tobbas75/trackline/trap-monitor/hardware/Trap Monitor/PCB FILES/preview.webp

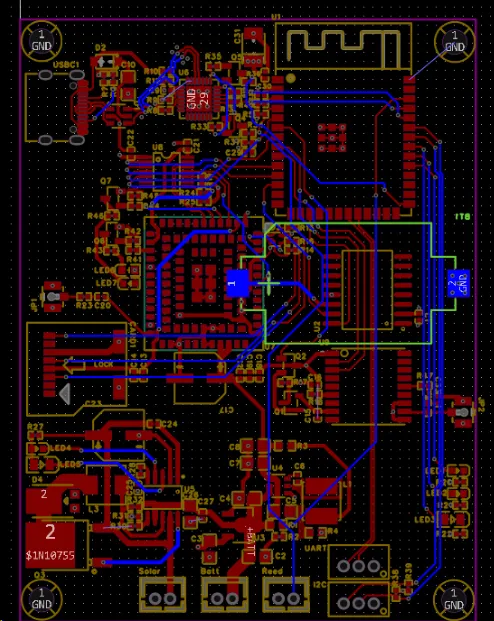
trap-monitor/hardware/Trap Monitor/PCB FILES/preview.webp
