tobbas75/trackline/trap-monitor/hardware/Trap Monitor/PCB FILES/preview (1).webp

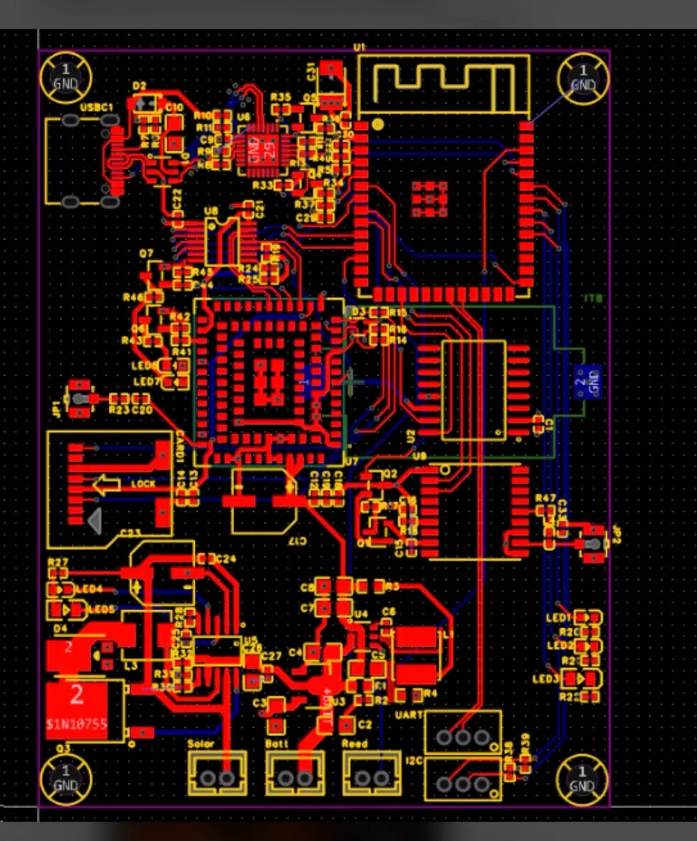
trap-monitor/hardware/Trap Monitor/PCB FILES/preview (1).webp
