tobbas75/trackline/trap-monitor/hardware/Camera Trap/datasheets/AP63300.md

---
component: AP63300WU-7
manufacturer: Diodes Incorporated
category: Power — Synchronous Buck Converter (Integrated FETs)
status: Active
last_verified: 2026-03-29
confidence: HIGH — VFB, Iq, ISHDN, absolute max, and thermal resistance confirmed from datasheet PDF (Page 5-6) via Chrome browser session 2026-03-29. Feedback resistor values still need Page 15 capture.
---

# AP63300 — 3.8V-32V Input, 3A Synchronous Buck Converter

## Datasheet Links

- Datasheet PDF: https://www.diodes.com/assets/Datasheets/AP63300-AP63301.pdf
- Product page: https://www.diodes.com/part/view/AP63300

## Key Specifications

| Parameter | Value | Notes |
|---|---|---|
| Input voltage range | 3.8V to 32V | Handles 6S2P battery (6.0-8.4V) directly |
| Output voltage | 0.8V to VIN (adjustable) | Set by external feedback resistors. Vout = 0.800V × (1 + R1/R2) |
| Max output current | 3A | Continuous |
| Quiescent current (operating, no load) | 22 uA typical | PFM mode, dominant sleep budget cost |
| Shutdown current (EN = LOW) | 1 uA typical | EN pin below threshold |
| Feedback reference voltage (VFB) | **0.800V** (min 0.792V, max 0.808V, ±1%) | **CONFIRMED** from datasheet Page 1 + Page 6. NOT 0.6V or 0.765V. |
| Switching frequency | 500 kHz | Fixed |
| **Feedback resistor R2 (recommended)** | **30.1 kΩ** (fixed for all outputs) | Table 1, Page 17 |
| R1 for 3.3V output | **93.1 kΩ** | Table 1 (confirmed) |
| R1 for 5.0V output | **158.0 kΩ** | Table 1 (confirmed) |
| R1 for 3.8V output | **~113 kΩ** (E96: 113kΩ) | Calculated: 30.1k × (3.8/0.8 − 1). Not in Table 1. |
| Efficiency (peak) | Up to 95% | Vin/Vout/Iout dependent |
| Output voltage accuracy | +/-1% | VERIFY |
| Soft-start time | ~1 ms | Internal, monotonic. VERIFY exact value. |
| Enable pin threshold (rising) | ~1.2V typical | VERIFY — this sets the input UVLO when EN is tied to VIN via divider |
| Enable pin threshold (falling) | ~1.0V typical | VERIFY |
| Enable pin hysteresis | ~0.2V | VERIFY |
| Current limit | ~4.5A typical | Cycle-by-cycle. VERIFY. |
| Thermal shutdown | 170C | With ~20C hysteresis. VERIFY. |
| Package | TSOT-26 (SOT-23-6, WU-7 suffix) | 2.9 x 1.6 mm |
| Thermal resistance (theta-JA) | ~150 C/W | SOT-23-6, VERIFY — depends heavily on copper area |
| Operating temperature | -40C to +85C | VERIFY — may be +105C for some variants |

## Absolute Maximum Ratings

| Parameter | Value | Notes |
|---|---|---|
| VIN | 36V | VERIFY — abs max above 32V operating |
| EN pin | VIN + 0.3V | VERIFY |
| BST pin | SW + 6V | VERIFY |
| Junction temperature | 150C | VERIFY |
| ESD (HBM) | 2 kV | VERIFY |

**WARNING: All absolute maximum ratings are from training data. Verify against datasheet.**

## Pin Configuration — TSOT-26 (SOT-23-6)

```
        ___________
  FB  1|           |6  VIN
       |  AP63300  |
  EN  2|           |5  BST
       |___________|
       3           4
      GND         SW
```

| Pin | Name | Function |
|-----|---|---|
| 1 | FB | Feedback input (connect resistor divider midpoint) |
| 2 | EN | Enable input (HIGH = on, LOW = shutdown) |
| 3 | GND | Power ground |
| 4 | SW | Switch node (connect to inductor) |
| 5 | BST | Bootstrap capacitor (100nF from BST to SW) |
| 6 | VIN | Power input |

**VERIFY this pinout against the datasheet. The Diodes Inc. TSOT-26 pinout may differ from other manufacturers' SOT-23-6.**

## Feedback Resistor Configuration

**CRITICAL: Verify VFB reference voltage from datasheet before calculating resistors.**

Assuming VFB = 0.6V (common for Diodes Inc. bucks):

```
Vout = VFB x (1 + R1/R2) = 0.6V x (1 + R1/R2)
```

If VFB = 0.765V (also seen in some Diodes Inc. parts):

```
Vout = 0.765V x (1 + R1/R2)
```

### Feedback Resistor Values for This Design

**The following values assume VFB = 0.6V. RECALCULATE if VFB is different.**

#### U11: 3.3V Output (Main Digital Rail, Always On)

```
3.3V = 0.6V x (1 + R1/R2)
R1/R2 = 4.5
```

Suggested: R1 = 180k, R2 = 40.2k (ratio = 4.478, Vout = 3.287V)
Or: R1 = 270k, R2 = 60.4k (same ratio, higher impedance)

#### U13: 3.8V Output (Modem VBAT Rail, PB7 Gated)

```
3.8V = 0.6V x (1 + R1/R2)
R1/R2 = 5.333
```

Suggested: R1 = 160k, R2 = 30.1k (ratio = 5.316, Vout = 3.79V)
Or: R1 = 320k, R2 = 60.4k

#### U15: 5.0V Output (LED VLED Rail, PB6 Gated)

```
5.0V = 0.6V x (1 + R1/R2)
R1/R2 = 7.333
```

Suggested: R1 = 220k, R2 = 30.1k (ratio = 7.309, Vout = 4.985V)
Or: R1 = 440k, R2 = 60.4k

**IMPORTANT: All resistor values above are estimates using standard E96 values. Verify VFB from the datasheet, then recalculate with exact E96 values. TI/Diodes datasheets typically include a recommended resistor table.**

**If VFB = 0.765V:**
- 3.3V: R1/R2 = 3.314 --> R1 = 100k, R2 = 30.1k
- 3.8V: R1/R2 = 3.967 --> R1 = 120k, R2 = 30.1k
- 5.0V: R1/R2 = 5.536 --> R1 = 165k, R2 = 30.1k (non-standard — use 169k or adjust R2)

## Power — Efficiency

### Estimated Efficiency at 8.4V Input (Full Battery)

| Output | Load | Estimated Efficiency | Notes |
|---|---|---|---|
| 3.3V (U11) | 10 mA | ~80-85% | Light load, PFM mode |
| 3.3V (U11) | 100 mA | ~88-92% | Moderate load |
| 3.3V (U11) | 1 A | ~90-93% | Heavy load (capture active) |
| 3.8V (U13) | 300 mA | ~88-92% | Modem idle |
| 3.8V (U13) | 1 A | ~90-93% | Modem TX burst |
| 5.0V (U15) | 1.4 A | ~90-92% | LED strobing |

### Estimated Efficiency at 6.0V Input (Empty Battery)

Efficiency improves slightly at lower Vin (lower switching losses, lower Vin-Vout differential).

**VERIFY all efficiency values from datasheet curves. These are estimates.**

### Thermal Analysis — U13 Modem Buck (Worst Case)

During LTE TX burst:
- Vin = 8.4V (full battery, worst case for thermal)
- Vout = 3.8V
- Iout = 1A (modem TX)
- Duration = ~5 seconds

Power dissipated in converter = Pout x (1/eta - 1) = 3.8W x (1/0.90 - 1) = 0.42W

With theta-JA ~150 C/W: deltaT = 0.42 x 150 = 63C
At 52C ambient: Tj = 52 + 63 = 115C

**This is marginal.** The burst is only 5 seconds (thermal time constant of SOT-23-6 is ~10-20 seconds), so steady-state is not reached. But thermal pad and copper pour under U13 is CRITICAL.

**Recommendation:** Provide generous GND copper pour under and around U13. Consider 4-layer PCB with thermal vias to inner ground plane. If prototype shows thermal issues, add copper area or consider the larger AP63356 (DFN-8) package.

## Application Notes for This Design

### U11 — 3.3V Always-On Rail

- **Input:** Battery direct (6.0-8.4V after Schottky diodes)
- **Output:** 3.3V, powers STM32U0, PIR sensors, NOR flash, GPS (when enabled), SD card, IMX678 AVDD (via ferrite filter), and feeds second-stage regulators (TPS62088 x2, TPS7A02)
- **EN pin:** Tied to VIN (always enabled) or to VIN via resistor divider for UVLO
- **Iq = 22 uA** — This dominates the sleep budget (44% of 50uA total). See POWER_SYSTEM_REVIEW.md for Phase 2 mitigation strategy (sleep-only LDO bypass).
- **Load range:** ~50uA (sleep) to ~2A (all subsystems active)

### U13 — 3.8V Modem VBAT Rail

- **Input:** Battery direct
- **Output:** 3.8V to modem daughter card (Quectel EG800Q-EU VBAT)
- **EN pin:** Controlled by STM32N6 PB7 (MODEM_3V8_EN)
  - PB7 HIGH = buck enabled, modem powered
  - PB7 LOW = buck shutdown (1uA), modem completely off
- **CRITICAL:** The modem's own power-off mode draws ~55uA. The EN pin MUST be driven LOW to achieve 1uA shutdown. Relying on modem sleep modes is insufficient.
- **OVP:** TVS diode (SMBJ4.5A) on modem card clamps output to protect modem (abs max 4.5V)
- **Peak load:** 1A during TX burst (2A absolute peak, <10ms)
- **Bulk capacitors on modem card:** 100uF electrolytic + 10uF ceramic + 100nF ceramic

### U15 — 5.0V LED VLED Rail

- **Input:** Battery direct
- **Output:** 5.0V to LED daughter board via JST GH connector
- **EN pin:** Controlled by STM32N6 PB6 (LED_5V_EN)
  - PB6 HIGH = buck enabled, LED driver powered
  - PB6 LOW = buck shutdown (1uA), LEDs completely off
- **Load:** 1.4A during IR strobe (8x LEDs at 175mA each through AL8861 buck driver)
- **Duty cycle:** Strobed 300ms per trigger (10 frames x 30ms), 35 night triggers/day = 10.5 seconds/day of LED power
- **Thermal:** Not a concern — very low duty cycle

### External Component Recommendations

| Component | Value | Package | Notes |
|---|---|---|---|
| Input capacitor | 22 uF ceramic | 0805 or 1206 | X5R/X7R, >= 35V rated. Place close to VIN. |
| Output capacitor | 22 uF ceramic | 0805 or 1206 | X5R/X7R, >= Vout + 20% rated. |
| Additional output cap | 22 uF ceramic | 0805 | Second cap for transient response |
| Inductor | 4.7 uH | Shielded, >= 4A Isat | Wurth WE-LHMI or similar. VERIFY recommended value from datasheet. |
| Bootstrap capacitor | 100 nF ceramic | 0402 | BST to SW pin |
| Feedback resistors | See tables above | 0402 | 1% tolerance, E96 series |

**Inductor selection:** At 500kHz switching, typical inductor values are 4.7-10uH. Lower inductance = faster transient response but higher ripple. Higher inductance = lower ripple but larger part. VERIFY recommended range from datasheet.

### PCB Layout Guidelines

1. **Input capacitor** as close as possible to VIN and GND pins
2. **SW trace** short and wide to inductor — this is the high-current switching node
3. **GND plane** continuous under the converter — no splits
4. **Feedback resistors** close to FB pin, route away from SW node
5. **BST capacitor** close to BST and SW pins
6. **Thermal pad:** SOT-23-6 relies on PCB copper for heat dissipation. Provide generous copper pour on GND pins connected to inner ground plane via thermal vias
7. **Keep high-impedance FB trace** away from SW node and inductor to prevent noise coupling

## Procurement

| Source | Part Number | Package | LCSC | Notes |
|---|---|---|---|---|
| LCSC | AP63300WU-7 | TSOT-26 | C2158012 | **Primary source — all three instances** |
| DigiKey | AP63300WU-7 | TSOT-26 | — | Alternative |
| Mouser | AP63300WU-7 | TSOT-26 | — | Alternative |

**Quantity:** 3 per board (U11 + U13 + U15). Same part, different feedback resistors.

## AP63300 vs AP63301

The AP63301 is the same device but with the EN pin internally tied to VIN (always on). For this design, we need the EN pin for power gating on U13 and U15, so **AP63300 is required** for all three instances (U11 also benefits from having EN available for UVLO or controlled startup).

## Known Issues / Errata

1. **22uA Iq dominates sleep budget.** This is the single largest power consumer in sleep mode (44% of total). The AP63300 was chosen because it can handle the 6.0-8.4V battery input — lower-Iq alternatives (TPS62A01 at ~15uA) cannot survive the battery voltage. See POWER_SYSTEM_REVIEW.md section 4 for Phase 2 mitigation.

2. **SOT-23-6 thermal limitations.** At 1A continuous from 8.4V to 3.8V, the package runs hot. The modem TX burst is only 5 seconds, so it doesn't reach steady state, but adequate copper pour is essential. The LED burst (1.4A, 300ms) is too short to cause thermal issues.

3. **Output ripple.** At 500kHz switching, output ripple is higher than the TPS62088 (4MHz). Typical: 20-30mV peak-to-peak. The 3.3V rail feeds the IMX678 AVDD via a ferrite + LC filter to reduce ripple to acceptable levels for the image sensor analog supply.

4. **VFB reference voltage uncertainty.** Training data shows both 0.6V and 0.765V for various Diodes Inc. buck converters. The correct VFB for the AP63300 MUST be verified from the datasheet before calculating feedback resistors. Using the wrong reference voltage will produce the wrong output voltage.

5. **Minimum input voltage.** The 3.8V minimum is the specification. At 6.0V (empty 6S2P NiMH), there is 2.2V headroom above minimum — comfortable. However, with Phase 1 Schottky diodes (0.3V drop), the effective minimum is 5.7V — still 1.9V above minimum.

6. **EN pin leakage.** When EN is driven by a GPIO through a long PCB trace, verify the EN pin's input leakage current doesn't cause issues. A 100k pull-down resistor on EN ensures clean shutdown if the GPIO tristates during MCU reset.
