tobbas75/trackline/trap-monitor/hardware/Camera Trap/datasheets/EKMB1303112K.md

---
component: EKMB1303112K
manufacturer: Panasonic
category: Sensor — PIR Motion (Digital Output)
status: Active
last_verified: 2026-03-28
confidence: HIGH for core specs (supply voltage, detection range, current, temperature) from Panasonic product pages and distributor listings. LIKELY for output circuit details and pinout from datasheet excerpts and application notes. VERIFY output polarity and pull-down requirement against datasheet before PCB layout.
---

# EKMB1303112K — PaPIRs Digital PIR Motion Sensor, Long-Distance Type

## Datasheet Links

- Product page: https://industrial.panasonic.com/index.php/ww/products/pt/papirs/models/EKMB1303112K
- PaPIRs EKMB catalog (Mouser): https://www.mouser.com/datasheet/2/316/papirs-ekmb-catalog-25574.pdf
- DigiKey listing: https://www.digikey.com/product-detail/en/EKMB1303112K/255-3496-ND/3046811
- RS Components datasheet: https://docs.rs-online.com/0956/0900766b815fdfa5.pdf
- Panasonic application note: https://industrial.panasonic.com/cdbs/www-data/pdf/EWA0000/ast-ind-250613.pdf

## Part Number Decoding

| Segment | Value | Meaning |
|---|---|---|
| EKM | - | PIR sensor family |
| B | - | **EKMB** = ultra-low current (1 uA), digital output, battery-optimised |
| 1303 | - | **Long-distance detection type** (12m range) |
| 112 | - | Lens variant — black polyethylene Fresnel lens |
| K | - | Package/variant suffix |

Other series for reference: EKMC = standard current (170 uA), analog or digital; AMN = legacy series.

## Key Specifications

| Parameter | Value | Notes |
|---|---|---|
| Detection type | Long-distance | 1303 series designation |
| Sensing distance | 12 m | At standard test conditions |
| Detection angle (horizontal) | ~94 deg | Approximate — VERIFY from zone diagram in catalog |
| Detection angle (vertical) | ~82 deg | Approximate — VERIFY from zone diagram in catalog |
| Output type | Open-drain FET to VDD | **ACTIVE HIGH** — see critical note below |
| Output current (max) | 100 uA | FET sourcing from VDD |
| External resistor required | **Pull-DOWN to GND, 47 kohm minimum** | NOT pull-up — see critical note |
| Standby current (Idd) | 1 uA typical | Ultra-low, battery-optimised (EKMB series) |
| Supply voltage (VDD) | 2.3V to 4.0V | |
| Operating temperature | -20C to +60C | Upper limit marginal for tropical enclosure — see design notes |
| Warm-up time | 10 s (spec), 30 s (recommended) | Allow 30 s for thermal stability after power-up |
| Signal output duration | ~2 s | Output pulse length on detection — VERIFY from datasheet |
| Package | TO-5 metal can with Fresnel lens | 3-pin through-hole |
| Lens diameter | ~9.8 mm | Black polyethylene Fresnel lens — VERIFY exact dimension |
| Body diameter (metal can) | ~9.9 mm | TO-5 standard — VERIFY |
| Height (with lens) | ~5.4 mm | VERIFY from mechanical drawing |
| Pin spacing | 2.54 mm | Standard 0.1 inch pitch — VERIFY |
| Weight | ~1.5 g | VERIFY |

## Absolute Maximum Ratings

| Parameter | Value | Notes |
|---|---|---|
| Supply voltage (VDD) | 6.0V | VERIFY — exceeding operating max, do not approach |
| Operating temperature | -20C to +60C | Same as operating range for this series |
| Storage temperature | -40C to +80C | VERIFY from datasheet |
| Output current | 100 uA max | Do not exceed — FET has limited drive |
| Soldering temperature | 260C for 10 s | VERIFY — through-hole part, standard lead-free profile |

**WARNING: Absolute maximum ratings are sourced from distributor listings and datasheet excerpts. Verify every value against the full Panasonic PaPIRs datasheet before design sign-off.**

## Pin Configuration

**Package: TO-5, 3-pin, bottom view (looking at pins from below)**

```
    ┌───────────┐
    │   Fresnel  │
    │    Lens    │
    │           │
    │  (1)  (2) │
    │     (3)   │
    └───────────┘
     Bottom view
```

| Pin | Name | Function |
|-----|---|---|
| 1 | VDD | Supply voltage (2.3-4.0V) |
| 2 | OUT (Drain) | Signal output — open-drain FET to VDD |
| 3 | GND (VSS) | Ground |

**VERIFY pin assignment from datasheet mechanical drawing. Pin identification by tab/flat on TO-5 can.**

## Output Circuit — CRITICAL DESIGN NOTE

**This is ACTIVE HIGH with a pull-DOWN resistor. This is NOT the typical open-drain-to-ground with pull-UP that most engineers assume.**

### How the output works

```
         VDD (2.3-4.0V)
          │
          ├──── Internal P-FET (source)
          │
          ├──── Pin 2 (OUT / Drain)
          │
          ├──── External 47k+ pull-DOWN to GND
          │
         GND
```

- **Idle (no detection):** Internal FET is OFF. Pin 2 floats (high impedance). External pull-down resistor pulls output LOW.
- **Detection:** Internal FET turns ON, sourcing current from VDD through FET to Pin 2. Output goes HIGH (approximately VDD minus FET Vds).
- **Output returns LOW** after detection pulse ends (~2 s) and FET turns OFF again.

### External pull-down resistor selection

The pull-down resistor must be chosen so that output current does not exceed 100 uA:

```
R_pulldown >= VDD / I_out_max
R_pulldown >= 4.0V / 100 uA = 40 kohm (minimum)
```

**Use 47 kohm or higher.** In this design: 47 kohm to GND (as specified in BOM.csv).

### Why this matters

Most PIR sensors (and most open-drain outputs generally) use an N-FET that sinks to GND, requiring a pull-UP resistor and producing an ACTIVE LOW output. The Panasonic EKMB does the opposite. If you wire it with a pull-up (as instinct suggests for "open drain"), you get VDD on the output pin at all times and never see a detection edge.

**config.h cross-reference:** PIR signals connect to STM32U0 (U0_PA0 for PIR_1, U0_PA1 for PIR_2). The U0 aggregates PIR events and wakes the STM32N6 via PIR_WAKE_FROM_U0_PIN (PG3). U0 firmware must configure EXTI on rising edge for ACTIVE HIGH.

## Detection Zone Pattern

The EKMB1303112K uses a black polyethylene Fresnel lens that creates a multi-zone detection pattern. The "1303" long-distance type has a narrower, deeper detection cone optimised for long range (12 m) rather than wide coverage.

**Zone layout (approximate — VERIFY from Panasonic catalog zone diagram):**

- Multiple detection zones arranged in a roughly conical pattern
- Horizontal coverage: ~94 deg total
- Vertical coverage: ~82 deg total
- Zone density is higher at centre, sparser at edges
- Each zone is a sector where the Fresnel lens focuses thermal IR onto the pyroelectric element
- Movement between zones (not within a single zone) triggers detection

**Dual-PIR configuration in this design:** Two EKMB1303112K sensors are angled to provide overlapping coverage across the camera field of view. Firmware on the STM32U0 OR-gates both PIR outputs — either sensor triggers a capture burst.

## Power

| State | Current | Notes |
|---|---|---|
| Standby (sensing) | 1 uA | Dominant sleep budget component is elsewhere |
| During detection pulse | ~100 uA max | Through pull-down resistor, brief |

At 3.3V supply with 47 kohm pull-down:
- Standby: 1 uA (sensor) + ~0 uA (pull-down, output LOW/float)
- Detection pulse: 1 uA (sensor) + ~70 uA (3.3V / 47k through pull-down) = ~71 uA for ~2 s

**Total daily contribution (70 triggers/day, ~2 s each):** ~140 s at ~71 uA = ~0.003 mAh — negligible.

## Application Notes for This Design

1. **Supply voltage:** Fed from 3.3V rail (always-on AP63300 U11). Within 2.3-4.0V operating range.

2. **Output connection:** Pin 2 (OUT) connects to STM32U0 GPIO with 47 kohm pull-down to GND. EXTI configured for **rising edge** (active HIGH).

3. **Warm-up blanking:** After power-up, ignore PIR outputs for 30 seconds. The spec says 10 s minimum, but thermal stability improves significantly at 30 s. Firmware on U0 implements this blanking window.

4. **PIR lockout:** config.h defines PIR_LOCKOUT_S = 5 seconds between triggers. This prevents rapid re-triggering from the same animal.

5. **Temperature concern:** Operating range is -20C to +60C. The white/light enclosure is critical — black enclosures reach 70C+ in tropical sun, which exceeds the sensor's rating. With white IP67 polycarbonate enclosure, internal temperature should stay within spec.

6. **Lens orientation:** The long-axis of the Fresnel lens pattern should be aligned with the expected animal travel direction for maximum sensitivity. In this design, both PIRs are oriented to cover the camera's field of view.

7. **Mounting:** Through-hole TO-5 package. Solder directly to main board with lens protruding through enclosure front panel. Seal with silicone gasket around lens.

## Procurement

| Source | Part Number | Stock Status | Unit Price (AUD) |
|---|---|---|---|
| DigiKey AU | 255-3496-ND | In stock | ~$7.50 |
| Mouser | - | In stock | ~$7.50 |
| RS Components | 161-2217 | In stock | ~$7.00 |

**Lead time:** Generally in stock. Standard Panasonic distribution.

## Known Issues

1. **Output polarity confusion.** The single most common mistake with this sensor. Document prominently in schematic, BOM, and review guide. The BOM.csv already notes "ACTIVE HIGH output (pull-DOWN 47k to GND, NOT pull-up)".

2. **60C upper temperature limit.** Marginal for tropical deployment. Enclosure colour and ventilation are critical. Monitor field temperature data from first deployments.

3. **No sensitivity adjustment.** The EKMB series has fixed sensitivity set by the internal signal processing. Cannot be tuned in firmware. If detection range needs changing, a different lens variant (different part number suffix) is required.

4. **Blanking period after detection.** The sensor has an internal blanking period (~2 s) after each detection. Combined with firmware lockout (5 s), effective retrigger time is ~5 s minimum.

5. **False triggers from thermal transients.** Rapid temperature changes (cloud shadow, rain splash) can cause false triggers. The dual-PIR AND/OR logic in firmware can help filter these — currently OR-gated (either PIR triggers), but could be changed to AND-gated (both PIRs must trigger) for noisy environments at the cost of detection coverage.
