tobbas75/trackline/trap-monitor/hardware/Camera Trap/datasheets/IMX678.md

---
component: IMX678-AAQR1-C
manufacturer: Sony Semiconductor Solutions
category: Image Sensor
status: Active
last_verified: 2026-03-29
confidence: MIXED — register map verified from Linux driver source; power rails and timing from Sony flyer and public documentation; full datasheet is NDA-restricted
---

# IMX678-AAQR1-C — 8MP STARVIS 2 CMOS Image Sensor

## NDA Notice

The full IMX678 datasheet is restricted under NDA from Sony Semiconductor Solutions.
Access requires a distributor relationship via **FRAMOS** (Europe/Americas) or **Macnica** (Asia-Pacific).

**What is publicly available:**
- Sony product flyer (basic specs, block diagram, package outline)
- Khadas preliminary datasheet v0.1 (partial — leaked/mirror, not authorised)
- FRAMOS FSM-IMX678 module datasheet (module-level specs, some sensor detail)
- Linux v4l2 driver source (register map, timing, clock configs — reverse-engineered/NDA-derived)
- Macnica product page (marketing specs)

**What requires NDA access:**
- Full register map with bit-field descriptions
- Detailed power-on/power-off sequence timing diagrams
- Complete electrical characteristics (min/typ/max for all rails)
- Absolute maximum ratings (complete table)
- Detailed MIPI CSI-2 D-PHY timing parameters
- Optical characteristics (spectral response curves, quantum efficiency)
- Reliability data and qualification reports

## Datasheet Links

| Source | URL | Access |
|---|-----|---|
| Sony product flyer | https://www.sony-semicon.com/files/62/flyer_security/IMX678-AAQR1_Flyer.pdf | Public |
| Khadas mirror (v0.1 preliminary) | https://dl.khadas.com/products/add-ons/cameras/imx678/datasheet/imx678-aaqr1-c_technical-datasheet_e_0.1.pdf | Public (unofficial) |
| FRAMOS FSM-IMX678 module | https://www.mouser.com/datasheet/2/1051/FSM_IMX678_Datasheet-3512461.pdf | Public (module-level) |
| Macnica product page | https://www.macnica.com/americas/mai/en/products/semiconductors/sony-image-sensors/sony-imx678-aaqr1/ | Public |
| Linux v4l2 driver (register map) | https://github.com/will127534/imx678-v4l2-driver | Public (GPL) |
| Sony ISP portal (full datasheet) | Via FRAMOS/Macnica NDA | ~~NDA required~~ **OBTAINED** |
| **Production datasheet E21Y08A29** | Local: `datasheets/imx678-datasheet-E21Y08A29.pdf` | **56 pages, Maison Technologies watermark. All TBDs filled. STARVIS 2.** |
| **Tentative datasheet Rev 0.1** | Local: `datasheets/imx678-datasheet.pdf` | **53 pages, Sunnic watermark. Some TBDs remain. Has peripheral circuit.** |

## Key Specifications

| Parameter | Value | Source | Confidence |
|---|---|---|---|
| Optical format | 1/1.8" (Type 1/1.8) | Sony flyer | Verified |
| Pixel size | 2.0 µm × 2.0 µm | Sony flyer | Verified |
| Effective pixels | 3840 (H) × 2160 (V) = 8.29 MP | Sony flyer / driver | Verified |
| Native array (incl. OB) | 3856 (H) × 2180 (V) | Linux driver | Verified (from driver) |
| Pixel array offset | 8 pixels left, 8 pixels top | Linux driver | Verified (from driver) |
| Technology | STARVIS 2 (back-illuminated) | Sony flyer | Verified |
| Colour filter | Bayer RGB (RGGB) — AAQR1 variant | Sony flyer | Verified |
| ADC resolution | 12-bit (native), 11-bit + dither mode | Linux driver | Verified (from driver) |
| HDR | ClearHDR (Sony proprietary DOL-HDR) | Sony flyer / driver | Verified |
| Output interface | MIPI CSI-2 (2-lane or 4-lane) | Sony flyer / driver | Verified |
| Control interface | I2C (SCCB compatible) | Sony flyer / driver | Verified |
| I2C address | 0x1A (7-bit) | Linux driver / config.h | Verified (from driver) |
| Operating temperature | **-30°C to +85°C** | Production datasheet Page 3 | **CONFIRMED** |
| Performance guarantee temp | **-10°C to +60°C** | Production datasheet Page 3 | **CONFIRMED** |
| Storage temperature | **-40°C to +85°C** | Production datasheet Page 3 | **CONFIRMED** |

## Power Supply Rails

### Application Conditions — CONFIRMED from Production Datasheet (E21Y08A29 Page 3/14)

| Rail | Symbol | Min | Typ | Max | Unit |
|---|---|-----|-----|-----|---|
| Analog supply | AVDD | **3.20** | 3.30 | **3.40** | V |
| Digital I/O | OVDD | **1.70** | 1.80 | **1.90** | V |
| Digital core | DVDD | **1.00** | 1.10 | **1.20** | V |

Driver regulator names: `VANA` = AVDD (3.3V), `VDIG` = DVDD (1.1V), `VDDL` = DOVDD (1.8V).

### Current Consumption — CONFIRMED from Production Datasheet (E21Y08A29 Page 15)

Measured at 4-lane×2ch, 1188 Mbps, 12-bit, 60fps, all-pixel mode.

| Condition | Rail | Symbol | Typ | Max | Unit |
|---|---|---|-----|-----|---|
| **Operating** | AVDD (3.3V) | IAVDD | **69** | **86** | mA |
| | OVDD (1.8V) | IOVDD | **4** | **5** | mA |
| | DVDD (1.1V) | IDVDD | **162** | **175** | mA |
| **Standby** | AVDD (3.3V) | IAVDD_STB | — | **0.3** | mA |
| | OVDD (1.8V) | IOVDD_STB | — | **0.1** | mA |
| | DVDD (1.1V) | IDVDD_STB | — | **28** | mA |

**Operating total power (typ):** 69×3.3 + 4×1.8 + 162×1.1 = 228 + 7 + 178 = **~413 mW**
**Standby total power (max):** 0.3×3.3 + 0.1×1.8 + 28×1.1 = 1.0 + 0.2 + 30.8 = **~32 mW** (this is why we hard power-gate)

> **Note:** These figures are at 4-lane×2ch mode. Our design uses 2-lane mode — DVDD current will be lower (fewer MIPI drivers active). Estimated 2-lane operating: IDVDD ~100-130 mA max.

### Sensitivity — CONFIRMED from Production Datasheet (E21Y08A29 Page 23)

Measured at AVDD=3.3V, OVDD=1.8V, DVDD=1.1V, Tj=60°C, all-pixel, 12-bit, 30fps, 0dB gain.

| Parameter | Min | Typ | Unit | Mode |
|---|-----|-----|---|---|
| G sensitivity (HCG) | 13493 (3009 mV) | **16309** (3637 mV) | Digit/lx/s | HCG, F5.6 |
| G sensitivity (LCG) | 5197 (1159 mV) | **6117** (1364 mV) | Digit/lx/s | LCG, F5.6 |
| Saturation (LCG) | **3895** (868 mV) | — | Digit | 12-bit |
| HCG/LCG ratio | 2.4 | **2.7** | — | — |

**1 Digit = 0.2230 mV (12-bit), 0.8925 mV (10-bit)**

### Spectral Response — CONFIRMED from Production Datasheet (E21Y08A29 Page 22)

The spectral sensitivity chart (wafer-level) shows:
- **Peak sensitivity** at ~500nm (green) and ~800nm (NIR) — the characteristic STARVIS 2 dual-peak
- All three channels (R, G, B) converge above 750nm where the Bayer filter becomes transparent
- **At 850nm:** relative response ~0.85 (all channels) — excellent for 850nm IR illumination
- **At 940nm:** relative response ~0.45-0.50 (all channels) — usable for 940nm covert IR
- **At 1000nm:** relative response ~0.15-0.20 — dropping off but still detectable
- **Cutoff ~1050nm** — consistent with silicon bandgap

> This confirms that 940nm covert IR illumination will produce usable images. The STARVIS 2 uneven photodiode surface enhances NIR absorption — the 940nm response is approximately 2× better than comparable STARVIS 1 sensors at the same pixel size.

## Power-On Sequence

**Sequence CONFIRMED from production datasheet E21Y08A29 Pages 41-43:**

1. **DVDD (1.1V)** — enable first
2. **DOVDD (1.8V)** — enable second
3. **AVDD (3.3V)** — enable third
4. All rails must be stable within 200 ms of sequence start (unverified — commonly cited but may be from preliminary docs)
5. After all rails stable, release XCLR (drive HIGH)
6. Wait for sensor internal PLL lock before I2C access

**Power-off sequence:** Reverse order (assert XCLR LOW, then disable AVDD → DOVDD → DVDD).

**From Linux driver timing constants:**
- XCLR release delay: 500 ms (conservative — driver uses 500,000 µs)
- XCLR delay range: 1 ms
- Stream enable delay: 25 ms after mode registers written
- Stream delay range: 1 ms

## Pin Configuration

The IMX678 uses a **132-pin LGA** package (confirmed Sony flyer Ver. 2.0). Full pinout requires NDA.

### Drive Modes — CONFIRMED from Sony Flyer Ver. 2.0

| Drive Mode | Recording Pixels | Max FPS (10-bit) | Max FPS (12-bit) |
|---|---|---|---|
| All-pixel scan | 3840 × 2160 (8.29M) | **72 fps** | **60 fps** |
| H/V 2/2-line binning | 1920 × 1080 (2.07M) | **72 fps** | — |

### Physical — CONFIRMED from Sony Flyer

| Parameter | Value |
|---|---|
| Image size | Diagonal 8.86mm (Type 1/1.8") |
| Total pixels | 3856 (H) × 2200 (V) |
| Effective pixels | 3856 (H) × 2180 (V) |
| Recommended recording | 3840 (H) × 2160 (V) |
| Unit cell | 2.0 × 2.0 µm |
| Package | **132-pin LGA** |

### Khadas Datasheet — UNAVAILABLE
Khadas-hosted Sony technical datasheet (imx678-aaqr1-c_technical-datasheet_e_0.1.pdf) returns 404 as of March 2026. The Khadas docs page exists but shows "This topic does not exist yet". **Full electrical specs remain NDA-restricted via FRAMOS/Macnica.**

**Key functional pins (from public sources):**

| Pin | Function | Notes |
|-----|---|---|
| INCK | Input clock | External oscillator input (24 MHz in this design) |
| XCLR | Reset | Active LOW. Must be held LOW during power-up, released after rails stable. Driver treats as active-high GPIO (inverted in HW or DT). |
| SDA | I2C data | DOVDD-referenced (1.8V). Requires level shifting from 3.3V MCU. |
| SCL | I2C clock | DOVDD-referenced (1.8V). Requires level shifting from 3.3V MCU. |
| MIPI_CLK_P/N | CSI-2 clock lane | Differential, DOVDD-referenced |
| MIPI_D0_P/N | CSI-2 data lane 0 | Differential |
| MIPI_D1_P/N | CSI-2 data lane 1 | Differential |
| MIPI_D2_P/N | CSI-2 data lane 2 | 4-lane mode only |
| MIPI_D3_P/N | CSI-2 data lane 3 | 4-lane mode only |
| XVS | Vertical sync output/input | Configurable direction (leader/follower) |
| XHS | Horizontal sync output/input | Configurable direction (leader/follower) |
| PWDN | Power-down | Active HIGH (DOVDD-referenced). Pull-up to 1.8V = standby on boot. |

## MIPI CSI-2 Interface

### Lane Configuration (from Linux driver — verified)

| Register | Address | Value | Meaning |
|---|---|---|---|
| LANEMODE | 0x3040 | 0x01 | 2-lane mode |
| LANEMODE | 0x3040 | 0x03 | 4-lane mode |

### Supported Link Frequencies (from Linux driver — verified)

| DATARATE_SEL | Link Frequency | Data Rate per Lane | Notes |
|---|---|---|---|
| 0x07 | 297 MHz | 594 Mbps | Lowest |
| 0x06 | 360 MHz | 720 Mbps | |
| 0x05 | 445.5 MHz | 891 Mbps | |
| 0x04 | 594 MHz | 1188 Mbps | |
| 0x03 | 720 MHz | 1440 Mbps | Default in RPi driver |
| 0x02 | 891 MHz | 1782 Mbps | |
| 0x01 | 1039.5 MHz | 2079 Mbps | |
| 0x00 | 1188 MHz | 2376 Mbps | Highest — D-PHY v1.2 max |

**D-PHY version:** Likely D-PHY v1.2 based on max 2376 Mbps/lane. Needs NDA confirmation.

### Frame Rates (from Linux driver — verified)

**4K (3856 × 2180), 4-lane, 12-bit:**

| Link Frequency | Min HMAX | Approx Max FPS |
|---|---|---|
| 297 MHz | 1584 | ~21 fps |
| 445.5 MHz | 1100 | ~30 fps |
| 720 MHz | 660 | ~50 fps |
| 1188 MHz | 396 | ~83 fps |

**1080p binned (1928 × 1090), 4-lane:** Halve the HMAX values above (double the frame rate).

**2-lane mode:** Double the HMAX values (halve the frame rate).

## Input Clock (INCK)

### Supported Frequencies (from Linux driver — verified)

| XCLK Frequency | INCK_SEL Register (0x3014) |
|---|---|
| 74.250 MHz | 0x00 |
| 37.125 MHz | 0x01 |
| 72.000 MHz | 0x02 |
| 27.000 MHz | 0x03 |
| **24.000 MHz** | **0x04** — used in this design |
| 36.000 MHz | 0x05 |
| 18.000 MHz | 0x06 |
| 13.500 MHz | 0x07 |

**Pixel rate:** 74.25 MHz (constant, independent of INCK selection — internal PLL generates this).

**This design uses 24.000 MHz** from a dedicated SiT8008 MEMS oscillator (Y2), wired directly to the IMX678 INCK pin. The oscillator is power-gated with the sensor 1.8V rail.

> **All 8 frequencies confirmed** by both the Sony AAQR1 flyer (Ver. 2.0 Page 1) and Linux V4L2 driver register map. The register values above are from the driver; the frequency list from Sony matches exactly.

## Image Sensor Characteristics — CONFIRMED from Sony Flyer Ver. 2.0 Page 2

| Parameter | Value | Condition |
|---|---|---|
| Sensitivity (F5.6) | Typ. **15886 Digit/lx/s** | 12-bit converted, Tj = 60°C |
| Saturation signal | Min. **3895 Digit** | 12-bit converted, Tj = 60°C |

### Gain — from Sony Flyer Page 1

| Range | Type | Step |
|---|---|---|
| 0 dB to 30 dB | Analog gain (CDS/PGA) | 0.3 dB |
| 30.3 dB to 72 dB | Analog 30dB + Digital 0.3-42 dB | 0.3 dB |

### HDR Modes — from Sony Flyer Page 1

- **DOL HDR** (Digital Overlap): Two successive exposures (short + long), synthesized. Slight time lapse between shots — can cause motion artifacts.
- **Clear HDR**: Two simultaneous captures at different gain levels (low for bright regions, high for dark regions), synthesized. No motion artifacts — better for moving targets like animals.

> **For this camera trap:** Clear HDR is the preferred mode if HDR is implemented (Phase 2). DOL HDR would cause motion blur on fast-moving animals. However, HDR halves frame rate — at 72fps base, Clear HDR gives 36fps. Not planned for Phase 1.

### STARVIS 2 Technology — from Sony/Macnica Technology Guide

- Back-illuminated pixel with deeper photodiodes + uneven surface textures
- NIR sensitivity enhanced by refracting incident light deeper into silicon
- Sensitivity ≥2000 mV/µm² (706 cd/m², F5.6, 1s accumulation)
- Dynamic range >8dB wider than STARVIS 1 at same pixel size (12-bit single exposure)
- NIR improvement comes from photodiode structure, not filter — works across entire NIR band to silicon cutoff (~1050nm)

### CSI-2 Output Options — from Sony Flyer Page 1

| Mode | Lanes | Notes |
|---|---|---|
| 2-lane | 2 | **Used in this design** (STM32N6 has 2-lane CSI-2 only) |
| 4-lane | 4 | Higher throughput, not available on STM32N6 |
| 8-lane | 8 | For high-end NVR/ISP chips |
| 4-lane × 2ch | 4+4 | Dual independent outputs |

Output formats: RAW10, RAW12.

## XCLR Reset Pin

| Parameter | Value | Source |
|---|---|---|
| Active level | LOW (assert LOW to reset) | Linux driver / config.h |
| Pull-up | 10 kΩ to DOVDD (1.8V) | Design spec |
| Release delay | 500 ms after power rails stable | Linux driver (conservative) |
| Interface level | DOVDD-referenced (1.8V) | Design spec |

**Implementation note:** STM32N6 PC8 is on VDDIO4 (3.3V). Open-drain output mode is mandatory to avoid driving 3.3V into the 1.8V sensor input. The 10 kΩ pull-up to 1.8V provides the HIGH level.

## 2×2 Binning Mode

| Register | Address | Value | Mode |
|---|---|---|---|
| ADDMODE | 0x301B | 0x00 | No binning (full 4K: 3856 × 2180) |
| ADDMODE | 0x301B | 0x01 | 2×2 binning (1080p: 1928 × 1090) |

**Binning benefits:**
- Doubles frame rate at same link frequency
- Improves low-light sensitivity (~6 dB gain from 4-pixel summation)
- Used for night mode in this design (with 940nm IR strobed illumination)
- Reduces PSRAM bandwidth requirement

## NIR Response

| Parameter | Value | Confidence |
|---|---|---|
| Technology | STARVIS 2 back-illuminated — enhanced NIR QE vs front-illuminated | Verified (Sony marketing) |
| Useful NIR range | Good response at 850nm and 940nm | Likely — consistent with STARVIS 2 marketing |
| NIR cutoff | ~1050 nm (approximate) | Uncertain — needs spectral response curve from NDA datasheet |
| 940nm covert operation | Yes — adequate sensitivity for strobed IR | Likely — based on STARVIS 2 product positioning for security |

**Design note:** This camera uses 940nm covert IR (no visible glow). The IMX678 STARVIS 2 technology was specifically chosen for its improved NIR quantum efficiency vs earlier STARVIS 1 sensors. Exact QE at 940nm requires the NDA spectral response data.

## Key Register Map (from Linux driver — verified)

| Register | Address | Description | Notes |
|---|---|---|---|
| MODE_SELECT | 0x3000 | Streaming control | 0x00=streaming, 0x01=standby |
| REG_HOLD | 0x3001 | Group parameter hold | |
| XMSTA | 0x3002 | Leader mode control | |
| INCK_SEL | 0x3014 | Input clock selection | See clock table above |
| DATARATE_SEL | 0x3015 | MIPI link speed | See link frequency table above |
| WDMODE | 0x301A | Window mode | 0x00=normal |
| ADDMODE | 0x301B | Binning mode | 0x00=none, 0x01=2×2 |
| FLIP_H | 0x3020 | Horizontal flip | |
| FLIP_V | 0x3021 | Vertical flip | |
| ADBIT | 0x3022 | ADC bit depth | 0x01=11-bit+dither |
| MDBIT | 0x3023 | Output bit depth | 0x01=12-bit |
| VMAX | 0x3028 | Vertical timing (20-bit) | Max 0xFFFFF |
| HMAX | 0x302C | Horizontal timing (16-bit) | Max 0xFFFF |
| SHR | 0x3050 | Shutter (exposure) | Min 8 (normal), 10 (ClearHDR) |
| FDG_SEL0 | 0x3030 | HCG/LCG channel select | |
| LANEMODE | 0x3040 | Lane count | 0x01=2-lane, 0x03=4-lane |
| ANALOG_GAIN | 0x3070 | Analog gain | 0–240 (normal), min 34 (HCG), max 80 (HDR) |
| XXS_OUTSEL | 0x30A4 | XVS/XHS output select | |
| XXS_DRV | 0x30A6 | XVS/XHS drive control | |
| XVSLNG | 0x30CC | XVS pulse length | |
| XHSLNG | 0x30CD | XHS pulse length | |
| EXTMODE | 0x30CE | External sync enable | |
| BLKLEVEL | 0x30DC | Black level | Default 50, max 4095 |
| DIGITAL_CLAMP | 0x3458 | Digital clamp enable | |

**Note:** No dedicated chip ID register exists on the IMX678. The Linux driver reads the BLKLEVEL register (0x30DC) to verify I2C connectivity.

## Synchronisation Modes

The IMX678 supports three sync modes (from Linux driver):

| Mode | sync-mode DT | Description |
|---|---|---|
| Internal Leader | 0x00 | Sensor drives XVS/XHS outputs (default, used in this design) |
| External Leader | 0x01 | Accepts XVS input, drives XHS output |
| Follower | 0x02 | Both XVS and XHS are inputs |

## Variants

| Part Number | Variant | Notes |
|---|---|---|
| IMX678-AAQR1-C | Colour (Bayer RGGB) | Used in this design |
| IMX678-AAMR1 | Monochrome | Same package, same voltages, no colour filter array |

Both variants share the same power rails (AVDD=3.3V, DVDD=1.1V, DOVDD=1.8V) and MIPI interface. The monochrome variant has ~2× better sensitivity due to no CFA light loss.

## Absolute Maximum Ratings — CONFIRMED from Production Datasheet (Page 3)

| Parameter | Symbol | Min | Max | Unit |
|---|---|-----|-----|---|
| AVDD (analog 3.3V) | AVDD | -0.3 | **3.65** | V |
| OVDD (interface 1.8V) | OVDD | -0.3 | **3.65** | V |
| DVDD (digital 1.1V) | DVDD | -0.3 | **2.0** | V |
| Input voltage | VI | -0.3 | OVDD + 0.3 (max 3.3V) | V |
| Output voltage | VO | -0.3 | OVDD + 0.3 (max 3.3V) | V |
| Operating temperature | Topr | **-30** | **+85** | °C |
| Storage temperature | Tstg | **-40** | **+85** | °C |

### Power-On Sequence Timing — CONFIRMED from Production Datasheet (Page 41)

| Parameter | Symbol | Min | Max | Unit |
|---|---|-----|-----|---|
| DVDD → OVDD rising | T0 | 0 | — | ns |
| OVDD → AVDD rising | T1 | 0 | — | ns |
| All rails rise time | T2 | — | **200** | ms |
| AVDD stable → XCLR release | TLOW | **500** | — | ns |
| XCLR release → INCK start | T3 | **1** | — | µs |
| XCLR release → I2C start | T4 | **20** | — | µs |
| Standby cancel → XVS/XHS (slave) | TSYNC | **24** | — | ms |
| Internal regulator stabilization | — | **24** | — | ms |
| Image stabilization after streaming | — | **8 frames** | — | — |

### Slew Rate Limits — CONFIRMED from Production Datasheet (Page 42)

| Rail | Max Slew Rate |
|---|---|
| DVDD (1.1V) | **25 mV/µs** |
| OVDD (1.8V) | **25 mV/µs** |
| AVDD (3.3V) | **25 mV/µs** |

> **Design implication:** The TPS62088 (DVDD) and TPS7A02 (OVDD) output slew rates are well within 25 mV/µs — their soft-start ramps over milliseconds, not microseconds. The AP63300 (AVDD via ferrite+LC) may need verification — the LC filter naturally limits slew rate.

### I2C Fast-mode Plus — CONFIRMED from Production Datasheet (Page 20)

| Parameter | Min | Max | Unit | Condition |
|---|-----|-----|---|---|
| SCL frequency | 0 | **1000** | kHz | INCK ≥ 16 MHz |
| Rise time (SDA/SCL) | — | 120 | ns | |
| Fall time (SDA/SCL) | — | 120 | ns | |

> **Design note:** The sensor supports I2C FM+ (1MHz) when INCK ≥ 16MHz. Our 24MHz INCK qualifies. However, our BSS138 level shifters limit practical speed to ~400kHz. FM+ would require stronger pull-ups and lower capacitance — not worth the complexity for register configuration.

## Application Notes for This Design

### Power Rail Implementation
- **AVDD (3.3V):** Fed from AP63300 3.3V rail (U11) via ferrite bead + LC filter for analog noise isolation
- **DVDD (1.1V):** Dedicated TPS62088 (U10b). Cannot share with STM32N6 VDDCORE (0.81V/0.89V)
- **DOVDD (1.8V):** TPS7A02 LDO (U12), shared with PSRAM VDD/VDDQ and STM32N6 VDDIO_XSPI1. Low noise critical for image quality.

### Level Shifting
- I2C (SDA/SCL): BSS138 discrete level shifters, 3.3V MCU side ↔ 1.8V sensor side
- XCLR: Open-drain GPIO (PC8) with 10 kΩ pull-up to 1.8V
- PWDN: Open-drain GPIO (PD2) with 10 kΩ pull-up to 1.8V

### Clock
- Dedicated 24 MHz MEMS oscillator (SiT8008, Y2) wired directly to INCK
- Oscillator powered from 1.8V rail — power-gated with sensor
- No MCU clock output used (MCO1 has no usable pin on this package)

### MIPI CSI-2
- 2-lane mode used in this design (STM32N6 CSI-2 interface is 2-lane)
- Dedicated D-PHY pads on STM32N6 (not GPIO-muxed)
- 100 Ω differential impedance routing required
- Target link frequency: 720 MHz (1440 Mbps/lane) for 4K @ ~33 fps

## Procurement

| Source | Role | Notes |
|---|---|---|
| FRAMOS | Authorised Sony distributor (modules + bare sensors) | FSM-IMX678 module available for prototyping. NDA access for full datasheet. |
| Macnica | Authorised Sony distributor (Asia-Pacific) | Bare sensor supply for production. |
| Sony direct | Volume production | Requires design-in registration via distributor |

**Lead time:** Typically 12-16 weeks for bare sensors. FRAMOS FSM-IMX678 modules may have shorter lead times for prototype quantities. Verify current availability — supply chain for STARVIS 2 sensors has been constrained.

**Pricing:** ~$20 AUD per unit at low volume (from BOM). Volume pricing requires NDA/quote from distributor.

## Known Issues / Errata

1. **No chip ID register.** The IMX678 lacks a dedicated chip ID register (unlike many other sensors). The Linux driver reads the black level register (0x30DC) to verify I2C bus connectivity. This is adequate but not a true identification mechanism.

2. **NDA barrier.** Full register documentation, timing diagrams, and electrical limits require NDA. The Linux driver provides a practical register map, but bit-field details for some registers are incomplete.

3. **XCLR timing is conservative in the Linux driver.** The driver uses a 500 ms delay after XCLR release. Sony's actual requirement may be shorter (likely 10-50 ms for PLL lock), but without NDA datasheet confirmation, the conservative delay is prudent.

4. **ClearHDR mode halves frame rate.** If HDR is enabled, expect ~50% frame rate reduction. For this camera trap application, HDR is not planned for Phase 1.

5. **PWDN pin polarity.** Active HIGH = power-down/standby. This is the opposite convention from some other Sony sensors (e.g., IMX219 where PWDN is active LOW). The design correctly uses a pull-up to 1.8V (standby on boot) and drives LOW to activate.
