tobbas75/trackline/trap-monitor/hardware/Camera Trap/datasheets/Molex_209142-0180.md

---
component: Molex 209142-0180
type: LTE Flexible PCB Antenna
manufacturer: Molex
package: Flex PCB with adhesive mount
status: SUGGESTED REPLACEMENT — original BOM PN 2132510100 not found at any distributor
verified_orderable: true (DigiKey, Mouser, Farnell, element14 AU, Newark, TME)
last_updated: 2026-03-28
confidence: LIKELY — specs from distributor listings and Molex product page; full datasheet PDF not reviewed this session
datasheet_url: https://www.molex.com/content/dam/molex/molex-dot-com/products/automated/en-us/productspecificationpdf/209/209142/2091420180-001.pdf
product_page: https://www.molex.com/en-us/products/part-detail/2091420180
---

# Molex 209142-0180 — LTE Flexible PCB Antenna

## Summary

Flexible PCB monopole antenna for 4G/LTE covering 698-4000 MHz. Adhesive-mount with 180mm coaxial cable and U.FL/MHF connector. Intended as the cellular antenna for the EG800Q-EU modem daughter card.

**Replaces:** Original BOM entry PN 2132510100 which was not found at any distributor. This part (209142-0180) is confirmed orderable from multiple sources.

## Key Specifications

| Parameter | Value | Notes |
|---|---|---|
| Frequency Range | 698 - 4000 MHz | Covers 2G, 3G, 4G LTE full bands |
| Antenna Type | Monopole, flexible PCB | Polymer substrate, 0.1mm thick |
| Impedance | 50 ohm | |
| Polarization | Linear | |
| Max Input Power | 2W | |
| Connector | U.FL / I-PEX MHF compatible | 50 ohm coaxial |
| Cable Length | 180mm | 1.13mm diameter coaxial |
| Mounting | Self-adhesive (peel and stick) | Non-metal surface required |
| Dimensions | 85 x 14.5 x 0.1 mm | Antenna element only |
| Weight | Not specified in available data | Likely < 5g |
| Operating Temp | Not confirmed from datasheet | Typical for Molex antennas: -40 to +85 C |
| RoHS | Compliant | |

## Gain by Band

| Band | Frequency Range | Gain | Notes |
|---|---|---|---|
| Low band (LTE B28, 2G 900) | 698 - 960 MHz | ~1.2 dBi | Band 28 (700 MHz) covered |
| Mid band (3G, LTE B3) | 1710 - 2170 MHz | ~2.7 dBi | |
| High band (LTE B7, B41) | 2300 - 4000 MHz | ~5.2 dBi | Band 7 (2600 MHz) covered |

**Band 28 coverage (700 MHz):** Confirmed. The 698 MHz lower limit covers Australian Band 28 (703-748 MHz uplink, 758-803 MHz downlink).

**Band 7 coverage (2600 MHz):** Confirmed. Well within the 698-4000 MHz range. Band 7 uses 2500-2570 MHz uplink, 2620-2690 MHz downlink.

## VSWR

VSWR values are not specified in the publicly available distributor data. The full Molex product specification PDF (2091420180-001.pdf) should contain VSWR plots per band. Typical for this class of antenna: VSWR < 3:1 across operating bands, < 2.5:1 at band centres.

**Action required:** Download and review the full Molex datasheet PDF to confirm VSWR performance, particularly at 700 MHz (Band 28) where flex antennas often have higher VSWR due to the antenna being electrically small relative to wavelength.

## Efficiency

Not specified in available data. Typical for compact flex PCB antennas:
- Low band (700 MHz): 20-40% — flex antennas are electrically small at these frequencies
- Mid band (1800 MHz): 40-60%
- High band (2600 MHz): 50-70%

**Action required:** Confirm efficiency from full datasheet. Low-band efficiency is the key concern for Band 28 performance in remote areas.

## Ground Plane Requirements

Not specified in available distributor data. General guidance for flex PCB antennas:
- Requires a ground plane on the host PCB (the modem daughter card in this design)
- Minimum ground plane: ~50 x 30 mm recommended for low-band performance
- Antenna element should extend beyond the PCB edge (not over the ground plane)
- Keep-out zone: no copper pour under the antenna element
- Cable routing should avoid sharp bends near the connector

**Action required:** The modem daughter card is only 30 x 25 mm. This may be insufficient ground plane for good 700 MHz performance. Review Molex application note and consider whether the main board ground plane (90 x 70 mm) contributes when connected via the 20-pin header. A pigtail to an external SMA bulkhead antenna may perform better in the field.

## Application Notes for This Design

1. **Mounting location:** Inside the IP67 polycarbonate enclosure, adhered to the enclosure wall. Polycarbonate is RF-transparent at these frequencies. Avoid mounting near metal features or battery pack.

2. **Cable routing:** 180mm cable length is adequate to route from modem daughter card to enclosure wall. Avoid running parallel to power traces.

3. **Connector:** U.FL mates with the J_ANT connector on the modem daughter card (LCSC C88374).

4. **Temperature:** Enclosure may reach 70 C in tropical sun (per DESIGN_SPEC). Verify antenna adhesive and materials are rated for this.

## Ordering

| Distributor | Part Number | Stock Status |
|---|---|---|
| DigiKey | 2091420180 | In stock |
| Mouser | 209142-0180 | In stock |
| Farnell / element14 AU | 3225219 | In stock |
| Newark | 84AC5253 | In stock |
| TME | 2091420180 | In stock |

Unit price: ~$3.00 AUD (qty 1), lower at volume.

## Open Items

- [ ] Download and review full Molex datasheet PDF for VSWR plots, efficiency data, and ground plane guidance
- [ ] Verify adhesive temperature rating for tropical deployment (up to 70 C enclosure internal)
- [ ] Assess whether 30x25mm modem card ground plane is adequate for 700 MHz performance
- [ ] Consider SMA bulkhead + external antenna as alternative for remote deployments where Band 28 is primary

## Sources

- [Molex Product Page](https://www.molex.com/en-us/products/part-detail/2091420180)
- [DigiKey Listing](https://www.digikey.com/en/products/detail/molex/2091420180/10057542)
- [Molex Datasheet PDF](https://www.molex.com/content/dam/molex/molex-dot-com/products/automated/en-us/productspecificationpdf/209/209142/2091420180-001.pdf)
- [TME Listing](https://www.tme.com/us/en-us/details/2091420180/gsm-antennas/molex/209142-0180/)
- [Farnell UK Listing](https://uk.farnell.com/molex/209142-0180/698-4000mhz-flexible-antenna-180mm/dp/3225219)
