tobbas75/trackline/trap-monitor/hardware/Camera Trap/datasheets/SFH4725AS_A01.md

---
component: SFH 4725AS A01
manufacturer: ams-OSRAM (formerly OSRAM Opto Semiconductors)
category: LED — Infrared Emitter (940 nm)
status: Active
last_verified: 2026-03-28
confidence: HIGH for headline specs (wavelength, radiant intensity at 1A, flux, beam angle, package size, thermal resistance, max current) from ams-OSRAM product page and datasheet V1.10. LIKELY for Vf at 175mA (extrapolated from curves — not directly specified at this current). VERIFY forward voltage at operating current from datasheet I-V curves before thermal calculations.
---

# SFH 4725AS A01 — OSLON Black 940 nm IR LED

## Datasheet Links

- Product page: https://ams-osram.com/products/leds/ir-leds/osram-oslon-black-sfh-4725as-a01
- Datasheet V1.10 (Oct 2025): https://look.ams-osram.com/m/5c2c1ba34b2984b8/original/SFH-4725AS-A01.pdf
- Datasheet V1.9 (Mar 2024, Mouser): https://www.mouser.com/datasheet/2/588/asset_pdf_5471963-3419497.pdf
- Discontinued predecessor (SFH 4725S): https://look.ams-osram.com/m/576da17be1796a90/original/SFH-4725S.pdf

## Key Specifications

| Parameter | Condition | Value | Notes |
|---|---|---|---|
| Peak wavelength | IF = 1A | 950 nm | Covert — no visible glow to human eye |
| Nominal wavelength | - | 940 nm | Marketing designation |
| Dominant wavelength | - | N/A | IR — dominant wavelength not applicable |
| Viewing angle (full width half intensity) | - | 80 deg | 40 deg half-angle |
| Radiant intensity | IF = 1A | 760 mW/sr (typ) | VERIFY min/max from datasheet |
| Radiant flux (total) | IF = 1A | 1340 mW (typ) | VERIFY min/max from datasheet |
| Forward voltage (Vf) | IF = 1A | 2.65V typ, ~3.1V max | VERIFY max from datasheet |
| Forward voltage (Vf) | IF = 5A, tp=100us | 3.1V typ, 4.2V max | Pulsed conditions |
| Forward voltage (Vf) | IF = 175mA | ~2.3-2.5V typ (estimated) | **ESTIMATED from I-V curve — not directly specified. VERIFY from datasheet curves.** |
| Maximum continuous current (IF) | Tsolder <= 90C | 1500 mA (1.5A) | |
| Maximum pulsed current (IF_pulse) | tp <= 100 us, D <= 0.004 | 5 A | VERIFY exact pulse width and duty cycle limits |
| Thermal resistance (Rth J-S) | Junction to solder point | 5.5 K/W typ, 6.6 K/W max | |
| Package | OSLON Black | 3.75 x 3.75 x 2.29 mm | **Note: 3.75 mm, NOT 3.85 mm** |
| Operating temperature | - | -40C to +125C | Junction temperature limited |
| Max junction temperature | - | 150C | VERIFY from datasheet |
| ESD rating (HBM) | - | 8 kV (Class 3B) | AEC-Q102 qualified |
| Wavelength temp coefficient | - | ~0.3 nm/K | VERIFY — typical for 940 nm AlGaAs |
| Emitter type | - | Double stack | Two emitter chips in series within package |

## Absolute Maximum Ratings

| Parameter | Value | Notes |
|---|---|---|
| Forward current (continuous) | 1500 mA | At Tsolder <= 90C |
| Forward current (pulsed) | 5 A | tp <= 100 us, D <= 0.004 — VERIFY exact limits |
| Reverse voltage | 3 V | VERIFY from datasheet |
| Junction temperature | 150C | VERIFY |
| Solder point temperature | 130C | VERIFY — relevant for reflow profile |
| Storage temperature | -40C to +100C | VERIFY |
| ESD (HBM) | 8 kV | |

**WARNING: Some absolute maximum ratings are estimated from training data. Verify against the V1.10 datasheet before thermal design and driver circuit sizing.**

## Pin Configuration

**Package: OSLON Black, 3.75 x 3.75 x 2.29 mm, bottom view**

The LED has a thermal pad on the bottom with anode and cathode markings. Orientation is indicated by a cathode mark (notch or dot) on one corner.

| Pad | Name | Notes |
|-----|---|---|
| Anode (+) | A | Positive terminal |
| Cathode (-) | K | Negative terminal — marked on package |
| Thermal | EP | Exposed thermal pad — connect to copper pour for heat sinking |

**VERIFY anode/cathode orientation from datasheet mechanical drawing before PCB layout. Getting this wrong destroys the LED on first power-up.**

## SFH4725S Replacement — CRITICAL NOTES

The SFH 4725AS A01 replaces the **discontinued SFH 4725S**. Key differences:

| Parameter | SFH 4725S (discontinued) | SFH 4725AS A01 | Impact |
|---|---|---|---|
| Status | **Discontinued** | Active | Must use A01 |
| Package width | 3.85 mm | **3.75 mm** | **0.1 mm smaller — verify footprint** |
| Package height | 2.29 mm | 2.29 mm | Same |
| Beam angle | 90 deg full | **80 deg full** | Slightly narrower — 10 deg less coverage |
| Radiant intensity at 1A | 425 mW/sr | **760 mW/sr** | **80% brighter per LED** |
| Max continuous IF | 1.0 A | **1.5 A** | Higher headroom |
| Radiant flux at 1A | ~980 mW | **1340 mW** | Significantly more output |

### Footprint Compatibility

The package is **0.1 mm narrower** (3.75 vs 3.85 mm). This is within typical pad tolerance for hand-assembly, but:

- If pads were sized exactly to 3.85 mm, the A01 will be slightly loose — may need pad size adjustment
- If using stencil-based reflow, the 0.1 mm difference should self-centre during reflow
- **Recommendation:** Design new footprint to 3.75 mm spec. Do not assume old SFH4725S footprint is compatible without checking.

### SFH 4718A Warning

**SFH 4718A is 850 nm — WRONG wavelength for covert operation.** 850 nm LEDs produce visible red glow that animals (and humans) can see. The config.h file incorrectly references SFH4718A in LED module ID comments — this needs correction if 940 nm standard modules are intended.

## Operating Point in This Design

**8 LEDs in parallel, driven by AL8861Y-13 buck driver from 5V VLED rail.**

| Parameter | Value | Notes |
|---|---|---|
| LEDs per module | 8 | All in parallel |
| Total drive current | 1.4 A | Set by Rsense = 0.18 ohm |
| Current per LED | 175 mA | 1.4A / 8 LEDs |
| Vf per LED at 175mA | ~2.3-2.5V (estimated) | VERIFY from I-V curve |
| Ballast resistor per LED | 1 ohm | For current sharing between parallel LEDs |
| Strobe pulse width | 30 ms | Per frame, synchronised to IMX678 exposure |
| Pulses per burst | 10 | One per frame |
| Total on-time per burst | 300 ms | 10 x 30 ms |
| Duty cycle (per burst) | 20% | 300 ms on / 1500 ms burst window |
| Duty cycle (daily average) | <0.01% | 70 triggers x 300 ms / 86400 s |

### Thermal Analysis (per LED)

At 175 mA, ~2.4V Vf (estimated):
```
P_electrical = 175 mA x 2.4V = 420 mW per LED
P_optical = (175/1000) * (1340/1000) * 1000 = ~234 mW (scaled linearly — approximate)
P_thermal = 420 - 234 = ~186 mW per LED (dissipated as heat)

Tj_rise = P_thermal x Rth_JS = 0.186W x 6.6 K/W = 1.2C above solder point
```

At 30 ms strobed duty, thermal rise is negligible. Even worst-case stuck-on failure:
```
Tj_rise_continuous = 0.186W x 6.6 = 1.2C (still safe — AL8861 thermal shutdown protects)
```

**Thermal margin is excellent for this application.**

## Power

| State | Current (per LED) | Notes |
|---|---|---|
| Off (LED driver standby) | 0 | LEDs draw no current when driver VSET < 0.2V |
| Strobed (during burst) | 175 mA | 30 ms per frame |
| Fault (stuck on) | 175 mA continuous | AL8861 thermal shutdown protects |

**Energy per burst (all 8 LEDs):**
```
E = 1.4A x 2.4V x 0.3s = 1.008 Wh... no:
E = 1.4A x 0.3s / 3600 = 0.117 mAh (from 5V VLED rail)
P = 1.4A x ~2.7V (Vf + ballast) = ~3.78W during pulse
```

## Application Notes for This Design

1. **Parallel topology.** 8 LEDs in parallel, NOT series. Series string of 8 LEDs would require ~21.6V (8 x 2.7V) — impossible from 5V VLED buck. Each LED gets its own 1 ohm ballast resistor for current sharing.

2. **940 nm is covert.** Peak wavelength 950 nm produces no visible glow to human eyes or most mammal eyes. This is essential for wildlife monitoring (animals are not startled) and anti-poaching (camera location not revealed).

3. **80 deg beam angle.** The 40 deg half-angle should be matched to the camera's field of view (~100 deg HFOV with M12 lens). Two LEDs may need slight angling for edge coverage. The 940nm Long Range module uses narrower-beam variants for distance.

4. **Strobe synchronisation.** TIM1 CH1 on STM32N6 generates STROBE signal gated to MIPI CSI-2 frame-valid. The AL8861 VSET pin responds in ~100 us (fast enough for 30 ms pulse).

5. **LED board is field-swappable.** Connected via JST GH 4-pin. No soldering for module changes. Module auto-detected by ID resistor at boot.

## Procurement

| Source | Part Number | Stock Status | Unit Price (AUD) |
|---|---|---|---|
| DigiKey AU | SFH 4725AS A01 | In stock | ~$1.20 |
| Mouser | SFH 4725AS A01 | In stock | ~$1.20 |
| Arrow | SFH 4725AS A01 | In stock | ~$1.00 |

**Quantity per camera:** 8 LEDs per module. Order 10+ for spares and test modules.

**Lead time:** Generally in stock. ams-OSRAM mainstream production part. Unlike the discontinued SFH4725S, this part has good long-term availability.

## Known Issues

1. **Footprint mismatch with SFH4725S.** 3.75 mm vs 3.85 mm. Design new footprint, do not reuse old SFH4725S pads without verifying.

2. **Vf at 175mA is estimated.** The datasheet specifies Vf at 1A (2.65V typ) and 5A pulsed (3.1V typ). The operating point of 175 mA per LED is well below the characterised range. Vf at 175 mA is likely ~2.3-2.5V but must be verified from the datasheet I-V characteristic curve or by bench measurement of samples.

3. **Parallel LED current sharing.** Without ballast resistors, Vf mismatch between LEDs causes uneven current distribution. The hottest LED runs away thermally. The 1 ohm ballast per LED provides ~175 mV drop at 175 mA, which is adequate for current sharing given typical Vf variation of ~50 mV between binned LEDs.

4. **config.h LED reference inconsistency.** config.h LED_ID_940NM_STANDARD references "SFH4718A 60 deg" — but SFH4718A is an 850 nm part. The actual 940 nm standard module uses SFH 4725AS A01 at 80 deg. This comment needs correction in config.h.

5. **AEC-Q102 qualification.** The A01 variant is automotive-qualified. Good for reliability in harsh outdoor conditions (temperature cycling, humidity), but also means the part may be allocated to automotive customers during shortages.
