tobbas75/trackline/trap-monitor/hardware/Camera Trap/datasheets/SiT8008.md

---
component: SiT8008BI-12-18E-24.000000G
manufacturer: SiTime Corporation
category: Oscillator (MEMS)
status: Active
last_verified: 2026-03-29
confidence: MIXED — SiTime publishes detailed datasheets publicly; specs below are from training knowledge of the SiT8008 datasheet. Verify exact values against current datasheet revision before PCB commit.
---

# SiT8008BI-12-18E-24.000000G — 24 MHz MEMS LVCMOS Oscillator

## Datasheet Links

| Source | URL | Access |
|---|-----|---|
| SiTime product family page | https://www.sitime.com/products/mhz-oscillators/lvcmos-oscillators/sit8008 | Public |
| SiTime datasheet (PDF) | https://www.sitime.com/datasheet/SiT8008 | Public (may redirect to PDF download) |
| SiTime part configurator | https://www.sitime.com/parts/sit8008bi-13-18e-24000000 | Public |

**Note:** The URL above uses "-13-" (field 2 = package code 3 = 2.0x1.6mm). This design uses "-12-" (package code 2 = 2.5x2.0mm SOT-23-5). Verify the correct part page for "-12-" variant.

## Part Number Decode

`SiT8008` `B` `I` `-` `1` `2` `-` `1` `8` `E` `-` `24.000000` `G`

| Field | Value | Meaning |
|---|---|---|
| SiT8008 | — | Product family (low-power MEMS LVCMOS oscillator) |
| B | Revision B | Silicon revision |
| I | Industrial | Temperature range: -40°C to +85°C |
| 1 | — | (Separator / fixed) |
| 2 | Package | 2.5 × 2.0 mm SOT-23-5 |
| 1 | — | (Separator / fixed) |
| 8 | Supply voltage | 1.8V nominal |
| E | OE function | Output Enable pin — active HIGH (HIGH = output enabled) |
| 24.000000 | Frequency | 24.000 MHz |
| G | Frequency stability | ±50 ppm (over full temperature range) |

**BOM note:** The BOM currently lists "±25ppm" and stability code "12" which would decode differently. The part number suffix "G" indicates ±50 ppm per SiTime's coding. Cross-check: if ±25 ppm is required, the stability code should be "F" not "G". **This discrepancy needs resolution before ordering.**

**Correction from BOM:** BOM line says "SiT8008BI-**12**-18E" with "±50ppm" in one place and "±25ppm" in the prompt. The part number decode field "2" in position 5 means 2.5x2.0mm package. The frequency stability is determined by the suffix letter after the frequency. Verify with SiTime configurator.

## Key Specifications

| Parameter | Min | Typical | Max | Unit | Confidence |
|---|-----|---|-----|---|---|
| Output frequency | — | 24.000000 | — | MHz | Verified (part number) |
| Frequency stability (over temp) | — | — | ±50 | ppm | Likely — suffix "G" = ±50 ppm per SiTime coding |
| Supply voltage (VDD) | 1.62 | 1.80 | 1.98 | V | Likely — standard ±10% for 1.8V variant |
| Supply current (active) | — | 3.6 | 4.5 | mA | Likely — typical for 24 MHz at 1.8V |
| Supply current (standby, OE=LOW) | — | 1.2 | 5.0 | µA | Likely — SiTime spec for OE disabled |
| Startup time (to valid output) | — | — | 5 | ms | Likely — from SiTime datasheet |
| Output type | — | LVCMOS | — | — | Verified |
| Operating temperature | -40 | — | +85 | °C | Verified (I = Industrial) |

## Absolute Maximum Ratings

**WARNING: Values below are from training knowledge of SiTime datasheets. Verify against current revision.**

| Parameter | Value | Confidence |
|---|---|---|
| VDD max | 2.2V | Likely |
| Storage temperature | -65°C to +150°C | Likely |
| ESD (HBM) | 1000V | Uncertain |
| Soldering | 260°C, 10s (JEDEC J-STD-020) | Likely |

## Pin Configuration

**SOT-23-5 (2.5 × 2.0 × 0.9 mm)**

```
        ┌───────┐
   OE ──┤1     5├── OUT
        │       │
   GND ──┤2     4├── VDD
        │       │
   NC ──┤3      │
        └───────┘
```

| Pin | Name | Function | Notes |
|-----|---|---|---|
| 1 | OE | Output Enable | Active HIGH (HIGH = output running, LOW = output Hi-Z, oscillator standby). Internal pull-up — leave floating for always-enabled. |
| 2 | GND | Ground | Connect to ground plane |
| 3 | NC | No Connect | Leave unconnected |
| 4 | VDD | Supply | 1.8V ±10%. Bypass with 100 nF ceramic (0402) placed within 2 mm. |
| 5 | OUT | Clock Output | LVCMOS, drives IMX678 INCK directly |

## Output Characteristics

| Parameter | Min | Typical | Max | Unit | Confidence |
|---|-----|---|-----|---|---|
| VOH (at IOH = -4 mA) | VDD - 0.4 | — | VDD | V | Likely |
| VOL (at IOL = 4 mA) | 0 | — | 0.4 | V | Likely |
| Rise time (20%-80%) | — | 2 | 5 | ns | Uncertain |
| Fall time (80%-20%) | — | 2 | 5 | ns | Uncertain |
| Duty cycle | 45 | 50 | 55 | % | Likely |
| Output load | — | — | 15 | pF | Likely |

## Power

### Active Mode
- VDD = 1.8V, 24 MHz output, 15 pF load
- Typical current: 3.6 mA
- Power: 3.6 mA × 1.8V = **6.5 mW typical**

### Standby Mode (OE = LOW)
- Oscillator core stops, output goes Hi-Z
- Typical current: 1.2 µA
- Power: 1.2 µA × 1.8V = **2.2 µW typical**

### Power-Gated (VDD removed)
- In this design, the oscillator is powered from the 1.8V sensor rail (TPS7A02, U12)
- When sensor is not in use, the entire 1.8V rail can be disabled
- Zero current draw when power-gated

## Phase Jitter

| Parameter | Value | Confidence |
|---|---|---|
| RMS phase jitter (12 kHz to 20 MHz) | ~1 ps typical | Uncertain — SiTime MEMS oscillators are generally very low jitter, but exact spec for this variant needs datasheet |
| Period jitter (peak-to-peak) | ~20 ps typical | Uncertain |

**Design note:** Phase jitter is not critical for this application. The IMX678 internal PLL regenerates the clock from INCK, so INCK jitter has minimal impact on image quality. The IMX678 accepts a wide range of input frequencies (6–74.25 MHz) and is tolerant of typical oscillator jitter.

## Application Notes for This Design

### Connection
- OUT (pin 5) → IMX678 INCK pin (direct connection, no series resistor needed)
- VDD (pin 4) → 1.8V sensor rail (TPS7A02 U12 output) with 100 nF bypass cap
- OE (pin 1) → Can be left floating (internal pull-up, always enabled) or connected to a GPIO for explicit enable control. In this design, power-gating the 1.8V rail serves the same purpose.
- GND (pin 2) → Ground plane

### Layout
- Place within 10 mm of the IMX678 INCK pin
- Route OUT trace as controlled impedance is not necessary at 24 MHz — keep trace short and avoid running parallel to high-speed digital signals
- 100 nF bypass cap directly at VDD/GND pins (0402, within 2 mm)
- Ground pad under the package connects to GND (if applicable — SOT-23-5 has no exposed pad)

### Power Sequencing
- The oscillator powers up with the 1.8V rail (same as IMX678 DOVDD)
- Startup time <5 ms — the IMX678 XCLR release delay (500 ms) provides ample margin for oscillator startup
- No separate enable sequencing required

## Procurement

| Source | Part Number | Notes |
|---|---|---|
| DigiKey AU | SiT8008BI-12-18E-24.000000G | Verify stock — SiTime parts are factory-programmed |
| Mouser | SiT8008BI-12-18E-24.000000G | Same |
| SiTime direct | Via distributor | For volume / custom frequency |

**IMPORTANT: SiTime MEMS oscillators are factory-programmable.** The exact frequency, voltage, stability, and OE polarity are programmed at the factory. This means:

1. **Stock availability varies.** Common frequencies (24 MHz, 25 MHz, 48 MHz) at common voltages (1.8V, 3.3V) are usually stocked. Less common combinations may be build-to-order with **2-4 week lead time**.
2. **Verify the exact part number with the distributor.** The "-12-18E-24.000000G" suffix encodes all programmable parameters. An incorrect suffix means wrong voltage, frequency, or stability.
3. **No field reprogramming.** Once programmed, the frequency and parameters are fixed.

**Pricing:** ~$0.75 AUD per unit at low volume (from BOM). Commodity pricing for standard frequencies.

## Known Issues / Errata

1. **Part number decode discrepancy.** The BOM notes "±25ppm" but the part number suffix "G" likely indicates ±50 ppm. If ±25 ppm is genuinely required (it is not — IMX678 PLL is very tolerant), the stability suffix needs to change to "F" (±25 ppm) or similar. For this application, ±50 ppm is more than adequate. **Resolve before ordering.**

2. **1.8V variant stock.** The 1.8V, 24 MHz, SOT-23-5 combination is standard but may not be stocked at all distributors. Check DigiKey/Mouser stock before assuming availability. The 3.3V variant is more commonly stocked but would not be compatible with the 1.8V DOVDD rail.

3. **OE pin behaviour.** The "E" suffix means OE is active HIGH. If the design needs active LOW enable, the suffix would be "D" instead. Current design uses power-gating rather than OE control, so this is not critical.

4. **No exposed thermal pad.** SOT-23-5 has no thermal pad. Thermal dissipation is through the pins only. At 6.5 mW, this is not a concern.
