tobbas75/trackline/trap-monitor/hardware/Camera Trap/datasheets/STM32N657X0H3Q.md

---
component: STM32N657X0H3Q
manufacturer: STMicroelectronics
category: Processing / Main MCU
status: Active (full production, December 2025 datasheet)
last_verified: 2026-03-29
confidence: HIGH — VDDCORE ranges, standby currents, and VBAT currents confirmed from DS14643 Tables 24/44/45 via Chrome browser session 2026-03-29. Peripheral counts verified from web sources.
---

# STM32N657X0H3Q — Cortex-M55 MCU with Neural-ART NPU, 4.2MB SRAM

High-performance microcontroller with hardware AI accelerator, ISP, JPEG/H.264 codec, and MIPI CSI-2 camera interface. Used as the main MCU in the Between 23 AI Camera Trap.

---

## Datasheet Links

| Document | URL | Access |
|---|-----|---|
| **Product page** | https://www.st.com/en/microcontrollers-microprocessors/stm32n657x0.html | Public |
| **Datasheet (STM32N6x5xx/N6x7xx)** | https://www.st.com/resource/en/datasheet/stm32n657x0.pdf | Public PDF (may require ST login for download) |
| **Reference Manual RM0486** | https://www.st.com/resource/en/reference_manual/rm0486-stm32n647657xx-armbased-32bit-mcus-stmicroelectronics.pdf | Public PDF |
| **AN6000 — Discrete power supply** | https://www.st.com/resource/en/application_note/an6000-how-to-build-the-discrete-power-supply-for-stm32n6-mcus-stmicroelectronics.pdf | Public PDF |
| **AN5967 — HW dev getting started** | https://www.st.com/resource/en/application_note/an5967-getting-started-with-hardware-development-for-stm32n6-mcus-stmicroelectronics.pdf | Public PDF |
| **AN5946 — Low-power mode optimization** | https://www.st.com/resource/en/application_note/an5946-how-to-optimize-lowpower-modes-on-stm32n6-mcus-stmicroelectronics.pdf | Public PDF |
| **Errata ES0620** | https://www.st.com/resource/en/errata_sheet/es0620-stm32n6xxxx-device-errata-stmicroelectronics.pdf | Public PDF |
| **DK board schematic (MB1939)** | https://www.st.com/resource/en/schematic_pack/mb1939-n6570-c02-schematic.pdf | Public PDF |
| **DK board user manual UM3300** | https://www.st.com/resource/en/user_manual/um3300-discovery-kit-with-stm32n657x0-mcu-stmicroelectronics.pdf | Public PDF |
| **AN5050 — XSPI interface guide** | https://www.st.com/resource/en/application_note/an5050-getting-started-with-octospi-hexadecaspi-and-xspi-interface-on-stm32-mcus-stmicroelectronics.pdf | Public PDF |

---

## Part Number Decode

```
STM32 N 657 X0 H 3 Q
│     │ │   │  │ │ │
│     │ │   │  │ │ └── Packing: Tray
│     │ │   │  │ └──── Temperature: Industrial (-40 to +85C)
│     │ │   │  └────── Package: VFBGA-264
│     │ │   └────────── Feature variant: X0 (NPU + CSI-2 + JPEG/H.264 + GPU)
│     │ └────────────── Sub-family: 657 (high-performance with NPU)
│     └──────────────── Series: N (Neural processing)
└────────────────────── STM32 family
```

**Other variants in family:**
- STM32N657**A0** = LFBGA-289 (15x15mm, 0.8mm pitch, 195 I/O)
- STM32N657**B0** = TFBGA-361 (16x16mm, 0.65mm pitch, 217 I/O)
- STM32N655xx = Same silicon, no NPU (cost-down variant)
- STM32N647xx = Reduced peripheral set

---

## Key Specifications

| Parameter | Value | Confidence |
|---|---|---|
| CPU Core | Arm Cortex-M55 (ARMv8.1-M, Helium MVE) | VERIFIED (multiple sources) |
| Max CPU clock | 800 MHz | VERIFIED |
| NPU | ST Neural-ART accelerator | VERIFIED |
| NPU performance | 600 GOPS (INT8) | VERIFIED (product page, DigiKey) |
| NPU clock | LIKELY 1 GHz — **NEEDS VERIFICATION from datasheet** | LIKELY |
| SRAM total | 4.2 MB contiguous | VERIFIED |
| Backup SRAM | 8 KB (active in VBAT mode) | VERIFIED |
| FLEXRAM (default) | 400 KB (configurable TCM split) | VERIFIED (Zephyr DTS, CubeN6 example) |
| Internal flash | **None** — external flash only (XSPI boot) | VERIFIED |
| ISP | Hardware Image Signal Processor | VERIFIED |
| Video codec | Hardware JPEG + H.264 encoder | VERIFIED |
| GPU | NeoChrom 2.5D GPU | VERIFIED |
| Camera I/F | MIPI CSI-2, 2-lane D-PHY (DCMIPP) | VERIFIED |
| Package | VFBGA-264 (14x14mm, 0.8mm pitch) | VERIFIED |
| I/O pins | 165 GPIOs (VFBGA-264 package) | VERIFIED (HARDWARE_DESIGN_BRIEF) |
| Operating temp | -40 to +85C (H suffix = industrial) | VERIFIED |
| Extended temp variant | -40 to +125C available (A0 package) | LIKELY (Zephyr docs mention 125C) |

---

## SRAM Breakdown

**IMPORTANT: Exact per-bank sizes need verification from RM0486 Section 10 (RAMCFG). The values below are derived from Zephyr devicetree addresses and ST community posts. Treat individual bank sizes as LIKELY, not VERIFIED.**

| Bank | Address (secure) | Size | Bus Speed | Notes |
|---|---|---|---|---|
| FLEXRAM | 0x34000000 | 400 KB default (configurable) | 400 MHz | Splits between ITCM/DTCM/FLEXRAM via SYSCFG |
| AXISRAM1 | 0x34064000 | ~1137 KB (LIKELY) | 400 MHz | CPU RAM, always accessible |
| AXISRAM2 | 0x34180400 | ~512 KB (VERIFIED from community) | 400 MHz | Boot ROM loads FSBL here |
| AXISRAM3 | 0x34200000 | 448 KB | 800 MHz | NPU RAM, disabled by default, needs RAMCFG clock enable |
| AXISRAM4 | 0x34270000 | 448 KB | 800 MHz | NPU RAM, disabled by default |
| AXISRAM5 | 0x342E0000 | 448 KB | 800 MHz | NPU RAM, disabled by default |
| AXISRAM6 | 0x34350000 | 448 KB | 800 MHz | NPU RAM, disabled by default |
| CACHEAXI | — | ~192 KB (LIKELY) | — | NPU cache, usable as SRAM when NPU cache inactive |
| VENCRAM | — | ~256 KB (LIKELY) | — | H.264 encoder RAM, usable when VENC disabled (SYSCFG_VENCRAM) |
| BKPSRAM | — | 8 KB | — | Backup domain, retained in VBAT mode |
| AHBSRAM1 | — | Size TBD | — | Referenced in datasheet, size unconfirmed |
| AHBSRAM2 | — | Size TBD | — | Referenced in datasheet, size unconfirmed |

**Totals (approximate):**
- AXISRAMx combined: ~3.75 MB (VERIFIED from ST community)
- With CACHEAXI + VENCRAM: ~4.2 MB (VERIFIED total from datasheet)
- FLEXRAM default TCM split: ITCM 64KB + DTCM 128KB + FLEXRAM 400KB (VERIFIED from CubeN6)
- FLEXRAM reconfigurable: ITCM 128KB + DTCM 256KB + FLEXRAM 160KB

**Design note:** AXISRAM3-6 (NPU RAM at 800MHz) must be clocked in FSBL before data can be copied. In our design, AI models load from NOR flash into AXISRAM3-6 at inference time.

---

## Voltage Domains

| Domain | Range | Typical | Function | Confidence |
|---|---|---|---|---|
| **VDD** | 1.71 - 3.6V | 3.3V | Main I/O supply, GPIO banks, analog | VERIFIED |
| **VDDCORE** | 0.81V (nominal) / 0.89V (overdrive) | — | CPU + NPU core supply | VERIFIED (AN6000, community) |
| **VDDIO1** | — | Same as VDD | General I/O (default domain) | LIKELY |
| **VDDIO2** | 1.8V or 3.3V | 1.8V | GPIOO + GPIOP = XSPI Port 1 (HexaSPI) | VERIFIED |
| **VDDIO3** | 1.8V or 3.3V | 1.8V | GPION = XSPI Port 2 (OctoSPI) | VERIFIED |
| **VDDIO4** | 1.8V or 3.3V | 3.3V | GPIOC + GPIOH = SDMMC1 | VERIFIED |
| **VDDIO5** | 1.8V or 3.3V | 3.3V | GPIOC + GPIOE = SDMMC2 | VERIFIED |
| **VDDA** | 1.62 - 3.6V (LIKELY) | 3.3V | ADC/DAC analog supply | LIKELY |
| **VBAT** | 1.55 - 3.6V (LIKELY) | 3.3V | Backup domain (RTC, BKPSRAM, tamper) | LIKELY — verify min from datasheet |

### VDDCORE Details

- **VOS nominal (0.81V):** CPU runs up to 600 MHz. Lower power.
- **VOS overdrive (0.89V):** CPU runs at full 800 MHz, NPU at full speed.
- **Switching:** GPIO PF4 controls TPS62088 feedback divider on DK board.
- **Feeding >0.89V to VDDCORE is out of spec.** Our V1.1 error (1.1V to VDDCORE) would have exceeded abs max.

### HSLV OTP Fuses (CRITICAL — Irreversible)

When VDDIO2 or VDDIO3 is operated at 1.8V, the corresponding HSLV (High-Speed Low-Voltage) OTP fuse **must** be programmed in OTP124:

| OTP124 Bit | Domain | Purpose |
|---|---|---|
| HSLV_VDDIO2 | VDDIO2 (XSPI P1) | Enable 1.8V high-speed I/O for HexaSPI |
| HSLV_VDDIO3 | VDDIO3 (XSPI P2) | Enable 1.8V high-speed I/O for OctoSPI |
| HSLV_VDDIO4 | VDDIO4 (SDMMC1) | Enable 1.8V high-speed I/O if needed |
| HSLV_VDDIO5 | VDDIO5 (SDMMC2) | Enable 1.8V high-speed I/O if needed |
| HSLV_VDD | VDD | Enable 1.8V for main VDD domain |

**WARNING:** Setting HSLV_VDDIOx while VDDIOx is at 3.3V **permanently damages the device**. OTP fuses are one-time-programmable and cannot be reversed. The corresponding PWR_SVMCR register bits must match the OTP fuse state.

**For our design:** VDDIO2 (XSPI P1 = PSRAM) and VDDIO3 (XSPI P2 = NOR flash) run at 1.8V. HSLV fuses for both must be programmed during provisioning. VDDIO4/5 (SDMMC) at 3.3V — do NOT fuse.

---

## Absolute Maximum Ratings

**NEEDS VERIFICATION — these are LIKELY values based on typical STM32 family specs. Verify from datasheet Table "Absolute maximum ratings".**

| Parameter | Min | Max | Confidence |
|---|-----|-----|---|
| VDD | -0.3V | 4.0V | LIKELY |
| VDDCORE | -0.3V | 1.0V | LIKELY |
| VDDIOx | -0.3V | 4.0V | LIKELY |
| VBAT | -0.3V | 4.0V | LIKELY |
| I/O pin voltage (VDD domain) | -0.3V | VDD + 0.3V | LIKELY |
| I/O pin voltage (VDDIOx domain) | -0.3V | VDDIOx + 0.3V | LIKELY |
| Junction temperature | — | 150C | LIKELY |
| Storage temperature | -65C | 150C | LIKELY |
| ESD (HBM) | — | 2000V | LIKELY |

---

## Peripheral Summary

**Verified from Zephyr docs, DK board manual, and multiple search results:**

| Peripheral | Count | Confidence |
|---|---|---|
| USART | 5 | VERIFIED |
| UART | 5 | VERIFIED |
| LPUART | 1 | VERIFIED |
| SPI | 6 (4 with I2S) | VERIFIED |
| I2C | 4 | VERIFIED |
| I3C | 2 | VERIFIED |
| USB 2.0 HS OTG | 2 | VERIFIED |
| CAN FD (FDCAN) | 3 (with TTCAN) | VERIFIED |
| SDMMC | 2 | VERIFIED |
| XSPI1 | 1 — HexaSPI x16 (Port 1) | VERIFIED |
| XSPI2 | 1 — OctoSPI x8 (Port 2) | VERIFIED |
| XSPI3 | 1 — additional XSPI | VERIFIED (AN5050 confirms 3 instances on N6) |
| Ethernet | 1 (with TSN) | VERIFIED |
| MIPI CSI-2 (DCMIPP) | 1 (2-lane D-PHY) | VERIFIED |
| LTDC (display) | 1 | VERIFIED |
| ADC | NEEDS VERIFICATION — LIKELY 2x 12-bit | UNCERTAIN |
| DAC | NEEDS VERIFICATION | UNCERTAIN |
| Timers (advanced) | NEEDS VERIFICATION — LIKELY TIM1, TIM8 | UNCERTAIN |
| Timers (general purpose) | NEEDS VERIFICATION — LIKELY 6+ | UNCERTAIN |
| Timers (low-power) | NEEDS VERIFICATION — LIKELY 2 LPTIM | UNCERTAIN |
| DMA | LIKELY GPDMA with linked-list | LIKELY |
| SAI (audio) | LIKELY 2 | LIKELY |
| DCMI | Replaced by DCMIPP (CSI-2) | VERIFIED |

### XSPI Port Details

| Port | Width | Max Clock | Connection in Our Design |
|---|---|---|---|
| XSPI1 (Port 1) | HexaSPI x16 DDR | 250 MHz | APS256XXN-OB9-BG PSRAM (32MB, 1.8V) |
| XSPI2 (Port 2) | OctoSPI x8 | TBD — verify from datasheet | W25Q128JV + W25Q256JV NOR flash |
| XSPI3 | TBD | TBD | Not used in Rev A |

### CSI-2 Interface

| Parameter | Value | Confidence |
|---|---|---|
| PHY | D-PHY | VERIFIED |
| Lanes | 2 data + 1 clock | VERIFIED |
| Max lane rate | NEEDS VERIFICATION — LIKELY 1.5 Gbps/lane | UNCERTAIN |
| Virtual channels | NEEDS VERIFICATION | UNCERTAIN |
| RAW formats | RAW8, RAW10, RAW12, RAW14 (LIKELY) | LIKELY |

---

## Power Consumption

### Active Mode

| Condition | Current | Confidence |
|---|---|---|
| CPU idle (M55 running, NPU idle) | ~50 mA (LIKELY) | LIKELY — used in power budget |
| NPU + M55 full load | ~450 mA (LIKELY) | LIKELY — used in power budget |
| CPU + NPU + ISP + JPEG peak | NEEDS VERIFICATION | UNCERTAIN |

### Low-Power Modes

**IMPORTANT: The exact current figures below are from our power budget estimates and ST community posts. Verify against datasheet electrical characteristics tables.**

| Mode | Conditions | Current | Confidence |
|---|---|---|---|
| Standby (backup RAM ON, RTC/LSE ON, VDD=1.8V) | **48.4 µA typ, 69.0 µA max @ 25°C, 339 µA max @ 85°C** | **CONFIRMED** DS14643 Table 44 Page 157 |

> **CRITICAL DESIGN DECISION:** The power budget assumed "STM32N6 deep sleep ~8µA". The actual standby current is 48µA typ. VBAT mode (VDD off) is 37-76µA depending on backup RAM.
>
> **However** — if the N6's VBAT pin is left unpowered during sleep (U0 handles all timekeeping via its own RTC), the N6 draws **0µA**. The question is: does the N6 need anything from its VBAT domain during sleep? If not, disconnect VBAT from the always-on rail and gate it with the N6 power enable. This recovers the full 37-76µA.
>
> **Options:**
> 1. **VBAT unpowered (0µA):** N6 loses RTC and backup registers on every sleep. U0 provides all timekeeping. N6 cold-boots on every wake. Best for power.
> 2. **VBAT powered, no backup RAM (37µA max):** N6 keeps RTC but loses SRAM. Still cold-boots but retains timestamp.
> 3. **VBAT powered + backup RAM (76µA max):** N6 keeps 8KB backup SRAM. Could store wake context. Expensive.
>
> **Recommendation:** Option 1 — VBAT unpowered. The U0 already has its own RTC for wake scheduling. The N6 doesn't need to keep time during sleep. Gate VBAT with the N6 power enable signal.
| Standby | No SRAM retention | NEEDS VERIFICATION | UNCERTAIN |
| VBAT mode (backup RAM OFF, RTC/LSE ON, VBAT=3.3V) | **40.5 µA max @ 25°C** | **CONFIRMED** DS14643 Table 45 Page 157 |
| VBAT mode (backup RAM ON, RTC/LSE ON, VBAT=3.3V) | **75.8 µA max @ 25°C** | **CONFIRMED** Table 45 |
| VBAT mode (backup RAM OFF, RTC/LSE OFF) | **36.5 µA max @ 25°C** | **CONFIRMED** Table 45 |
| Shutdown | All off | NEEDS VERIFICATION | UNCERTAIN |
| STOP2 | CPU halted, SRAM retained | ~112 uA (from config.h comment) | LIKELY |

### Power-On Sequence

**CRITICAL — must be followed or device may not boot:**

1. **VDDCORE** must be stable before or simultaneously with VDD
2. **VDD** (1.71-3.6V) powers up
3. **VDDIOx** domains power up (can be sequenced per bank)
4. **VBAT** can be connected before VDD (backup domain)

**From AN6000:** The discrete power supply must ensure VDDCORE reaches target voltage within specification before VDD rises above POR threshold. The DK board uses TPS62088 for VDDCORE with enable tied to the 3.3V rail through a delay circuit.

**For our cascaded design:**
1. Battery -> AP63300 U11 -> 3.3V (always on)
2. 3.3V -> TPS62088 U10a -> 0.81V/0.89V VDDCORE (follows 3.3V with ~1ms delay)
3. 3.3V -> TPS7A02 U12 -> 1.8V (DOVDD, PSRAM, VDDIO_XSPI)
4. POR on STM32N6 triggers when VDD crosses threshold

### Secure Boot Requirement

The STM32N6 has **no internal flash**. It boots from external XSPI memory via a ROM bootloader. The boot sequence is:

1. ROM boot code runs from internal ROM
2. Loads FSBL (First Stage Boot Loader) into AXISRAM2
3. FSBL loads application from external flash into AXISRAM1
4. Application runs from SRAM (XIP from external flash also possible but slower)

**Secure boot is mandatory in production.** The ROM bootloader verifies FSBL signature using keys stored in OTP. For development, unsigned boot is available via STM32CubeProgrammer.

---

## Pin Configuration (Relevant to Camera Trap Design)

See `firmware/config.h` for authoritative pin assignments. Key connections:

| Function | STM32N6 Pin | Notes |
|---|---|---|
| HSE crystal | PH0 (OSC_IN), PH1 (OSC_OUT) | 25 MHz, dedicated pins |
| VDDCORE VOS switch | PF4 | Controls TPS62088 feedback divider |
| CSI-2 | Dedicated analog pads | Not GPIO-muxed |
| XSPI1 (PSRAM) | GPIOO, GPIOP bank | VDDIO2 domain (1.8V) |
| XSPI2 (NOR flash) | GPION bank | VDDIO3 domain (1.8V) |
| SDMMC2 (SD card) | PC2/PC3/PC4/PC5/PC0/PE4 | VDDIO5 domain (3.3V) |
| SPI1 (U0 comms) | PA4-PA7 | Inter-MCU SPI |
| SPI2 (C3 comms) | PF2/PD6/PD7/PB12 | ESP32-C3 SPI slave |
| UART4 (modem) | PC10/PC11 | EG800Q-EU via BSS138 level shift |
| USART3 (GPS) | PD8/PD9 | MAX-M10S |
| I2C1 (sensor) | PC1 (SDA), PH9 (SCL) | IMX678, BSS138 level-shifted to 1.8V |
| TIM1 CH1 | PA8 | IR LED strobe output |
| ADC1 CH0 | PA0 | LED module ID resistor |
| ADC1 CH1 | PA1 | Battery voltage via divider |
| Wake from U0 | PG3 | EXTI rising edge |
| SD card detect | PN12 | Active LOW, EXTI |

---

## Application Notes for This Design

### Power Architecture (from AN6000 + our V1.2 review)

Our design uses a cascaded discrete power supply:
- **Stage 1 (from 6S2P battery 6.0-8.4V):** Three AP63300 bucks (3.3V always-on, 3.8V modem, 5.0V LED)
- **Stage 2 (from 3.3V):** Two TPS62088 (VDDCORE 0.81/0.89V, IMX678 DVDD 1.1V) + TPS7A02 (1.8V)

**Key gotchas:**
- TPS62088 max Vin = 5.5V. **Must be fed from 3.3V rail, never directly from battery.**
- VDDCORE at 0.81V for nominal (600MHz), 0.89V for overdrive (800MHz). **NOT 1.1V or 1.2V.**
- PF4 GPIO switches between voltage levels at runtime (before enabling NPU full speed)
- AP63300 Iq = 22uA — dominates sleep budget

### HSLV Configuration

For our 1.8V XSPI connections (PSRAM on XSPI1, NOR flash on XSPI2):
1. Program HSLV_VDDIO2 and HSLV_VDDIO3 in OTP124 during initial provisioning
2. Set matching bits in PWR_SVMCR3 register in FSBL
3. **Never apply 3.3V to VDDIO2/VDDIO3 after fusing** — permanent damage

### Memory Strategy

- Models (~4.0MB total) cannot fit simultaneously in 4.2MB SRAM with application code
- Load MegaDetector v5 (~2.5MB) first, run detection on 3 frames
- If animal detected, swap to AWC species classifier (~1.5MB), run classification
- Sequential loading adds ~50-100ms per swap from NOR flash via XSPI2

---

## Procurement

| Distributor | URL | Price (qty 1) | Stock | Confidence |
|---|-----|---|---|---|
| DigiKey | https://www.digikey.com/en/products/detail/stmicroelectronics/STM32N657X0H3Q/25675974 | ~$20.62 USD | In stock | VERIFIED (search result) |
| Mouser | Search STM32N657X0H3Q | TBD — check directly | TBD | NOT CHECKED |
| LCSC | Not found | — | — | UNCERTAIN availability |
| element14 | https://in.element14.com/stmicroelectronics/stm32n657x0h3q/mcu-32bit-800mhz-vfbga-264/dp/4587322 | TBD | Listed | VERIFIED listing exists |
| RS Components | https://twen.rs-online.com/web/p/microcontrollers/0266776 | TBD | Listed | VERIFIED listing exists |
| ST eStore | https://estore.st.com/ | TBD | TBD | NOT CHECKED |

**Lead time note:** This is a relatively new part (full production Dec 2025). Monitor availability. The DK board (STM32N6570-DK) is readily available for development.

---

## Known Issues / Errata (ES0620)

The errata sheet ES0620 covers STM32N6xxxx devices. **The specific errata items were not extractable from web search — the PDF must be reviewed manually.**

Download: https://www.st.com/resource/en/errata_sheet/es0620-stm32n6xxxx-device-errata-stmicroelectronics.pdf

**Action required:** Download and review ES0620 before PCB fabrication. Flag any errata affecting:
- XSPI interface (PSRAM/NOR flash)
- CSI-2 / DCMIPP (camera)
- Low-power modes (standby, VBAT)
- SPI/UART peripherals (inter-MCU, modem, GPS)
- ADC (battery sensing, LED module ID)
- TIM1 (LED strobe)

---

## TODO — Manual Verification Needed

The following items could not be extracted from web searches and require manual review of the datasheet PDF and reference manual:

- [ ] **SRAM per-bank sizes:** Verify exact sizes of AXISRAM1, AXISRAM2, AHBSRAM1/2, CACHEAXI, VENCRAM from RM0486 Section 10
- [ ] **Standby current:** Read electrical characteristics table — standby with 80KB retention, standby with no retention, VBAT mode
- [ ] **Absolute maximum ratings:** Verify all Vmax values from datasheet table
- [ ] **ADC specs:** Number of channels, resolution, sampling rate
- [ ] **DAC specs:** Channels, resolution
- [ ] **Timer count:** Exact number and types of timers
- [ ] **CSI-2 max lane rate:** Verify D-PHY speed
- [ ] **XSPI2/XSPI3 max clock:** Verify from datasheet
- [ ] **Errata ES0620:** Review all errata items for design impact
- [ ] **NPU clock frequency:** Confirm 1 GHz (or actual value) from datasheet
- [ ] **Power-on sequence timing:** Verify exact requirements from AN6000/AN5967
- [ ] **VBAT minimum voltage:** Verify from datasheet (1.55V or different?)
