tobbas75/trackline/trap-monitor/hardware/Camera Trap/datasheets/TLP291.md

---
component: TLP291(GR-TP,SE)
manufacturer: Toshiba Semiconductor
category: Protection — Optocoupler (Trigger Output Isolation)
status: Active
last_verified: 2026-03-29
sources: |
  - Mouser datasheet: https://www.mouser.com/datasheet/2/408/TLP291_SE_datasheet_en_20190708-1760517.pdf
  - Toshiba product page: https://toshiba.semicon-storage.com/us/semiconductor/product/optoelectronics/detail.TLP291.html
  - DigiKey listing
  - Project BOM.csv, DESIGN_SPEC.md
confidence: |
  Values marked [PROJECT-VERIFIED] are confirmed in project design docs.
  Values marked [TRAINING-DATA] are from pre-training knowledge — verify against current datasheet before use.
  NOTE: Web fetch was denied/timed out for Toshiba and Mouser URLs this session. All values below are from
  training data. The TLP291 is a well-established, widely-used part and specs are stable, but verify critical
  values (especially CTR range for GR rank) against the manufacturer datasheet before finalizing the design.
---

# TLP291(GR-TP,SE) — Single-Channel Optocoupler

## Datasheet Links

| Document | URL |
|---|-----|
| Datasheet (Mouser) | https://www.mouser.com/datasheet/2/408/TLP291_SE_datasheet_en_20190708-1760517.pdf |
| Toshiba product page | https://toshiba.semicon-storage.com/us/semiconductor/product/optoelectronics/detail.TLP291.html |

## Key Specifications

| Parameter | Value | Confidence |
|---|---|---|
| Channels | 1 (single) | [TRAINING-DATA] |
| Isolation voltage | **3750 Vrms** (1 minute) | [TRAINING-DATA] verify |
| CTR (GR rank) | **200-600%** | [TRAINING-DATA] verify — critical for bias design |
| Forward current max (IF) | 50 mA | [TRAINING-DATA] verify |
| Forward voltage (VF) | 1.2 V typ, 1.4 V max (at IF=5mA) | [TRAINING-DATA] verify |
| Collector-emitter voltage (VCEO) | 80 V | [TRAINING-DATA] verify |
| Collector current max (IC) | 50 mA | [TRAINING-DATA] verify |
| Rise time (tr) | 3 us (typ) | [TRAINING-DATA] verify |
| Fall time (tf) | 4 us (typ) | [TRAINING-DATA] verify |
| Operating temperature | -55 to +110 degC | [TRAINING-DATA] verify |
| Product status | **Active** | [TRAINING-DATA] |

### CTR Rank Designations

The TLP291 is available in multiple CTR (Current Transfer Ratio) ranks:

| Rank | CTR Range | Confidence |
|---|---|---|
| BL | 50-100% | [TRAINING-DATA] verify |
| YR | 100-200% | [TRAINING-DATA] verify |
| **GR** | **200-600%** | [TRAINING-DATA] verify |
| TP | 100-600% (wide range) | [TRAINING-DATA] verify |

**This design uses GR rank** (200-600% CTR). The high CTR allows low LED drive current while still saturating the phototransistor output, which is important for minimizing GPIO current draw from the STM32N6.

### Suffix Decode

`TLP291(GR-TP,SE)`:
- **GR** = CTR rank (200-600%)
- **TP** = Tape and reel packaging
- **SE** = Lead-free / RoHS compliant

## Absolute Maximum Ratings

| Parameter | Value | Unit | Confidence |
|---|---|---|---|
| Forward current (IF) | 50 | mA | [TRAINING-DATA] verify |
| Reverse voltage (VR) | 5 | V | [TRAINING-DATA] verify |
| Collector-emitter voltage (VCEO) | 80 | V | [TRAINING-DATA] verify |
| Emitter-collector voltage (VECO) | 6 | V | [TRAINING-DATA] verify |
| Collector current (IC) | 50 | mA | [TRAINING-DATA] verify |
| Collector power (PC) | 150 | mW | [TRAINING-DATA] verify |
| Total power dissipation | 200 | mW | [TRAINING-DATA] verify |
| Isolation voltage | 3750 | Vrms | [TRAINING-DATA] verify |
| Operating temperature | -55 to +110 | degC | [TRAINING-DATA] verify |
| Storage temperature | -55 to +125 | degC | [TRAINING-DATA] verify |

## Pin Configuration

### SOP-4 (Mini-flat) Package — 4 pins

| Pin | Name | Function | Confidence |
|-----|---|---|---|
| 1 | Anode | LED anode (+) | [TRAINING-DATA] |
| 2 | Cathode | LED cathode (-) | [TRAINING-DATA] |
| 3 | Emitter | Phototransistor emitter | [TRAINING-DATA] |
| 4 | Collector | Phototransistor collector | [TRAINING-DATA] |

```
         ┌─────────┐
  Anode  1│  LED →  │4  Collector
         │         │
Cathode  2│  ← PT  │3  Emitter
         └─────────┘
```

### Package

| Parameter | Value | Confidence |
|---|---|---|
| Package | SOP-4 (mini-flat) / also available in DIP-4 | [TRAINING-DATA] |
| Dimensions (SOP-4) | 4.4 x 2.0 x 2.1 mm (typ) | [TRAINING-DATA] verify |
| Pin pitch | 2.54 mm | [TRAINING-DATA] verify |
| Creepage distance | >= 5 mm | [TRAINING-DATA] verify |
| Clearance distance | >= 5 mm | [TRAINING-DATA] verify |

## Power

### LED (Input) Side

| Parameter | Value | Confidence |
|---|---|---|
| Forward voltage (VF) | 1.2 V typ (at IF=5mA) | [TRAINING-DATA] verify |
| Forward current for rated CTR | 5 mA (datasheet test condition) | [TRAINING-DATA] verify |
| Peak forward current | 1 A (100 us pulse, 1% duty) | [TRAINING-DATA] verify |

### Phototransistor (Output) Side

| Parameter | Value | Confidence |
|---|---|---|
| Collector-emitter saturation (VCE_sat) | 0.2 V typ (at IF=5mA, IC=1mA) | [TRAINING-DATA] verify |
| Dark current (ICEO) | 100 nA max (VCE=20V) | [TRAINING-DATA] verify |
| Bandwidth (-3dB) | ~80 kHz | [TRAINING-DATA] verify |

## Application Notes for This Design

### Trigger Output Isolation

The TLP291 (U_TRIG) provides galvanic isolation between the camera trap MCU and the external trigger output. This isolates the field cable (which may connect to traps, bait stations, or deterrent devices) from the camera's internal electronics.

**Circuit (from DESIGN_SPEC.md / BOM.csv):**

```
STM32N6                    TLP291                 Backpack Connector
                                                  J_BP pins 3-4
PG6 ──[R_LED]──► Anode (1)    Collector (4) ──── Pin 3 (TRIG+)
                  │                │
                 GND ◄── Cathode (2)   Emitter (3) ──── Pin 4 (TRIG-)
```

- **PG6** drives the LED side via a current-limiting resistor
- **Collector/Emitter** connect to the backpack connector pins 3 and 4
- The external device provides its own pull-up or supply on the trigger lines
- **>3.75 kV isolation** protects the camera from field cable faults, lightning transients, and ground loops

### LED Drive Current Calculation

With GR rank (CTR 200-600% min) at IF = 5 mA:
- IC (output) = IF x CTR = 5 mA x 2.0 = 10 mA minimum
- More than sufficient to drive most trigger inputs

For the LED resistor (R_LED), assuming PG6 = 3.3V output, VF = 1.2V, IF = 5 mA:
- R_LED = (3.3V - 1.2V) / 5 mA = 420 ohm (nearest E24: 390 ohm or 470 ohm)

**Verify the actual R_LED value in the schematic.** The BOM does not specify the exact value for the optocoupler LED resistor.

### Trigger Input Sense

A separate path (R_TRIG_SENSE = 100k ohm + D_TRIG_TVS 3.3V bidirectional TVS) connects J_BP pin 3 to STM32U0 PA3 (TRIG_SENSE). This allows the camera to sense whether an external trigger device is connected and its state, independently of the optocoupler output drive.

### Response Time

Rise/fall times of 3/4 us are more than adequate for trigger output applications. The trigger pulse duration is typically 100 ms or longer.

## Procurement

| Source | Part Number | Notes |
|---|---|---|
| LCSC | C115330 | BOM primary source |
| DigiKey | TLP291(GR-TP,SE) | Alternative |
| Mouser | TLP291(GR-TP,SE) | Alternative |

BOM unit cost estimate: ~$0.20 AUD (per BOM.csv).

This is a very common, widely stocked optocoupler. No supply risk.

## Known Issues / Errata

1. **CTR degrades with temperature and age.** At high temperature (+85 degC) and after extended use, CTR can drop to 50% of room-temperature value. The GR rank (200-600%) provides adequate margin, but if operating near the temperature limit, verify minimum CTR at worst-case temperature.

2. **CTR varies with IF.** The rated CTR (200-600%) is specified at IF = 5 mA. At lower drive currents (e.g., 1 mA), CTR may be significantly lower. Design the LED drive resistor for at least 5 mA.

3. **LED resistor value.** The exact R_LED value is not specified in the BOM — it is listed under "R_various" passives. The schematic must define this resistor based on the GPIO output voltage and desired IF.

4. **Phototransistor saturation.** For switching applications, ensure VCE_sat < logic LOW threshold of the receiving device. At IF=5mA and CTR=200%, IC=10mA with VCE_sat ~0.2V — this is well below any standard logic threshold.

5. **Isolation rating.** The 3750 Vrms isolation is for 1 minute per UL/IEC. For continuous isolation at lower voltages (typical field cable voltages are < 48V), this is more than adequate. The primary risk is lightning-induced transients on long field cable runs, which the optocoupler + TVS diode combination addresses.
