tobbas75/trackline/trap-monitor/hardware/Camera Trap/docs/SYSTEM_ARCHITECTURE.md

# System Architecture — AI Camera Trap

**Date:** March 2026
**Revision:** 1.0 DRAFT

---

## 1. Overview

The Between 23° AI Camera Trap is a battery-powered edge-AI wildlife monitoring and trigger platform for remote tropical Australia. It performs on-device species classification using deep learning, eliminating manual review of thousands of empty images, and can fire external actions (traps, deterrents, bait) on confirmed AI detection. The system integrates with the WildTrack ecological monitoring platform and Addax Data Science AI models (open model architecture — any Addax model via SD card).
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
