tobbas75/trackline/trap-monitor/hardware/Trap Monitor/PCB FILES/image.png

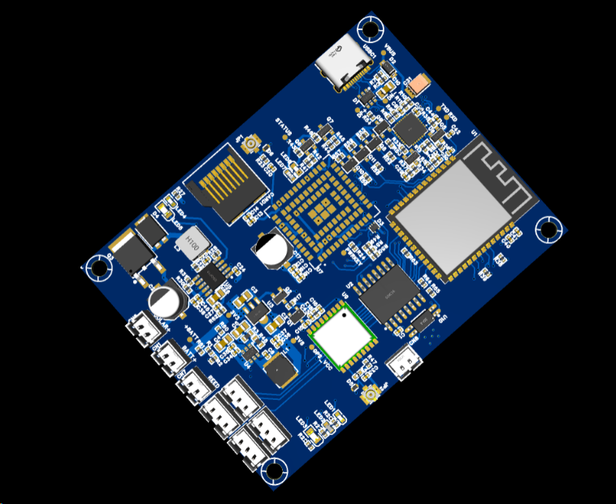
trap-monitor/hardware/Trap Monitor/PCB FILES/image.png
