tobbas75/trackline/trap-monitor/hardware/Trap Monitor/PCB FILES/BOM_Board1_PCB1_2026-03-30 1.xlsx

No. | Quantity | Comment | Designator | Footprint | Value | Manufacturer Part | Manufacturer | Supplier Part | Supplier
1 | 9 | Test-Point | 3V3,3V8,+BATT,DN-,DP+,GPS_VCC,PWRKEY,STATUS,VBUS | Test-Point-0.5mm
2 | 1 | CR2032-B1 | BT1 | BAT-SMD_CR2032-B1 |  | CR2032-B1 | HanElectricity(瀚源) | F | LCSC
3 | 17 | 100nF | C1,C6,C9,C12,C13,C15,C16,C24,C29,C34,C39,C40,C41,C42,C43,C44,C45 | C0402 | 100nF | CL05B104KO5NNNC | SAMSUNG(三星) | C1525 | LCSC
4 | 4 | 10uF | C2,C3,C4,C10 | C0805 | 10uF | CL21A106KAYNNNE | SAMSUNG(三星) | C15850 | LCSC
5 | 2 | 47uF | C5,C26 | C0805 | 47uF | GRM21BR61A476ME15L | muRata(村田) | C124129 | LCSC
6 | 1 | 22pF | C14 | C0402 | 22pF | 0402CG220J500NT | FH(风华) | C1555 | LCSC
7 | 1 | 100uF | C17 | CAP-SMD_BD6.3-L6.6-W6.6-LS7.2-FD | 100uF | RVT100UF16V67RV0016 | KNSCHA(科尼盛) | C2887276 | LCSC
8 | 1 | 10pF | C18 | C0402 | 10pF | CL05C100JB5NNNC | SAMSUNG(三星) | C32949 | LCSC
9 | 1 | 33pF | C19 | C0402 | 33pF | CL05C330JB5NNNC | SAMSUNG(三星) | C70465 | LCSC
10 | 1 | 100pF | C20 | C0402 | 100pF | CC0402JRNPO9BN101 | YAGEO(国巨) | C106200 | LCSC
11 | 1 | 47uF | C23 | CAP-SMD_BD6.3-L6.6-W6.6-FD | 47uF | RVT1V470M0605 | ROQANG(容强) | C72522 | LCSC
12 | 1 | 220nF | C25 | C0402 | 220nF | CL05B224KO5NNNC | SAMSUNG(三星) | C16772 | LCSC
13 | 2 | 1uF | C27,C35 | C0402 | 1uF | CL05A105KP5NNNC | SAMSUNG(三星) | C14445 | LCSC
14 | 2 | 100nF | C30,C32 | C0402 | 100nF | GRM155R71H104KE14D | muRata(村田) | C77020 | LCSC
15 | 1 | 10uF | C31 | CASE-B_3528 | 10uF | CA45-B-25V-10uF-K | CEC(振华新云) | C128259 | LCSC
16 | 1 | 10nF | C33 | C0402 | 10nF | CL05B103KB5NNNC | SAMSUNG(三星) | C15195 | LCSC
17 | 2 | 22uF | C36,C37 | C0402 | 22uF | GRM158R61A226ME15D | muRata(村田) | C3845593 | LCSC
18 | 1 | 1uF | C38 | C0402 | 1uF | CL05A105KO5NNNC | SAMSUNG(三星) | C29266 | LCSC
19 | 1 | TF-104 | CARD1 | TF-SMD_TF-104 |  | TF-104 | XUNPU(讯普) | C266612 | LCSC
20 | 2 | B2B-PH-K-S(LF)(SN) | CN1,CN6 | CONN-TH_B2B-PH-K-S |  | B2B-PH-K-S(LF)(SN) | JST | C131337 | LCSC
21 | 1 | USBLC6-2SC6 | D1 | SOT-23-6_L2.9-W1.6-P0.95-LS2.8-BL |  | USBLC6-2SC6 | ST(意法半导体) | C7519 | LCSC
22 | 1 | 1N5819HW-7-F | D2 | SOD-123_L2.7-W1.6-LS3.7-RD |  | 1N5819HW-7-F | DIODES(美台) | C82544 | LCSC
23 | 1 | TPD3E001DRLR | D3 | SOT-553-5_L1.6-W1.2-P0.50-LS1.6-TL |  | TPD3E001DRLR | TI(德州仪器) | C470828 | LCSC
24 | 1 | SB1045L | D4 | TO-277_3P-L5.4-W4.0-LS6.5-TR |  | SB1045L | GOODWORK(固得沃克) | C908747 | LCSC
25 | 2 | ESD701DPYR | D5,D6 | X1SON-2_L1.0-W0.6-P0.65-BI |  | ESD701DPYR | TI(德州仪器) | C42409125 | LCSC
26 | 2 | 6GHz | JP1,JP2 | RF-SMD_FRF05002-JSS103M | 6GHz | U.FL-R-SMT-1(80) | HRS(广濑) | C88374 | LCSC
27 | 1 | 4.7uH | L1 | IND-SMD_L5.0-W5.0 | 4.7uH | CKCS5040-4.7uH/M | CENKER(岑科) | C354606 | LCSC
28 | 1 | 10uH | L3 | IND-SMD_L5.2-W5.2_MCW-0530 | 10uH | SMMS0530-100M | SXN(顺翔诺) | C181721 | LCSC
29 | 1 | 27nH | L4 | L0402-RD | 27nH | LQG15HS27NJ02D | muRata(村田) | C12669 | LCSC
30 | 2 | 19-217/GHC-YR1S2/3T | LED1,LED4 | LED0603-RD |  | 19-217/GHC-YR1S2/3T | EVERLIGHT(亿光) | C72043 | LCSC
31 | 1 | 19-217/BHC-ZL1M2RY/3T | LED2 | LED0603-FD_BLUE |  | 19-217/BHC-ZL1M2RY/3T | EVERLIGHT(亿光) | C72041 | LCSC
32 | 1 | 17-21SURC/S530-A3/TR8 | LED3 | LED0805-R-RD |  | 17-21SURC/S530-A3/TR8 | EVERLIGHT(亿光) | C72037 | LCSC
33 | 1 | 17-21SURC/S530-A3/TR8 | LED5 | LED0805-R-RD |  | 17-21SURC/S530-A3/TR8 | EVERLIGHT(亿光) | f | LCSC
34 | 1 | SML-D12P8WT86C | LED6 | LED0603-FD_GREEN |  | SML-D12P8WT86C | ROHM(罗姆) | C2909774 | LCSC
35 | 1 | YLED0603Y | LED7 | LED0603-RD-1 |  | YLED0603Y | YONGYUTAI(永裕泰) | C19273152 | LCSC
36 | 4 | Screw-Hole-M3 | M1,M2,M3,M4 | Screw-Hole-M3
37 | 1 | SI2301CDS-T1-GE3 | Q1 | SOT-23-3_L3.0-W1.7-P0.95-LS2.9-BR |  | SI2301CDS-T1-GE3 | VISHAY(威世) | C10487 | LCSC
38 | 1 | BSS138 | Q2 | SOT-23-3_L2.9-W1.3-P1.90-LS2.4-BR_1 |  | BSS138 | baocheng(宝乘) | C51898309 | LCSC
39 | 1 | AOD4185 | Q3 | TO-252-3_L6.6-W6.1-P4.57-LS9.9-BR-CW |  | AOD4185 | AOS | C400894 | LCSC
40 | 2 | L8050QLT1G | Q4,Q5 | SOT-23-3_L2.9-W1.3-P1.90-LS2.4-BR |  | L8050QLT1G | LRC(乐山无线电) | C49581 | LCSC
41 | 2 | S8050 | Q6,Q7 | SOT-23-3_L2.9-W1.3-P1.90-LS2.4-BR |  | S8050 | JSMSEMI(杰盛微) | C916390 | LCSC
42 | 4 | BSS138 | Q8,Q9,Q10,Q11 | SOT-23-3_L2.9-W1.6-P1.90-LS2.8-BR |  | BSS138 | onsemi(安森美) | C52895 | LCSC
43 | 1 | 1MΩ | R1 | R0402 | 1MΩ | 0402WGF1004TCE | UNI-ROYAL(厚声) | C26083 | LCSC
44 | 1 | 470kΩ | R2 | R0402 | 470kΩ | 0402WGF4703TCE | UNI-ROYAL(厚声) | C25790 | LCSC
45 | 1 | 100kΩ | R3 | R0603 | 100kΩ | 0603WAF1003T5E | UNI-ROYAL(厚声) | C25803 | LCSC
46 | 1 | 100kΩ | R5 | R0402 | 100kΩ | 0402WGF1003TCE | UNI-ROYAL(厚声) | C25741 | LCSC
47 | 2 | 5.1kΩ | R6,R7 | R0402 | 5.1kΩ | 0402WGF5101TCE | UNI-ROYAL(厚声) | C25905 | LCSC
48 | 17 | 10kΩ | R8,R17,R24,R31,R33,R35,R37,R40,R52,R53,R54,R55,R56,R57,R58,R59,R63 | R0402 | 10kΩ | 0402WGF1002TCE | UNI-ROYAL(厚声) | C25744 | LCSC
49 | 2 | 1kΩ | R9,R27 | R0402 | 1kΩ | RC0402FR-071KL | YAGEO(国巨) | C106235 | LCSC
50 | 1 | 22.1kΩ | R10 | R0402 | 22.1kΩ | FRC0402F2212TS | FOJAN(富捷) | C2929993 | LCSC
51 | 1 | 47.5kΩ | R11 | R0402 | 47.5kΩ | 0402WGF4752TCE | UNI-ROYAL(厚声) | C25896 | LCSC
52 | 5 | 0Ω | R12,R13,R23,R34,R36 | R0402 | 0Ω | RC0402FR-070RL | YAGEO(国巨) | C106231 | LCSC
53 | 1 | 100Ω | R18 | R0402 | 100Ω | 0402WGF1000TCE | UNI-ROYAL(厚声) | C25076 | LCSC
54 | 3 | 22Ω | R20,R21,R22 | R0402 | 22Ω | 0402WGF220JTCE | UNI-ROYAL(厚声) | C25092 | LCSC
55 | 1 | 120Ω | R28 | R0402 | 120Ω | FRC0402F1200TS | FOJAN(富捷) | C2909315 | LCSC
56 | 1 | 64.9kΩ | R30 | R0402 | 64.9kΩ | ERA2AEB6492X | PANASONIC(松下) | C490835 | LCSC
57 | 1 | 100mΩ | R32 | R0402 | 100mΩ | 0402WGJ010KTCE | UNI-ROYAL(厚声) | C474056 | LCSC
58 | 5 | 4.7kΩ | R38,R39,R41,R44,R64 | R0402 | 4.7kΩ | RC0402FR-074K7L | YAGEO(国巨) | C105871 | LCSC
59 | 2 | 47kΩ | R42,R45 | R0402 | 47kΩ | RC0402FR-0747KL | YAGEO(国巨) | C93943 | LCSC
60 | 2 | 2.2kΩ | R43,R46 | R0402 | 2.2kΩ | RC0402FR-072K2L | YAGEO(国巨) | C114762 | LCSC
61 | 1 | 10Ω | R47 | R0402 | 10Ω | RC0402FR-0710RL | YAGEO(国巨) | C138066 | LCSC
62 | 1 | 27kΩ | R48 | R0603 | 27kΩ | RC0603FR-0727KL | YAGEO(国巨) | C114614 | LCSC
63 | 6 | 0Ω | R49,R50,R51,R60,R61,R62 | R0402 | 0Ω | RC0402JR-070RL | YAGEO(国巨) | C60485 | LCSC
64 | 1 | 330Ω | R65 | R0402 | 330Ω | FRC0402F3300TS | FOJAN(富捷) | C2930002 | LCSC
65 | 2 | Test-Point | RXD,TXD | SMD-1_BD1.5
66 | 1 | 2.4GHz | U1 | WIRELM-SMD_ESP32-S3-WROOM-1 | 2.4GHz | ESP32-S3-WROOM-1-N16R8 | ESPRESSIF(乐鑫) | C2913202 | LCSC
67 | 1 | DS3231SN#T&R | U2 | SOIC-16_L10.3-W7.5-P1.27-LS10.3-BL |  | DS3231SN#T&R | ADI(亚德诺)/MAXIM(美信) | C9866 | LCSC
68 | 1 | HT7333-A | U3 | SOT-89-3_L4.5-W2.5-P1.50-LS4.2-BR |  | HT7333-A | HOLTEK(合泰/盛群) | C21583 | LCSC
69 | 1 | AP63300WU-7 | U4 | TSOT-23-6_L2.9-W1.6-P0.95-LS2.8-BR |  | AP63300WU-7 | DIODES(美台) | C2158012 | LCSC
70 | 1 | CN3767 | U5 | SSOP-10_L4.9-W3.9-P1.00-LS6.0-BL |  | CN3767 | CONSONANCE(上海如韵) | C81968 | LCSC
71 | 1 | CP2102N-A02-GQFN28R | U6 | QFN-28_L5.0-W5.0-P0.50-TL-EP3.3 |  | CP2102N-A02-GQFN28R | SKYWORKS/SILICON LABS(芯科) | C964632 | LCSC
72 | 1 | EG800Q-EU | U7 | XCVR_EG800Q-EU
73 | 1 | MAX-M10S-00B | U9 | SMD-18_L10.1-W9.7-P1.10-TL_SKG09F |  | MAX-M10S-00B | U-BLOX(优北罗) | C4153167 | LCSC
74 | 1 | TLP291GB | U10 | SO-4_L4.6-W2.6-P1.27-LS7.0 |  | TLP291GB | TOSHIBA(东芝) | C2942904 | LCSC
76 | 1 | Reed Switch (NC) | SW1 | Through-Hole |  | GPS-14A | Standex-Meder |  | Off-board (JST-PH cable to CN header)
77 | 1 | CR2032 Coin Cell | BAT1 | N/A (insert into BT1 holder) | 3V | CR2032 | Panasonic |  | Off-board (for RTC backup, BT1 holder)
