tobbas75/trackline/trap-monitor/hardware/Trap Monitor/PCB FILES/Gerber_PCB1_2026-03-29/How-to-order-PCB.txt

How to Order PCB

Please refer to:
https://prodocs.easyeda.com/en/pcb/order-order-pcb/index.html
