tobbas75/trackline/trap-monitor/hardware/Camera Trap/COMPETITIVE_BENCHMARK.md

# AI Camera Trap — Competitive Benchmark & Market Analysis

**Date:** 14 March 2026
**Product:** Between 23° AI Camera Trap (STM32N6 + IMX678)
**Purpose:** Position against current market offerings and validate addressable market before PCB layout commitment

---

## 1. Market Overview

### Global Camera Trap Market

| Metric | Value |
|---|---|
| Global trail camera market (2025) | ~$906M |
| Projected (2026) | ~$963M |
| CAGR | 6.6% (2025–2033) |
| Wildlife cameras total (2024) | ~$1.5B |
| Projected (2033) | ~$2.5B |

**Key trends (2025–2026):**
- Solar-powered 4G cameras expected to capture 30% of market by 2026
- AI-powered models dominating premium segments, growing 15% faster than non-AI annually
- No-glow 940nm IR becoming standard — the 12–16MP segment holds 36% market share
- Asia-Pacific is fastest-growing region (14.2% CAGR), driven by AU, CN, IN conservation spend
- Static camera traps account for >35% of global revenue; mobile HD cameras growing at 12.3% CAGR

### AI in Wildlife Conservation (sub-market)

| Metric | Value |
|---|---|
| AI in wildlife conservation monitoring (2024) | Emerging |
| Projected (2032) | Part of $60.5B wildlife tracking systems market |
| Edge AI adoption | Accelerating — TinyML and on-device inference now viable on MCU-class hardware |

Only three products in market have any form of AI: Browning (cloud), Sentinel (edge add-on), Behold Cam-1 (edge, backyard). Between 23° would be the first integrated edge-AI trail camera with NPU-class hardware targeting professional conservation.

---

## 2. Head-to-Head Comparison (Updated March 2026)

| Spec | **Between 23°** | Reconyx HyperFire 4K | SpyPoint Flex G-36 | Browning Vision Pro Live | Tactacam Reveal Ultra | Behold Cam-1 | Conservation X Sentinel |
|---|---|---|---|---|---|---|---|
| **Sensor** | Sony IMX678 8MP (true 4K, STARVIS 2) | **8MP (true 4K)** | 36MP (interpolated) | 46MP (interpolated) | 4K photo, 16MP | Sony IMX675 (2K, STARVIS 2) | Depends on host camera |
| **Night Sensor** | 2×2 binned 2MP + STARVIS 2 NIR (~1000nm) | 2MP (binned) | Same sensor | Same sensor | Same sensor | 850nm IR LEDs, 10m range | N/A |
| **AI** | **Edge NPU (600 GOPS)** | None | None | Cloud only (needs cellular) | None | **Edge (iCatch V59AX)** | **Edge (ARM Cortex-A)** |
| **AI Models** | MegaDetector v5 + 135 AU species | — | — | Hunting species filter | — | 2,000+ species (NA/EU) | Custom per deployment |
| **AI Inference** | 3 frames/burst, <350ms each | — | — | Cloud latency (seconds) | — | On-device (speed TBD) | ~1–2s per image |
| **Trigger Speed** | ~200 ms (est.) | **250 ms** | 270 ms–1.8 s | **135 ms** | Not specified | Not specified | Adds to host camera |
| **Video** | No (burst stills, 4K) | **4K @ 30fps + stereo audio** | 1080p with sound | **1080p livestream** | **1080p + livestream** | **2K @ 60fps + audio** | N/A |
| **IR Type** | 940nm no-glow (modular) | 940nm no-glow | 850nm (low-glow) | 940nm no-glow | Switchable 940/850 | 850nm (low-glow) | N/A |
| **IR Range** | TBD (modular, ~15–25m est.) | **45m (150ft)** | 30m (100ft) | **33m (110ft)** | 24m (80ft) | 10m (33ft) | N/A |
| **IR Approach** | **Strobed (30ms/frame)** | Continuous | Continuous | Continuous | Continuous | Continuous | N/A |
| **IR Modules** | **5 swappable** (940/850/white/LR/blank) | Fixed | Fixed | Fixed | Switchable mode | Fixed | N/A |
| **Cellular** | LTE CAT-1bis (EG800Q) | Optional ($600+) | Dual-SIM LTE | AT&T + Verizon LTE | AT&T/Verizon LTE | **None (WiFi only)** | Satellite + LoRa + Cell |
| **Alert Type** | SMS + MQTT, AI-filtered, thumbnail | Photo upload (all) | Photo upload (all) | Photo upload + cloud AI | Photo upload (all) | App notification (WiFi) | AI-filtered alerts |
| **GPS** | Yes (u-blox M10) | No | Yes | Yes | **Yes (active anti-theft)** | No | Yes |
| **WiFi Offload** | Yes (ESP32-C3 AP, bulk) | No | No | No | **Yes (WiFi + BLE)** | **Yes (dual-band WiFi)** | No |
| **BLE Config** | Yes (ESP32-C3 GATT) | No | Yes | Yes | Yes | **Yes (NFC)** | Unknown |
| **Battery** | 12/24 AA NiMH + solar | 12 AA | 8 AA + solar | 8 AA + 12V ext | **12 AA** | **5200mAh USB-C** | Solar/battery |
| **Battery Life** | **647+ days (12 AA, 70 trig/day)** | **40K images / ~2 years** | ~11 months (solar) | Not specified | ~3.6 months | "Weeks" | Varies |
| **Storage** | µSD (128/256 GB) | SD card | µSD (32 GB max) | µSD (512 GB max) | 16 GB internal + SD | **128 GB internal** | SD card (intercepted) |
| **Enclosure** | IP67 custom, tropical rated | IP66 | IP65 | Not rated | **IP66** | Weatherproof (rating TBD) | Adapter (no enclosure) |
| **Operating Temp** | 0–50°C (tropical) | **-20 to +50°C** | -20 to +50°C | -20 to +60°C | Not specified | Not specified | Not specified |
| **Warranty** | TBD | **5 years** | 2 years | 1 year | 1 year | TBD (Kickstarter) | N/A |
| **Price** | ~$120–150 BOM | **$400** | $100 | ~$220 | ~$200 | $350 ($227 early bird) | Waitlist (contact) |
| **Data Plan** | None (SMS) or MQTT | N/A or paid | Free 100/mo, then $5+ | Paid subscription | From $5/mo | **None (WiFi)** | Satellite fees |
| **Target Market** | Conservation / rangers / research | Research / hunting | Hunting (budget) | Hunting (premium) | Hunting (premium) | **Backyard / consumer** | Conservation (add-on) |

### New Competitors Since Last Benchmark

**Reconyx HyperFire 4K (launched 2025)** — Major upgrade. True 4K video at 30fps with stereo audio, 8MP native sensor, 150ft no-glow IR range, 5-year warranty. Now the research gold standard at $400. No AI, no cellular (unless $600+ option). Still requires manual image review.

**Tactacam Reveal Ultra (launched late 2025)** — Livestreaming, active GPS anti-theft (tracks even when powered off), switchable 940/850nm flash, WiFi + BLE. No AI. $200. Hunting-focused. Reviewer quote: "Tactacam needs to jump on that AI train."

**Behold Cam-1 (Kickstarter, shipping June 2026)** — First consumer-friendly AI wildlife camera. Sony IMX675 (STARVIS 2), iCatch V59AX processor, 2K@60fps video, 2,000+ species ID. But: 850nm only (low-glow), 10m IR range, no cellular, WiFi-only, designed for backyards not fieldwork. $350 retail. Not a direct competitor for remote conservation, but validates demand for edge AI in wildlife cameras.

**Chinese 4G+Solar cameras (Noaheye, KALN, Voopeak)** — Sub-$100 solar-powered 4G cameras flooding Amazon. "AI" marketing but no real on-device inference. Poor image quality, unreliable connectivity, no-name sensors. Race to the bottom on price. Not competition for conservation use but set consumer price expectations.

---

## 3. Unique Differentiators (Validated)

### What no competitor offers today:

1. **True edge AI with dedicated NPU** — 600 GOPS Neural-ART NPU runs MegaDetector + species classifier on-device in <350ms per frame. Browning's AI is cloud-only. Sentinel uses Raspberry Pi-class ARM. Behold uses an ISP-integrated chip (iCatch V59AX) — capable but not NPU-class. No competitor has a purpose-built neural processor in a trail camera form factor.

2. **Strobed IR illumination** — 30 ms per frame vs 1500 ms continuous. **80% IR energy reduction**. No competitor strobes. This is the single biggest battery life advantage. Reconyx's 150ft range is impressive but burns continuous power.

3. **Modular IR daughter board** — 5 field-swappable LED modules (940nm standard, 940nm long range, 850nm research, white flash, blank). Tactacam's switchable flash is electronic (same LEDs, different drive current). Ours is physical module swap — different LED types, beam patterns, and wavelengths. Researchers can swap modules without tools.

4. **Smart alerting without subscription** — Only sends LTE alerts on confirmed species detection (AI-filtered). SMS with thumbnail — works on any phone, no app required. Competitors either upload everything ($5–20/mo per camera) or require their proprietary app. At 10 cameras, subscription costs are $600–2,400/year.

5. **WiFi bulk offload** — ESP32-C3 creates WiFi AP, phone connects directly, downloads all images over HTTPS. Tactacam has WiFi too, but for app-mediated preview, not bulk download. Our approach: no cloud, no subscription, no cell data usage for image retrieval.

6. **True 4K sensor with STARVIS 2 NIR** — Sony IMX678 is a genuine 8MP 4K sensor. Reconyx now also has true 4K (HyperFire 4K) but at $400. Behold uses IMX675 (same STARVIS 2 family, smaller 1/2.8" vs our 1/1.8"). Our NIR sensitivity extends to ~1000 nm — critical for 940nm no-glow performance.

7. **Shared modem daughter card** — Same 20-pin interface as Trap Monitor. 5G D2C (Starlink direct-to-cell) is a card swap, not a new camera. No competitor has a modular upgrade path to satellite connectivity.

8. **Dual-MCU architecture** — STM32U0 handles sleep/wake at 2 µA. Main MCU is fully power-gated. Sleep budget is 37 µA total — competitive with simple PIR-only cameras despite having an 800 MHz AI processor on board.

---

## 4. Where Competitors Win (Updated)

| Area | Competitor | Advantage | Our Response |
|---|---|---|---|
| **Trigger speed** | Browning (135 ms) | Fastest on market | Our ~200 ms is competitive. Burst capture compensates — 10 frames covers the animal's transit. |
| **Video** | Reconyx 4K (4K@30fps + audio), Behold (2K@60fps) | Video is increasingly expected | We capture 10-frame 4K bursts. Video could be added via firmware but is not a priority — conservation workflows are image-based. |
| **IR range** | Reconyx (45m / 150ft) | Best-in-class night illumination | Our modular approach means a long-range module can be purpose-built. Standard module optimises for power, not range. |
| **Livestreaming** | Browning + Tactacam (1080p live to phone) | Real-time viewing is a strong hunting feature | Not relevant for conservation deployment. Camera sleeps 99%+ of the time. |
| **Extreme cold** | Reconyx (-20°C) | Wider operating range | Our 0–50°C is tropical-optimised. Not a priority market. |
| **Price** | SpyPoint Flex G-36 ($100), Chinese ($60–80) | Cheapest cellular | Our BOM is ~$120–150 but includes edge AI, 4K sensor, and no subscription. TCO over 12 months is lower. |
| **Mesh networking** | CuddeLink (24 cams, 1 plan) | Massive cost savings at scale | Not in scope for Rev A. ESP32-C3 could support ESP-NOW mesh in future firmware. |
| **Anti-theft** | Tactacam (active GPS, tracks when off) | Strong for high-theft areas | Our GPS logs position. Active tracking when powered off is clever but adds standby draw. |
| **Species breadth** | Behold (2,000+ species NA/EU) | More species than our 135 AU | We focus on Australian species (135 via Addax AWC dataset). Depth over breadth. Behold's 2,000 are NA/EU — no AU coverage. |
| **Research pedigree** | Reconyx (5-year warranty, gold standard) | Trusted by ecologists for 20+ years | We target a different segment — AI-enabled conservation, not manual photo review. |
| **Consumer appeal** | Behold (Pentagram-designed, NFC setup) | Beautiful, accessible product | We're not competing for backyards. Our market is remote, rugged, professional. |
| **Satellite comms** | Sentinel (satellite + LoRa) | Works without cell coverage | D2C via Starlink Band 7 is on our roadmap (modem card swap). |

---

## 5. Total Cost of Ownership (12 months, 10 cameras)

| Cost Item | Between 23° | SpyPoint Flex G-36 | Browning Vision Pro Live | Reconyx HyperFire 4K | Tactacam Reveal Ultra | Behold Cam-1 |
|---|---|---|---|---|---|---|
| Hardware (×10) | ~$1,500 | $1,000 | $2,200 | $4,000 | $2,000 | $3,500 |
| Data plan (12 mo) | $0 (SMS) or ~$120 MQTT | $600 ($5/mo ×10 ×12) | ~$1,200 (est.) | ~$1,200 (optional cell) | ~$600 ($5/mo ×10 ×12) | $0 (WiFi only) |
| SD cards (×10) | $150 (256 GB) | $100 (32 GB) | $100 (32 GB) | $100 (32 GB) | $0 (16 GB internal) | $0 (128 GB internal) |
| Batteries (12 mo) | $0 (NiMH rechargeable) | $200 (lithium AAs) | $200 (lithium AAs) | $0 (lithium, 2yr life) | $300 (lithium AAs) | USB-C recharge |
| Solar panels (×10) | $100 (optional) | N/A | N/A | N/A | N/A | N/A |
| Manual review labour | **Minimal (AI pre-filtered)** | 100% manual | Cloud AI (partial) | 100% manual | 100% manual | AI-filtered (WiFi range) |
| **Total (12 mo)** | **~$1,750–$1,870** | **$1,900** | **$3,700** | **$5,300** | **$2,900** | **$3,500** |
| **Remote deployment?** | Yes (LTE alerts) | Yes (LTE) | Yes (LTE) | Yes (if cell add-on) | Yes (LTE) | **No (WiFi range only)** |

**Key insight:** Between 23° has the lowest TCO of any camera with AI capability, and the lowest TCO of any camera suitable for remote deployment at scale.

---

## 6. Market Positioning

```
                        ┌───────────────────────────────────────────────┐
                        │            HIGH INTELLIGENCE                  │
                        │                                               │
                        │   ┌─────────────┐                             │
                        │   │ Between 23° │ ← Edge NPU + 4K            │
                        │   │  $120-150   │   + strobed IR + modular    │
                        │   └─────────────┘   + LTE + WiFi offload     │
                        │                                               │
                        │  ┌──────────┐   ┌──────────┐                  │
                        │  │ Behold   │   │ Sentinel │ ← Edge AI       │
                        │  │  $350    │   │ waitlist  │   add-on for    │
                        │  │(backyard)│   │          │   existing cams  │
                        │  └──────────┘   └──────────┘                  │
                        │                                               │
          LOW COST ─────┼───────────────────────────────────────────────┼── HIGH COST
                        │                                               │
                        │  ┌──────────┐  ┌──────────┐  ┌──────────┐    │
                        │  │ SpyPoint │  │ Tactacam │  │ Browning │    │
                        │  │  $100    │  │  Ultra   │  │  $220    │    │
                        │  │ (no AI)  │  │  $200    │  │(cloud AI)│    │
                        │  └──────────┘  │ (no AI)  │  └──────────┘    │
                        │                └──────────┘                   │
                        │                       ┌──────────┐            │
                        │                       │ Reconyx  │            │
                        │                       │ 4K $400  │            │
                        │                       │ (no AI)  │            │
                        │                       └──────────┘            │
                        │            LOW INTELLIGENCE                   │
                        └───────────────────────────────────────────────┘
```

---

## 7. Addressable Market — Australia & Pacific

### 7.1 Camera Traps Currently Deployed in Australia

~10,000 camera traps are deployed across Australia at any time. Usage became common after 2008 and has grown exponentially since 2010. Users include:

- Universities and research institutions (TERN Ecosystem Surveillance network)
- State/territory government environment departments
- Indigenous ranger groups (127 groups, 78 organisations, funded through 2028)
- Australian Wildlife Conservancy (AWC) reserves
- Environmental consultancies (impact assessments)
- Pastoral land managers (pest and feral animal monitoring)

### 7.2 Indigenous Ranger Programs (Primary Target)

| Metric | Value |
|---|---|
| Funded ranger groups | 127 (from 78 organisations) |
| Expansion (Round 2) | 82 new projects, 58 new organisations, 900+ ranger jobs |
| Total IRP budget | Ongoing to 2028 |
| IPA grant round (Jan 2026) | Up to $13M over 2 years for 8+ new IPAs |
| Biosecurity program | $12.5M invested since 2016 |
| NAILSMA pest management | $6M (including $2M Sep 2025 top-up) |
| Equipment budget trend | iPads, laptops, cameras, GPS, drones, thermal cameras being purchased |

**Why this matters:** 127 ranger groups × 10–30 cameras each = **1,270–3,810 units** in the primary target segment alone. At $150/unit that's $190K–$570K hardware revenue, but the real value is:
- Recurring relationships (battery/solar/SD card consumables, firmware updates)
- Dataset partnership (Addax species model improvement)
- Reference deployments for research and government customers

### 7.3 Research & Government

| Customer Type | Est. Camera Count | Notes |
|---|---|---|
| TERN network sites | ~2,000+ | National ecological monitoring |
| AWC reserves | ~1,000+ | 30+ sanctuaries across AU |
| State/territory depts | ~3,000+ | Threatened species, feral animal programs |
| Environmental consultancies | ~2,000+ | Impact assessments, mine site monitoring |
| NZ conservation (DOC) | ~1,000+ | $30M biodiversity allocation, predator control |

**Total estimated AU/NZ installed base: ~10,000–15,000 camera traps.**

Replacement cycle is 3–5 years. Annual replacement demand: ~2,000–5,000 units/year.

### 7.4 Funding Pathways

| Program | Amount | Relevance |
|---|---|---|
| Indigenous Rangers Program (IRP) | Multi-year to 2028 | Equipment procurement for ranger groups |
| Indigenous Protected Areas grants | $13M over 2 years (2026–2028) | New IPAs need monitoring equipment |
| Innovative Biodiversity Monitoring Grants | A$750K per project | Specifically for AI-enabled camera traps |
| Nature Repair Market grants | Various | Biodiversity credit verification needs monitoring |
| Taronga Field Conservation Grants | Up to $25K per project | Small grants, but multiplied across many groups |
| NAILSMA pest management | $6M | Northern AU Indigenous rangers |
| NZ DOC Predator Free 2050 | $30M biodiversity allocation | Invasive species monitoring |

### 7.5 Realistic Addressable Market (3-year)

| Segment | Units (Yr 1) | Units (Yr 2) | Units (Yr 3) | Revenue (3yr) |
|---|---|---|---|---|
| Indigenous ranger pilots (Tiwi, Arnhem) | 50–100 | 200–400 | 500–1,000 | $112K–$225K |
| Research partners (universities) | 20–50 | 100–200 | 200–400 | $48K–$97K |
| AWC / conservation NGOs | 0 | 50–100 | 200–500 | $37K–$90K |
| Government programs | 0 | 50–100 | 200–500 | $37K–$90K |
| Pastoral / agriculture | 0 | 20–50 | 100–200 | $18K–$37K |
| **Total** | **70–150** | **420–850** | **1,200–2,600** | **$252K–$539K** |

These are conservative estimates at $150/unit BOM. Retail pricing TBD but ~$250–350 end-user price is realistic given the feature set vs Reconyx at $400 with no AI.

---

## 8. Competitive Threat Assessment

### Threats that matter:

| Threat | Probability | Timeline | Impact | Response |
|---|---|---|---|---|
| **Reconyx adds AI** | Medium | 18–24 months | High — they have brand + distribution | Our NPU hardware is 2+ years ahead. Reconyx would need a complete platform redesign. |
| **Sentinel ships integrated camera** | Medium | 12–18 months | Medium — currently add-on only | Our integrated design is inherently more power-efficient. Sentinel's RPi-class compute can't match NPU performance per watt. |
| **Behold expands to conservation** | Low | 24+ months | Low — designed for backyards | 850nm only, 10m IR range, no cellular, not ruggedised. Would need complete redesign. |
| **Browning adds edge AI** | Low | 24+ months | Medium — large distribution network | Browning's business model depends on cloud subscriptions. Edge AI cannibalises their recurring revenue. |
| **Chinese cameras add real AI** | Low–Medium | 12–24 months | Low — quality/reliability issues | Conservation buyers need reliability. No Chinese brand has conservation credibility. But price pressure is real. |
| **Tactacam adds AI** | Medium | 12–18 months | Medium — reviewer explicitly asked for it | Tactacam is hunting-focused, not conservation. But if they add AI + 940nm, they'd compete on features at $200. |
| **SpyPoint adds edge AI** | Low | 24+ months | Low — budget segment | SpyPoint competes on price. Edge AI adds BOM cost that conflicts with their positioning. |

### Threats that don't matter:

- **Generic Chinese 4G cameras** — "AI" on Amazon listing ≠ actual on-device inference. No conservation buyer trusts these.
- **Backyard cameras (Behold, Ring, Arlo)** — Wrong form factor, wrong connectivity, wrong durability for field deployment.
- **DIY Raspberry Pi builds** — Some researchers build these. Power consumption is 10–50× worse. Not scalable.

---

## 9. Key Risks (Updated)

| Risk | Severity | Mitigation |
|---|---|---|
| IMX678 supply (Sony distributor, single source) | High | Qualify IMX585 as fallback (same footprint, 4K, lower NIR sensitivity). Behold's use of IMX675 validates Sony STARVIS 2 supply chain. |
| STM32N6 is new silicon (2024 launch) | Medium | Errata monitoring. Alif E8 is planned migration path (est. late 2026). |
| No field-proven track record | High | Validation mode builds trust. Tiwi Land Council pilot. Partner with TERN or AWC for credibility. |
| Reconyx brand loyalty in research | Medium | Target AI-forward researchers, Indigenous ranger programs, and conservation NGOs — segments Reconyx doesn't actively serve. |
| Reconyx HyperFire 4K raises the bar | Medium | They matched our sensor resolution. We still have edge AI, strobed IR, modular design, and lower TCO. |
| Behold validates consumer demand but could expand | Low | Different market. But validates that edge AI + species ID in cameras has demand. Good for the category. |
| SpyPoint/Browning/Tactacam price pressure | Low | We compete on intelligence, TCO, and no-subscription model — not unit price. |
| Sentinel ships faster than expected | Medium | Our integrated design is fundamentally more power-efficient. Sentinel is an add-on bolted onto existing cameras. |
| Funding cycle dependency | Medium | Diversify across ranger programs, research grants, government tenders, and pastoral. Don't depend on a single program. |
| Australian market too small to sustain hardware R&D | Medium | NZ, Pacific Islands, Southeast Asia are logical expansion markets with similar conservation needs. |

---

## 10. Strategic Recommendations

1. **Lock in Tiwi Land Council pilot** — First 50 units. Build reference deployment before Reconyx or Sentinel enter the AI-conservation space.

2. **Partner with TERN or AWC** — Academic/conservation credibility. Offer validation-mode cameras for independent testing. Get published.

3. **Apply for Innovative Biodiversity Monitoring Grant** — A$750K is available for exactly this. Fund pilot manufacturing run.

4. **Price at $299 retail** — Below Reconyx 4K ($400), below Behold ($350), above SpyPoint ($100). Justified by edge AI + no subscription. BOM margin of ~50% at this price.

5. **Don't chase video** — Every competitor is adding video. Conservation workflows process images, not video. 10-frame 4K burst with AI filtering is more useful than 30fps video with no AI.

6. **Watch Tactacam** — They have distribution, decent hardware, and their reviewers are asking for AI. If they add on-device AI in 2027, they become the most dangerous competitor.

7. **Prepare NZ expansion** — DOC's Predator Free 2050 program has budget and needs exactly this: AI-enabled camera traps for invasive species monitoring.

8. **Build for international modem variants** — EG800Q supports regional band variants. Design the modem daughter card for easy region swaps (AU/NZ → Africa → SE Asia) without main board changes.

---

## 11. International Market Opportunity

### 11.1 Global Market by Region

| Region | Market Share (2025) | CAGR | Key Drivers |
|---|---|---|---|
| **North America** | ~41% (~$370M) | 6% | Hunting, recreation, security. Mature market. |
| **Europe** | ~16% (~$145M) | 7% | Conservation research, EU LIFE Programme (€5.4B 2026–2033), Natura 2000 monitoring |
| **Asia-Pacific** | ~40% (~$360M) | **9%** | Fastest growing. AU, CN, IN conservation spend + outdoor recreation |
| **Latin America** | ~3% (~$25M) | 8% | Anti-poaching, biodiversity studies, GEF funding |
| **Africa** | <1% | High growth | Anti-poaching, IWT, donor-funded conservation technology |

**Total global trail camera market: ~$906M (2025), growing to ~$1.3B by 2030.**

### 11.2 International Conservation Funding (Available for Camera Trap Procurement)

| Program | Budget | Geography | Relevance |
|---|---|---|---|
| **Global Wildlife Program (GEF/World Bank)** | $352M GEF + $2B co-financing | 38 countries (Africa, Asia, LatAm, Caribbean) | Anti-poaching, wildlife monitoring technology |
| **EU LIFE Programme** | €5.4B (2026–2033) | EU member states | Biodiversity monitoring, Natura 2000 sites. 28% budget increase in 2023 for wildlife monitoring. |
| **Illegal Wildlife Trade donors** | $3.63B since 2010 (73 donors) | Global (Africa focus) | Smart camera traps for anti-poaching corridors |
| **UNDP BIOFIN** | $2.7B unlocked for nature | Developing countries | Biodiversity finance, monitoring equipment |
| **GEF Trust Fund (2025)** | $67M new package (9 projects) | Fragile ecosystems, climate-vulnerable communities | Conservation technology procurement |
| **NZ Predator Free 2050** | $30M biodiversity allocation | New Zealand | Invasive species monitoring — perfect fit |

### 11.3 Regional Opportunity Assessment

#### Africa — Anti-Poaching & Wildlife Corridors

- **Demand signal:** TrailGuard AI deployed in Serengeti — 30 poachers arrested, 1,300 lbs of poached animals seized. Rwanda's Akagera is world's first "smart park" with LoRaWAN + AI cameras. Kenya Wildlife Service investing heavily in AI cameras for corridors.
- **Market size:** Small unit volumes but high-value funded deployments. Typical project: 50–200 cameras funded by GEF/World Bank/WWF.
- **Fit for Between 23°:** Strong. Edge AI + satellite connectivity (D2C roadmap) is exactly what remote African reserves need. Our 0–50°C tropical rating matches sub-Saharan conditions. MegaDetector v5 works globally — species classifier would need retraining for African megafauna.
- **Barriers:** Distribution, in-country support, customs, corruption. Need NGO/conservation partner (WWF, WCS, ZSL) as channel.
- **Modem variant:** EG800Q regional bands. Many sites are beyond cellular — satellite D2C becomes critical.

#### Southeast Asia — Tropical Biodiversity Hotspot

- **Demand signal:** 239 camera trap studies documented across the region (CamTrapAsia dataset). 876,606 trap nights across Indonesia, Malaysia, Thailand, Vietnam, Myanmar, Cambodia, Laos. But 64% of studies are outside the highest-risk areas — the monitoring gap is in the most remote, tropical sites.
- **Market size:** Growing research demand. Borneo, Sumatra, mainland SE Asia rainforests. Similar conditions to northern Australia (tropical, humid, remote).
- **Fit for Between 23°:** Excellent. Our tropical rating, edge AI (no cellular dependence for AI function), and long battery life match SE Asian deployment conditions. Species classifier needs regional models.
- **Barriers:** Price sensitivity (research budgets are smaller than AU/EU). Chinese camera traps dominate on price. Need to compete on capability, not cost.

#### Europe — Research & Conservation Networks

- **Demand signal:** Snapshot Europe coordinates hundreds of scientists across the continent for annual camera trap surveys. EU LIFE Programme provides €5.4B for environment/climate action 2026–2033. Germany, France, and UK lead in research deployments. Automated camera trap systems are 40% more cost-efficient than traditional setups.
- **Market size:** ~$145M, growing at 7% CAGR. Quality-conscious buyers willing to pay premium for engineering and warranty.
- **Fit for Between 23°:** Good. European researchers want data quality, reliability, and automated analysis — all our strengths. But they also want cold-weather operation (-20°C) which we don't optimise for. Video capability increasingly expected.
- **Barriers:** CE marking required. GDPR implications for cameras that could capture humans (our AI could filter humans — actually a selling point). Reconyx has strong European distribution.

#### Latin America — Biodiversity & Anti-Poaching

- **Demand signal:** Amazon and Congo basins have the least camera trap research despite highest conservation need. GEF/World Bank actively funding conservation tech in Colombia, Panama, Brazil.
- **Market size:** Small but growing, mostly donor-funded projects.
- **Fit for Between 23°:** Good — tropical conditions match. Amazon deployments need satellite connectivity (no cellular). Species classifier needs retraining.
- **Barriers:** Distribution, import duties, in-country support. Need conservation NGO partner.

### 11.4 International Expansion Roadmap

| Phase | Timeline | Market | Strategy | Est. Units |
|---|---|---|---|---|
| **Phase 1** | Yr 1–2 | Australia + NZ | Indigenous rangers, TERN, AWC, NZ DOC | 500–2,600 |
| **Phase 2** | Yr 2–3 | SE Asia + Pacific Islands | Research partnerships (Borneo, PNG, Fiji) | 200–500 |
| **Phase 3** | Yr 2–4 | Africa | NGO-partnered anti-poaching deployments (GEF-funded) | 200–1,000 |
| **Phase 4** | Yr 3–5 | Europe | Research networks, Natura 2000 sites | 500–2,000 |
| **Phase 5** | Yr 4+ | Latin America | Amazon/Pantanal conservation projects | 100–500 |

**Total addressable market (5-year): 1,500–6,600 units** at the conservation/research tier.

### 11.5 International Requirements

| Requirement | AU/NZ (Phase 1) | SE Asia (Phase 2) | Africa (Phase 3) | Europe (Phase 4) |
|---|---|---|---|---|
| Modem bands | Band 28 + Band 7 | Regional variants | Regional + satellite | EU LTE bands |
| Species model | 135 AU species | Regional retrain | African megafauna | European wildlife |
| Certifications | RCM (AU) | Regional type approval | Varies | CE marking |
| Cold weather | Not needed | Not needed | Not needed (sub-Saharan) | -10 to -20°C needed |
| Connectivity | LTE adequate | LTE + satellite | Satellite critical | LTE adequate |
| Distribution | Direct + ranger programs | Research partners | Conservation NGOs | Distributors (Perdix, NHBS) |
| Pricing | $250–350 retail | $200–300 (grant-funded) | $200–300 (donor-funded) | $300–400 (quality tier) |

### 11.6 Key Insight — The Monitoring Gap

A 2024 Mongabay analysis found that **regions with the highest risks to wildlife have the fewest camera traps**. The Amazon, Congo Basin, and Southeast Asian tropical forests — where biodiversity loss is most severe — have the least camera trap coverage. This is not a demand problem; it's a capability problem:

- Existing cameras don't survive tropical conditions long enough
- No cellular connectivity in remote sites (need satellite)
- Manual image review is impossible at scale without AI
- Battery replacement logistics in remote sites

Between 23° addresses all four of these constraints. The international conservation market doesn't need another trail camera — it needs exactly this: a tropical-rated, AI-enabled, satellite-ready, long-battery-life camera trap that sends only the detections that matter.

---

## Sources

- [Camera Traps Market Overview (DataInsightsMarket)](https://www.datainsightsmarket.com/reports/camera-traps-1317718)
- [Trail Camera Market Size 2026–2032 (360iResearch)](https://www.360iresearch.com/library/intelligence/trail-camera)
- [Camera Traps Market 8% CAGR (OpenPR)](https://www.openpr.com/news/4348491/camera-traps-market-scaling-rapidly-with-projected-8-cagr)
- [No Glow Trail Camera Market Outlook 2026–2034 (IntelMarketResearch)](https://www.intelmarketresearch.com/no-glow-trail-camera-market-36994)
- [4G Trail Camera Trends 2025: AI & Solar (Accio)](https://www.accio.com/business/4g-trail-camera-trends)
- [Behold Cam-1 (PetaPixel)](https://petapixel.com/2025/09/04/behold-cam-1-is-a-stylish-ai-powered-wildlife-camera-designed-for-everyone/)
- [Behold Cam-1 (CineD)](https://www.cined.com/behold-cam-1-launched-on-kickstarter-easy-to-use-compact-wildlife-camera/)
- [Behold Cam-1 Official Site](https://www.behold.cam/)
- [Reconyx HyperFire 4K](https://www.reconyx.com/product/hyperfire-4k-ultra-hd-trail-camera)
- [Browning Defender Vision Pro Live](https://www.browning.com/products/trailcams/cellular-trail-cameras/defender-vision-pro-livestream.html)
- [Tactacam Reveal Ultra (GearJunkie Review)](https://gearjunkie.com/hunting/tactacam-reveal-ultra-trail-camera-review)
- [Tactacam Reveal Ultra (AllOutdoor Review)](https://www.alloutdoor.com/2026/02/19/alloutdoor-review-tactacam-reveal-ultra/)
- [Conservation X Labs Sentinel](https://conservationxlabs.com/sentinel)
- [Sentinel Interview (Mongabay)](https://news.mongabay.com/2025/09/turning-camera-traps-into-real-time-sentinels-interview-with-conservation-x-labs-dante-wasmuht/)
- [Sentinel + EarthRanger Integration](https://www.earthranger.com/news/faster-response-smarter-decisions-how-sentinel-and-earthranger-are-empowering-conservationists-to-save-wildlife)
- [Australia Camera Trap Continental Synthesis (Bruce et al. 2025)](https://onlinelibrary.wiley.com/doi/10.1111/brv.13152)
- [ARDC Camera Trap Data (Australia)](https://ardc.edu.au/article/unleashing-camera-trap-data-to-monitor-australias-wildlife-with-the-planet-research-data-commons/)
- [AI-Enabled Wildlife ID Funding (Mongabay)](https://news.mongabay.com/2024/02/new-funding-boosts-ai-enabled-wildlife-identification-project-in-australia/)
- [Indigenous Rangers Program (NIAA)](https://www.niaa.gov.au/our-work/environment-and-land/indigenous-rangers-program-irp)
- [Indigenous Protected Areas Grants (DCCEEW)](https://www.dcceew.gov.au/environment/land/indigenous-protected-areas/grants)
- [Ranger Capability Building Grants (DAFF)](https://www.agriculture.gov.au/biosecurity-trade/policy/australia/indigenous-ranger-biosecurity-program/ranger-capability-grants)
- [AI in Wildlife Conservation 2026 (Johal)](https://johal.in/ai-for-wildlife-conservation-species-identification-from-camera-traps-in-2026-2/)
- [Wildlife Tracking System Market (BusinessResearchInsights)](https://www.businessresearchinsights.com/market-reports/wildlife-tracking-system-market-118792)
- [SpyPoint Flex G-36](https://www.spypoint.com/en/products/flex-g36/cellular-trail-camera)
- [Best Trail Cameras 2026 (RosenberryRooms)](https://www.rosenberryrooms.com/best-trail-cameras-2026/)
- [New Trail Cameras 2025 (Bowhunting)](https://www.bowhunting.com/article/new-trail-cameras-for-2025-2/)
- [Trail Camera Market Regional Analysis (SkyQuest)](https://www.skyquestt.com/report/trail-camera-market)
- [Trail Camera Market Trend Analysis 2026–2035 (FundamentalBusinessInsights)](https://www.fundamentalbusinessinsights.com/industry-report/trail-camera-market-5218)
- [Global Wildlife Program (World Bank)](https://www.worldbank.org/en/programs/global-wildlife-program)
- [GWP Peer Learning 2026 (World Bank)](https://www.worldbank.org/en/news/feature/2026/02/05/peer-learning-for-conservation-success-global-wildlife-program-twinning-initiative-strengthens-collaboration-acr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)
- [IWT Donor Investment — $3.63B (World Bank)](https://www.worldbank.org/en/programs/global-wildlife-program/operations)
- [UNDP BIOFIN — $2.7B for Nature](https://www.undp.org/news/global-momentum-nature-finance-undps-biodiversity-finance-initiative-helps-countries-unlock-over-27-billion-nature)
- [Snapshot Europe 2025 (Max Planck)](https://www.ab.mpg.de/722403/snapshot-europe-2025)
- [EU LIFE Programme & Camera Trap Market (DataInsightsMarket)](https://www.datainsightsmarket.com/reports/camera-traps-1317718)
- [Camera Trap Research in Africa — Systematic Review (ScienceDirect)](https://www.sciencedirect.com/science/article/pii/S2351989422003286)
- [Regions with Highest Risks Have Fewest Camera Traps (Mongabay)](https://news.mongabay.com/2024/07/regions-with-highest-risks-to-wildlife-have-fewest-camera-traps-study-finds/)
- [TrailGuard AI in Serengeti (Africa Sustainability Matters)](https://africasustainabilitymatters.com/innovative-technologies-for-monitoring-and-conserving-wildlife/)
- [Thermal Cameras & AI for Rhino Conservation Kenya (WWF)](https://www.worldwildlife.org/news/stories/how-thermal-cameras-and-ai-are-powering-rhino-conservation-success-in-kenya/)
- [Kenya Global Conservation Tech Forum 2026 (Science Africa)](https://news.scienceafrica.co.ke/kenya-ventures-into-high-tech-to-fight-wildlife-crime/)
- [CamTrapAsia — 239 Studies, 371 Species (Ecology/Wiley)](https://esajournals.onlinelibrary.wiley.com/doi/full/10.1002/ecy.4299)
- [Conservation Technology Rising Tide (Frontiers in Ecology)](https://www.frontiersin.org/journals/ecology-and-evolution/articles/10.3389/fevo.2025.1527976/full)
- [NZ Conservation Reforms 2025 (AInvest)](https://www.ainvest.com/news/zealand-2025-tourism-conservation-reforms-strategic-opportunity-sustainable-growth-2508/)
