tobbas75/trackline/trap-monitor/.planning/phases/12-test-coverage/12-01-SUMMARY.md

---
phase: 12-test-coverage
plan: 01
subsystem: testing
tags: [vitest, mqtt, ne301, supabase-storage, camera-events, validation]

requires:
  - phase: 09-mqtt-ingestion
    provides: "ingest-mqtt edge function with NE301 and trap validation logic"
  - phase: 08-schema-storage
    provides: "camera_events, camera_detections tables and camera-images storage bucket"
provides:
  - "Portable MQTT validation module (mqtt-validation.ts) with 5 exported functions"
  - "35 test cases for MQTT ingestion validation logic"
  - "10 test cases for camera event/detection and image storage operations"
affects: [09-mqtt-ingestion, 08-schema-storage]

tech-stack:
  added: []
  patterns: ["Portable copy of edge function pure logic for frontend-side testing"]

key-files:
  created:
    - frontend/src/lib/mqtt-validation.ts
    - frontend/src/lib/mqtt-validation.test.ts
    - frontend/src/lib/camera-storage.test.ts
  modified: []

key-decisions:
  - "Extracted validation functions as portable copy rather than shared module (Deno edge function cannot import from frontend)"

patterns-established:
  - "Edge function pure logic mirrored to frontend/src/lib/ for testability with vitest"
  - "Mock Supabase client pattern with fresh mock chains per test for isolation"

requirements-completed: [TST-01, TST-02, TST-03]

duration: 2min
completed: 2026-03-29
---

# Phase 12 Plan 01: MQTT Validation and Camera Storage Tests Summary

**Portable NE301/trap MQTT validation module with 35 validation tests plus 10 mocked Supabase camera event/image storage tests**

## Performance

- **Duration:** 2 min
- **Started:** 2026-03-29T11:15:52Z
- **Completed:** 2026-03-29T11:18:03Z
- **Tasks:** 2
- **Files modified:** 3

## Accomplishments
- Extracted 5 validation functions and 2 interfaces from ingest-mqtt edge function into portable testable module
- 35 MQTT validation tests covering NE301 payload (13 cases), device ID extraction (6), topic extraction (3), trap payload (7), GPS validation (6)
- 10 camera storage tests covering event insert/query/org-scoping (5 cases) and image upload/retrieve/org-access (5 cases)

## Task Commits

Each task was committed atomically:

1. **Task 1: Extract validation functions and write MQTT validation tests** - `dd5d0af` (test)
2. **Task 2: Write camera event/detection storage and image storage tests** - `9e71e73` (test)

## Files Created/Modified
- `frontend/src/lib/mqtt-validation.ts` - Portable copy of validation logic from ingest-mqtt edge function (5 functions, 2 interfaces)
- `frontend/src/lib/mqtt-validation.test.ts` - 35 test cases for MQTT ingestion validation
- `frontend/src/lib/camera-storage.test.ts` - 10 test cases for camera event/detection and image storage operations

## Decisions Made
- Extracted validation as portable copy (not shared module) because Deno edge functions cannot import from frontend/src/lib/

## Deviations from Plan

None - plan executed exactly as written.

## Known Stubs

None - all functions are fully implemented copies from the edge function.

## Issues Encountered
None.

## User Setup Required
None - no external service configuration required.

## Next Phase Readiness
- TST-01, TST-02, TST-03 requirements satisfied
- Ready for 12-02 plan (remaining test coverage tasks)
- mqtt-validation.ts should be kept in sync with any future changes to ingest-mqtt edge function

## Self-Check: PASSED

- [x] frontend/src/lib/mqtt-validation.ts exists
- [x] frontend/src/lib/mqtt-validation.test.ts exists
- [x] frontend/src/lib/camera-storage.test.ts exists
- [x] Commit dd5d0af found in git log
- [x] Commit 9e71e73 found in git log

---
*Phase: 12-test-coverage*
*Completed: 2026-03-29*
