tobbas75/trackline/trap-monitor/.planning/phases/12-test-coverage/12-02-PLAN.md

---
phase: 12-test-coverage
plan: 02
type: execute
wave: 1
depends_on: []
files_modified:
  - frontend/src/components/dashboard/CameraEventList.test.tsx
  - frontend/src/components/dashboard/ImageViewer.test.tsx
  - frontend/src/components/dashboard/CameraEventFilters.test.tsx
  - frontend/src/components/dashboard/ProductToggle.test.tsx
autonomous: true
requirements: [TST-04, TST-05]

must_haves:
  truths:
    - "CameraEventList renders event cards with thumbnails, species, confidence, and timestamps"
    - "CameraEventList opens ImageViewer when a card is clicked"
    - "ImageViewer renders bounding box overlays with confidence-based colors"
    - "ImageViewer closes on Escape key and backdrop click"
    - "CameraEventFilters renders species dropdown, confidence slider, and date pickers"
    - "ProductToggle renders nothing for single product, shows toggle for multiple products"
    - "Overall test coverage remains >= 70%"
  artifacts:
    - path: "frontend/src/components/dashboard/CameraEventList.test.tsx"
      provides: "Rendering and interaction tests for camera event list"
      min_lines: 80
    - path: "frontend/src/components/dashboard/ImageViewer.test.tsx"
      provides: "Rendering and interaction tests for image viewer with bounding boxes"
      min_lines: 60
    - path: "frontend/src/components/dashboard/CameraEventFilters.test.tsx"
      provides: "Rendering and interaction tests for camera event filters"
      min_lines: 60
    - path: "frontend/src/components/dashboard/ProductToggle.test.tsx"
      provides: "Rendering and interaction tests for product type toggle"
      min_lines: 40
  key_links:
    - from: "frontend/src/components/dashboard/CameraEventList.test.tsx"
      to: "frontend/src/components/dashboard/CameraEventList.tsx"
      via: "Direct component import"
      pattern: "import.*CameraEventList"
    - from: "frontend/src/components/dashboard/ImageViewer.test.tsx"
      to: "frontend/src/components/dashboard/ImageViewer.tsx"
      via: "Direct component import"
      pattern: "import.*ImageViewer"
---

<objective>
Test all 4 camera dashboard components: CameraEventList, ImageViewer, CameraEventFilters, ProductToggle. Verify overall coverage remains >= 70%.

Purpose: Satisfy TST-04 (dashboard component tests) and TST-05 (coverage >= 70%) requirements.

Output: 4 component test files with rendering and interaction tests.
</objective>

<execution_context>
@C:/Software code GITs/Trap Monitor/.claude/get-shit-done/workflows/execute-plan.md
@C:/Software code GITs/Trap Monitor/.claude/get-shit-done/templates/summary.md
</execution_context>

<context>
@.planning/PROJECT.md
@.planning/ROADMAP.md
@.planning/STATE.md

@frontend/src/components/dashboard/UnitGrid.test.tsx
@frontend/src/components/dashboard/CameraEventList.tsx
@frontend/src/components/dashboard/ImageViewer.tsx
@frontend/src/components/dashboard/CameraEventFilters.tsx
@frontend/src/components/dashboard/ProductToggle.tsx
@frontend/src/lib/types.ts

<interfaces>
From frontend/src/components/dashboard/CameraEventList.tsx:
```typescript
export interface CameraEventListProps {
  events: CameraEvent[];
  getImageUrl: (imagePath: string) => string;
  maxEvents?: number;
}
```

From frontend/src/components/dashboard/ImageViewer.tsx:
```typescript
export interface ImageViewerProps {
  event: CameraEvent;
  imageUrl: string;
  onClose: () => void;
}
```

From frontend/src/components/dashboard/CameraEventFilters.tsx:
```typescript
export interface CameraEventFiltersProps {
  availableSpecies: string[];
  selectedSpecies: string | "all";
  onSpeciesChange: (species: string | "all") => void;
  confidenceThreshold: number;
  onConfidenceChange: (threshold: number) => void;
  dateRange: { start: string; end: string } | null;
  onDateRangeChange: (range: { start: string; end: string } | null) => void;
}
```

From frontend/src/components/dashboard/ProductToggle.tsx:
```typescript
export interface ProductToggleProps {
  availableProducts: DeviceType[];
  activeProduct: DeviceType | "all";
  onProductChange: (product: DeviceType | "all") => void;
}
```

From frontend/src/lib/types.ts:
```typescript
export interface CameraEvent {
  id: string; unit_id: string; org_id: string; captured_at: string;
  image_path?: string; image_width?: number; image_height?: number;
  model_name?: string; inference_time_ms?: number; battery_percent?: number;
  communication_type?: string; detection_count: number; mqtt_topic?: string;
  detections?: CameraDetection[];
}
export interface CameraDetection {
  id: string; camera_event_id: string; species_id?: string;
  class_name: string; confidence: number;
  x: number; y: number; width: number; height: number;
}
export type DeviceType = 'trap_monitor' | 'camera_trap';
```
</interfaces>
</context>

<tasks>

<task type="auto">
  <name>Task 1: Write CameraEventList and ImageViewer component tests</name>
  <files>frontend/src/components/dashboard/CameraEventList.test.tsx, frontend/src/components/dashboard/ImageViewer.test.tsx</files>
  <action>
**Read first:** `frontend/src/components/dashboard/UnitGrid.test.tsx` for test patterns, `frontend/src/components/dashboard/CameraEventList.tsx`, `frontend/src/components/dashboard/ImageViewer.tsx`, `frontend/src/lib/types.ts`.

**CameraEventList.test.tsx:**

```typescript
import { describe, it, expect, vi } from 'vitest';
import { render, screen } from '@testing-library/react';
import userEvent from '@testing-library/user-event';
import { CameraEventList } from './CameraEventList';
import type { CameraEvent } from '@/lib/types';
```

Helper function `createCameraEvent(overrides?: Partial<CameraEvent>): CameraEvent` returning:
```typescript
{
  id: 'evt-1',
  unit_id: 'CAM001',
  org_id: 'org-1',
  captured_at: new Date().toISOString(),
  image_path: 'org-1/CAM001/evt-1.jpg',
  detection_count: 1,
  detections: [{
    id: 'det-1', camera_event_id: 'evt-1', class_name: 'Possum',
    confidence: 0.92, x: 0.1, y: 0.2, width: 0.3, height: 0.4,
  }],
  ...overrides,
}
```

Default props: `getImageUrl: vi.fn((path) => \`https://storage.example.com/\${path}\`)`.

Tests:
- `it('renders "Camera Events" heading')` -- render with 1 event. Assert text "Camera Events" is in document.
- `it('renders empty state when no events')` -- events=[]. Assert "No camera events found" is in document.
- `it('renders event cards with thumbnail images')` -- 2 events with image_path. Assert 2 `<img>` elements exist. Assert getImageUrl was called.
- `it('renders placeholder when event has no image_path')` -- event with image_path undefined. Assert no `<img>` for that card (svg placeholder instead).
- `it('shows top detection species name and confidence')` -- event with detections=[{class_name: 'Possum', confidence: 0.92, ...}]. Assert "Possum" and "92%" text present.
- `it('shows "+N more" when multiple detections')` -- event with 3 detections. Assert "+2 more" text visible.
- `it('shows "No detections" when detection array empty')` -- event with detections=[]. Assert "No detections" text.
- `it('respects maxEvents prop')` -- 5 events, maxEvents=3. Assert only 3 event cards rendered (count img elements or card divs).
- `it('opens ImageViewer when event card clicked')` -- render with 1 event that has image_path. Click the card. Assert "Close image viewer" button appears (aria-label from ImageViewer).
- `it('does not open ImageViewer for event without image_path')` -- event without image_path. Click card. Assert no "Close image viewer" button.

**ImageViewer.test.tsx:**

```typescript
import { describe, it, expect, vi } from 'vitest';
import { render, screen, fireEvent } from '@testing-library/react';
import { ImageViewer } from './ImageViewer';
import type { CameraEvent } from '@/lib/types';
```

Helper: `createViewerEvent()` returning a CameraEvent with 2 detections at different confidence levels (0.9 and 0.4).

Tests:
- `it('renders the image with correct src')` -- imageUrl='https://example.com/img.jpg'. Assert img element has src matching.
- `it('renders close button with aria-label')` -- Assert button with aria-label "Close image viewer" exists.
- `it('calls onClose when close button clicked')` -- click close button. Assert onClose called once.
- `it('calls onClose when backdrop clicked')` -- click the backdrop overlay (outermost div). Assert onClose called.
- `it('does not close when image container clicked')` -- click the image container (stopPropagation). Assert onClose NOT called.
- `it('calls onClose on Escape key')` -- fireEvent.keyDown(document, { key: 'Escape' }). Assert onClose called.
- `it('renders bounding box overlays for each detection')` -- event with 2 detections. Assert 2 elements with detection labels visible (e.g., text matching class_name + confidence).
- `it('shows species label and confidence on bounding box')` -- detection with class_name='Wallaby', confidence=0.85. Assert "Wallaby 85%" text present.
- `it('applies green border for high confidence (>=0.8)')` -- detection confidence=0.9. Assert element has class containing "green".
- `it('applies yellow border for medium confidence (>=0.5, <0.8)')` -- detection confidence=0.6. Assert "yellow" class.
- `it('applies red border for low confidence (<0.5)')` -- detection confidence=0.3. Assert "red" class.
- `it('shows "No detections" when detection array empty')` -- event with detections=[]. Assert "No detections" text.
- `it('displays event metadata')` -- event with model_name='YOLOv8', battery_percent=85. Assert "Model: YOLOv8" and "Battery: 85%" text.
  </action>
  <verify>
    <automated>cd frontend && npx vitest run src/components/dashboard/CameraEventList.test.tsx src/components/dashboard/ImageViewer.test.tsx --reporter=verbose 2>&1 | tail -40</automated>
  </verify>
  <done>CameraEventList: 10 tests pass covering empty state, thumbnails, detections display, maxEvents, ImageViewer opening. ImageViewer: 13 tests pass covering image rendering, close interactions, bounding boxes with confidence colors, metadata display.</done>
</task>

<task type="auto">
  <name>Task 2: Write CameraEventFilters and ProductToggle tests, verify coverage</name>
  <files>frontend/src/components/dashboard/CameraEventFilters.test.tsx, frontend/src/components/dashboard/ProductToggle.test.tsx</files>
  <action>
**Read first:** `frontend/src/components/dashboard/CameraEventFilters.tsx`, `frontend/src/components/dashboard/ProductToggle.tsx`, `frontend/src/components/dashboard/UnitGrid.test.tsx` for patterns.

**CameraEventFilters.test.tsx:**

```typescript
import { describe, it, expect, vi } from 'vitest';
import { render, screen } from '@testing-library/react';
import userEvent from '@testing-library/user-event';
import { CameraEventFilters } from './CameraEventFilters';
```

Default props helper:
```typescript
function createDefaultProps() {
  return {
    availableSpecies: ['Possum', 'Wallaby', 'Fox'],
    selectedSpecies: 'all' as string | 'all',
    onSpeciesChange: vi.fn(),
    confidenceThreshold: 50,
    onConfidenceChange: vi.fn(),
    dateRange: null as { start: string; end: string } | null,
    onDateRangeChange: vi.fn(),
  };
}
```

Tests:
- `it('renders species dropdown with "All Species" default')` -- Assert select element exists. Assert "All Species" option present.
- `it('renders all available species as options')` -- Assert "Possum", "Wallaby", "Fox" options present.
- `it('calls onSpeciesChange when species selected')` -- user selects "Wallaby". Assert onSpeciesChange called with "Wallaby".
- `it('calls onSpeciesChange with "all" when All Species selected')` -- select "all". Assert called with "all".
- `it('renders confidence slider with current value')` -- confidenceThreshold=75. Assert slider input exists with value "75". Assert "75%" text visible.
- `it('calls onConfidenceChange when slider moved')` -- fireEvent.change on range input with value "80". Assert onConfidenceChange called with 80.
- `it('renders From and To date inputs')` -- Assert 2 date inputs exist (type="date"). Labels "From" and "To" visible.
- `it('calls onDateRangeChange when From date set')` -- user types into From date input. Assert onDateRangeChange called with object containing start.
- `it('calls onDateRangeChange(null) when From date cleared')` -- dateRange={start:'2024-01-01', end:''}, clear From input. Assert onDateRangeChange called with null.
- `it('shows "Clear dates" button when dateRange is set')` -- dateRange={start:'2024-01-01', end:'2024-01-31'}. Assert "Clear dates" button visible.
- `it('hides "Clear dates" button when dateRange is null')` -- dateRange=null. Assert "Clear dates" button NOT present.
- `it('calls onDateRangeChange(null) when Clear dates clicked')` -- click "Clear dates". Assert onDateRangeChange called with null.

**ProductToggle.test.tsx:**

```typescript
import { describe, it, expect, vi } from 'vitest';
import { render, screen } from '@testing-library/react';
import userEvent from '@testing-library/user-event';
import { ProductToggle } from './ProductToggle';
import type { DeviceType } from '@/lib/types';
```

Tests:
- `it('renders nothing when only one product available')` -- availableProducts=['trap_monitor']. Assert container is empty (nothing rendered).
- `it('renders nothing when no products available')` -- availableProducts=[]. Assert nothing rendered.
- `it('renders toggle buttons when both products available')` -- availableProducts=['trap_monitor', 'camera_trap']. Assert "All", "Trap Monitor", "Camera Trap" buttons visible.
- `it('marks active product with aria-checked=true')` -- activeProduct='camera_trap'. Assert the "Camera Trap" button has aria-checked="true". Assert "All" has aria-checked="false".
- `it('calls onProductChange when button clicked')` -- click "Camera Trap" button. Assert onProductChange called with 'camera_trap'.
- `it('calls onProductChange with "all" when All clicked')` -- click "All". Assert called with 'all'.
- `it('has radiogroup role for accessibility')` -- Assert element with role="radiogroup" exists with aria-label "Filter by product type".

**After both test files written, run full test suite with coverage:**

```bash
cd frontend && npx vitest run --coverage
```

Verify:
1. All new tests pass
2. No regressions in existing tests (235 + new tests all pass)
3. Coverage thresholds still met (lines >= 70, branches >= 65, functions >= 60, statements >= 70)
  </action>
  <verify>
    <automated>cd frontend && npx vitest run --coverage --reporter=verbose 2>&1 | tail -40</automated>
  </verify>
  <done>CameraEventFilters: 12 tests pass covering species dropdown, confidence slider, date pickers, clear button. ProductToggle: 7 tests pass covering single/multi product rendering, accessibility, callbacks. Full suite passes with coverage >= 70% thresholds maintained.</done>
</task>

</tasks>

<verification>
```bash
cd frontend && npx vitest run --coverage --reporter=verbose
```
All tests pass (existing 235 + ~42 new = ~277 total). Coverage thresholds met: lines >= 70%, branches >= 65%, functions >= 60%, statements >= 70%.
</verification>

<success_criteria>
- CameraEventList.test.tsx: 10 tests covering rendering, interactions, empty state, maxEvents, ImageViewer opening
- ImageViewer.test.tsx: 13 tests covering image display, close mechanisms, bounding box rendering with confidence colors, metadata
- CameraEventFilters.test.tsx: 12 tests covering species filter, confidence slider, date range, clear button
- ProductToggle.test.tsx: 7 tests covering single/multi product, accessibility, callbacks
- All existing tests continue to pass
- Coverage remains >= 70% (TST-05)
</success_criteria>

<output>
After completion, create `.planning/phases/12-test-coverage/12-02-SUMMARY.md`
</output>
