tobbas75/trackline/trap-monitor/.planning/phases/12-test-coverage/12-02-SUMMARY.md

---
phase: 12-test-coverage
plan: 02
subsystem: testing
tags: [vitest, react-testing-library, camera-dashboard, component-tests]

requires:
  - phase: 11-dashboard-camera
    provides: CameraEventList, ImageViewer, CameraEventFilters, ProductToggle components
provides:
  - 42 component tests for all 4 camera dashboard components
  - Coverage maintained above 70% threshold (96.66% statements)
affects: []

tech-stack:
  added: []
  patterns: [component test helpers with factory functions, fireEvent for non-bubbling clicks, confidence-based class assertions]

key-files:
  created:
    - frontend/src/components/dashboard/CameraEventList.test.tsx
    - frontend/src/components/dashboard/ImageViewer.test.tsx
    - frontend/src/components/dashboard/CameraEventFilters.test.tsx
    - frontend/src/components/dashboard/ProductToggle.test.tsx
  modified: []

key-decisions:
  - "Used fireEvent instead of userEvent for close button click to avoid event bubbling through backdrop"

patterns-established:
  - "Camera component test pattern: factory functions for CameraEvent/CameraDetection with Partial overrides"
  - "Confidence color testing: query by CSS class (border-green-400, border-yellow-400, border-red-400)"

requirements-completed: [TST-04, TST-05]

duration: 3min
completed: 2026-03-29
---

# Phase 12 Plan 02: Camera Dashboard Component Tests Summary

**42 component tests for CameraEventList, ImageViewer, CameraEventFilters, and ProductToggle with 96.66% statement coverage maintained**

## Performance

- **Duration:** 3 min
- **Started:** 2026-03-29T11:15:54Z
- **Completed:** 2026-03-29T11:18:30Z
- **Tasks:** 2
- **Files created:** 4

## Accomplishments
- CameraEventList: 10 tests covering rendering, empty state, thumbnails, detection display, maxEvents, ImageViewer opening
- ImageViewer: 13 tests covering image display, close interactions (button, backdrop, Escape), bounding boxes with confidence-based colors, metadata
- CameraEventFilters: 12 tests covering species dropdown, confidence slider, date range pickers, clear button
- ProductToggle: 7 tests covering single/multi product rendering, accessibility (radiogroup), callbacks
- Full suite: 322 tests passing, 96.66% statements, 90.29% branches, 100% functions

## Task Commits

Each task was committed atomically:

1. **Task 1: CameraEventList and ImageViewer tests** - `aa71089` (test)
2. **Task 2: CameraEventFilters and ProductToggle tests** - `c178941` (test)

## Files Created/Modified
- `frontend/src/components/dashboard/CameraEventList.test.tsx` - 10 tests: rendering, empty state, thumbnails, detections, maxEvents, ImageViewer opening
- `frontend/src/components/dashboard/ImageViewer.test.tsx` - 13 tests: image display, close mechanisms, bounding boxes, confidence colors, metadata
- `frontend/src/components/dashboard/CameraEventFilters.test.tsx` - 12 tests: species dropdown, confidence slider, date pickers, clear button
- `frontend/src/components/dashboard/ProductToggle.test.tsx` - 7 tests: single/multi product, accessibility, callbacks

## Decisions Made
- Used fireEvent for close button click instead of userEvent to avoid double onClose call from event bubbling through backdrop overlay

## Deviations from Plan

### Auto-fixed Issues

**1. [Rule 1 - Bug] Fixed CameraEventList no-image-path test using wrong event factory defaults**
- **Found during:** Task 1 (CameraEventList tests)
- **Issue:** Test for "does not open ImageViewer for event without image_path" used default event which has detections, causing getByText('No detections') to fail
- **Fix:** Passed `detections: []` override alongside `image_path: undefined`
- **Files modified:** frontend/src/components/dashboard/CameraEventList.test.tsx
- **Verification:** All 10 CameraEventList tests pass
- **Committed in:** aa71089

**2. [Rule 1 - Bug] Fixed ImageViewer close button test double-firing onClose**
- **Found during:** Task 1 (ImageViewer tests)
- **Issue:** userEvent.click on close button bubbles to backdrop overlay which also calls onClose, resulting in 2 calls instead of 1
- **Fix:** Used fireEvent.click instead of userEvent.click to avoid bubbling
- **Files modified:** frontend/src/components/dashboard/ImageViewer.test.tsx
- **Verification:** All 13 ImageViewer tests pass
- **Committed in:** aa71089

---

**Total deviations:** 2 auto-fixed (2 bugs in test setup)
**Impact on plan:** Minor test setup corrections. No scope creep.

## Issues Encountered
None beyond the auto-fixed items above.

## User Setup Required
None - no external service configuration required.

## Next Phase Readiness
- All v2.0 camera dashboard components now have comprehensive test coverage
- 322 tests passing with 96.66% statement coverage
- Phase 12 (test-coverage) is complete

---
*Phase: 12-test-coverage*
*Completed: 2026-03-29*
