tobbas75/trackline/portal/.planning/phases/05-dashboard-upgrade/05-VERIFICATION.md

---
phase: 05-dashboard-upgrade
verified: 2026-03-29T00:00:00Z
status: passed
score: 5/5 must-haves verified
re_verification: false
---

# Phase 05: Dashboard Upgrade Verification Report

**Phase Goal:** The portal dashboard app switcher shows live app status and user role badges, built with shared UI components
**Verified:** 2026-03-29
**Status:** PASSED
**Re-verification:** No — initial verification

---

## Goal Achievement

### Observable Truths

| #  | Truth | Status | Evidence |
|----|---|---|---|
| 1  | Logged-in user sees all accessible apps with role badges | VERIFIED | `dashboard/page.tsx` maps `userApps` → Card tiles each rendering `<Badge variant={roleBadgeVariant(...)}>` |
| 2  | Each app tile shows live status indicator from portal.apps.status | VERIFIED | `getUserApps()` selects `status` from `apps`; dashboard renders `STATUS_DOT[app.status]` inline dot |
| 3  | Clicking an app tile quick-launches that app | VERIFIED | Each tile wrapped in `<a href={app.url ?? "#"}>` — direct navigation to app URL |
| 4  | getUserApps() return type includes the status field from portal.apps | VERIFIED | `UserAppRow.apps.status: string` typed in `check-access.ts` line 103; in select at line 82 |
| 5  | Dashboard uses Card/Badge from @trackline/ui — no hand-rolled card divs | VERIFIED | `import { Card, CardHeader, CardBody, Badge, cn } from "@trackline/ui"` line 3; used throughout tile loop |

**Score:** 5/5 truths verified

---

### Required Artifacts

| Artifact | Expected | Status | Details |
|---|---|---|---|
| `supabase/migrations/portal_003_app_status.sql` | ALTER TABLE adding status column + CHECK constraint | VERIFIED | Exists, 14 lines, contains `ADD COLUMN IF NOT EXISTS status`, `apps_status_check` CHECK, `DEFAULT 'active'` |
| `src/lib/check-access.ts` | getUserApps() with status in select + UserAppRow  | VERIFIED | Exists, 186 lines; `status` in nested select (line 82); `status: string` in UserAppRow interface (line 103) |
| `src/app/(protected)/dashboard/page.tsx` | App switcher using Card, Badge from @trackline/ui | VERIFIED | Exists, 159 lines; imports `Card, CardHeader, CardBody, Badge, cn` from `@trackline/ui`; STATUS_DOT and roleBadgeVariant present |

---

### Key Link Verification

| From | To | Via | Status | Details |
|---|---|---|---|---|
| `dashboard/page.tsx` | `src/lib/check-access.ts` | `getUserApps()` import | WIRED | `import { getUserApps, isAdmin } from "@/lib/check-access"` line 2; called at line 44 |
| `dashboard/page.tsx` | `@trackline/ui` | named import | WIRED | `import { Card, CardHeader, CardBody, Badge, cn } from "@trackline/ui"` line 3; all used in tile loop |
| `portal_003_app_status.sql` | `portal.apps` | ALTER TABLE ADD COLUMN | WIRED | `ALTER TABLE portal.apps ADD COLUMN IF NOT EXISTS status ...` line 8-10 |

---

### Data-Flow Trace (Level 4)

| Artifact | Data Variable | Source | Produces Real Data | Status |
|---|---|---|---|---|
| `dashboard/page.tsx` | `userApps` | `getUserApps(supabase)` Supabase query | Yes — live query against `portal.app_access JOIN portal.apps` | FLOWING  |
| `dashboard/page.tsx` status dot | `app.status` | `portal.apps.status` column (05-01 migration) | Yes — fetched as part of `getUserApps` select | FLOWING  |
| `dashboard/page.tsx` role badge | `access.role` | `portal.app_access.role` column | Yes — fetched in same `getUserApps` select | FLOWING  |

No hardcoded empty arrays or static fallbacks on the render path. The only fallback is `app.url ?? "#"` for null URLs, which is correct defensive behaviour.

---

### Behavioral Spot-Checks

| Behavior | Check | Result | Status |
|---|---|---|---|
| TypeScript compiles clean | `npx tsc --noEmit` | Exit 0, no errors | PASS |
| db-check passes for migration | `node scripts/db-check.cjs supabase/migrations/portal_003_app_status.sql` | "db-check OK" Exit 0 | PASS |
| Commit 227f98f exists (migration) | `git show --stat 227f98f` | Confirmed | PASS |
| Commit 93ba745 exists (check-access status field)  | `git show --stat 93ba745` | Confirmed | PASS |
| Commit 257ef9c exists (dashboard rewrite) | `git show --stat 257ef9c` | Confirmed | PASS |

Step 7b (next build spot-check): SKIPPED — build was verified by the executing agent and documented in SUMMARY; running `next build` was out of scope for a read-only verification pass.

---

### Requirements Coverage

| Requirement | Source Plan | Description | Status | Evidence |
|---|---|---|---|---|
| DASH-01 | 05-02 | App switcher with status indicators (active/maintenance/down) and quick-launch | SATISFIED | STATUS_DOT renders coloured dot per app.status; `<a href={app.url}>` provides quick-launch |
| DASH-02 | 05-01 | App status column added to portal.apps table | SATISFIED | `portal_003_app_status.sql` migration; ADD COLUMN with DEFAULT 'active' and CHECK constraint |
| DASH-03 | 05-02 | User can see which apps they have access to with role badges | SATISFIED | Badge with `roleBadgeVariant(access.role, app.id)` rendered on every accessible app tile |

No orphaned requirements — all three DASH IDs are claimed by plans and have implementation evidence.

---

### Anti-Patterns Found

| File | Pattern | Severity | Assessment |
|---|---|---|---|
| None | — | — | No TODOs, no placeholder returns, no hardcoded empty arrays on render path |

The `return []` on error in `getUserApps()` is correct defensive fallback, not a stub — it only fires when the Supabase query errors, not on the happy path.

---

### Human Verification Required

#### 1. Visual rendering of role badges and status dots

**Test:** Sign in as a user with at least one app access row. Navigate to `/dashboard`.
**Expected:** App tiles display role badge (e.g. "admin" in red-dust, "member" in app colour, "viewer" in stone) and a coloured dot (green for active apps) before the description text.
**Why human:** Visual appearance and colour token rendering cannot be confirmed programmatically — requires browser inspection.

#### 2. Quick-launch navigation

**Test:** Click an app tile from the dashboard.
**Expected:** Browser navigates directly to the app's configured URL (e.g. the WildTrack app URL), not a portal-internal route.
**Why human:** `href={app.url}` wiring is verified, but the actual URL values in `portal.apps` depend on seeded DB data that cannot be inspected from the codebase.

#### 3. Status dot reflects DB value for maintenance/down apps

**Test:** Set a row in `portal.apps` to `status = 'maintenance'` or `status = 'down'`. Reload dashboard.
**Expected:** Corresponding tile shows amber dot (maintenance) or red dot (down).
**Why human:** Requires modifying live DB data and browser observation — not testable statically.

---

### Gaps Summary

No gaps found. All five must-have truths are verified, all three artifacts are substantive and wired, data flows from live Supabase queries through to rendered output, all three requirement IDs (DASH-01, DASH-02, DASH-03) are satisfied with direct implementation evidence, and no blocker anti-patterns were found.

The only outstanding items are three human verification tests that confirm visual correctness and live DB behaviour — these do not block goal achievement determination.

---

_Verified: 2026-03-29_
_Verifier: Claude (gsd-verifier)_
