tobbas75/trackline/trap-monitor/.planning/phases/07-test-coverage/07-01-PLAN.md

---
phase: 07-test-coverage
plan: 01
type: execute
wave: 1
depends_on: []
files_modified:
  - frontend/src/lib/check-access.test.ts
  - frontend/src/app/api/orgs/[orgId]/route.test.ts
  - frontend/src/app/api/orgs/[orgId]/units/route.test.ts
  - frontend/src/app/api/orgs/[orgId]/units/[unitId]/route.test.ts
autonomous: true
requirements: [TEST-03, TEST-07]

must_haves:
  truths:
    - "checkAppAccess returns hasAccess=true when RPC succeeds with access"
    - "checkAppAccess returns hasAccess=false when portal infra is missing (SEC-05 fail-closed)"
    - "checkAppAccess returns hasAccess=false when RPC returns empty data"
    - "getUserApps returns array of user app rows from portal schema"
    - "DELETE /api/orgs/:orgId rejects non-owners with 403"
    - "DELETE /api/orgs/:orgId succeeds for owner and deletes org"
    - "GET /api/orgs/:orgId/units returns units scoped to org_id"
    - "POST /api/orgs/:orgId/units validates required fields (id, name)"
    - "GET /api/orgs/:orgId/units/:unitId returns single unit scoped by org_id"
    - "PUT /api/orgs/:orgId/units/:unitId updates unit fields"
    - "DELETE /api/orgs/:orgId/units/:unitId deletes unit scoped by org_id"
  artifacts:
    - path: "frontend/src/lib/check-access.test.ts"
      provides: "Tests for checkAppAccess and getUserApps — portal access gating"
      min_lines: 80
    - path: "frontend/src/app/api/orgs/[orgId]/route.test.ts"
      provides: "Tests for DELETE /api/orgs/:orgId — owner-only org deletion"
      min_lines: 50
    - path: "frontend/src/app/api/orgs/[orgId]/units/route.test.ts"
      provides: "Tests for GET and POST /api/orgs/:orgId/units — unit list and creation"
      min_lines: 60
    - path: "frontend/src/app/api/orgs/[orgId]/units/[unitId]/route.test.ts"
      provides: "Tests for GET, PUT, DELETE /api/orgs/:orgId/units/:unitId — single unit CRUD"
      min_lines: 70
  key_links:
    - from: "frontend/src/lib/check-access.test.ts"
      to: "frontend/src/lib/check-access.ts"
      via: "imports checkAppAccess and getUserApps, mocks SupabaseClient"
      pattern: "import.*checkAppAccess.*from"
    - from: "frontend/src/app/api/orgs/[orgId]/route.test.ts"
      to: "frontend/src/app/api/orgs/[orgId]/route.ts"
      via: "imports DELETE handler, mocks @/lib/supabase/server"
      pattern: "import.*DELETE.*from"
---

<objective>
Add tests for currently-untested files: check-access.ts (portal access gating with SEC-05 fail-closed behavior) and the org/unit CRUD API routes (orgs/[orgId], orgs/[orgId]/units, orgs/[orgId]/units/[unitId]).

Purpose: Raise global test coverage from ~60% toward ~70% by covering the 4 files at 0% coverage that are server-side API routes with straightforward mocking patterns. The check-access.ts tests are especially important since they verify the SEC-05 fail-closed security behavior.

Output: 4 new test files adding ~30-40 tests, covering previously-untested server-side logic.
</objective>

<execution_context>
@C:/GITS/trap-monitor/.claude/get-shit-done/workflows/execute-plan.md
@C:/GITS/trap-monitor/.claude/get-shit-done/templates/summary.md
</execution_context>

<context>
@.planning/PROJECT.md
@.planning/ROADMAP.md
@.planning/STATE.md
@.planning/codebase/TESTING.md

@.planning/phases/7/07-02-SUMMARY.md

@frontend/vitest.config.ts
@frontend/package.json
</context>

<interfaces>
<!-- Source files under test -- executor needs these contracts to write mocks -->

From frontend/src/lib/check-access.ts:
```typescript
import type { SupabaseClient } from "@supabase/supabase-js";

export type AppId = "wildtrack" | "fire" | "trap_monitor";
export type AppRole = "viewer" | "member" | "admin";
export interface AppAccess { hasAccess: boolean; role: AppRole | null; }

// Calls supabase.rpc("check_app_access", { target_app_id: appId })
// SEC-05: Returns hasAccess=false when portal infra missing (error contains
//   "check_app_access" or "schema cache" or "Invalid schema: portal")
export async function checkAppAccess(supabase: SupabaseClient, appId: AppId): Promise<AppAccess>;

// Calls supabase.schema("portal").from("app_access").select(...)
export async function getUserApps(supabase: SupabaseClient): Promise<UserAppRow[]>;
```

From frontend/src/app/api/orgs/[orgId]/route.ts:
```typescript
import { createClient } from "@/lib/supabase/server";
// DELETE: checks user is owner via org_members lookup, then deletes org
// Returns: 401 (unauth), 403 (not owner), 500 (db error), 200 ({success: true})
export async function DELETE(req: Request, { params }: { params: Promise<{ orgId: string }> }): Promise<NextResponse>;
```

From frontend/src/app/api/orgs/[orgId]/units/route.ts:
```typescript
import { createClient } from "@/lib/supabase/server";
// GET: lists units filtered by org_id from params
// POST: creates unit with org_id from params, requires id and name
export async function GET(req: NextRequest, context: { params: Promise<{ orgId: string }> }): Promise<NextResponse>;
export async function POST(req: NextRequest, context: { params: Promise<{ orgId: string }> }): Promise<NextResponse>;
```

From frontend/src/app/api/orgs/[orgId]/units/[unitId]/route.ts:
```typescript
import { createClient } from "@/lib/supabase/server";
// GET: single unit by id + org_id
// PUT: update unit by id + org_id
// DELETE: delete unit by id + org_id
export async function GET(req: NextRequest, context: { params: Promise<{ orgId: string; unitId: string }> }): Promise<NextResponse>;
export async function PUT(req: NextRequest, context: { params: Promise<{ orgId: string; unitId: string }> }): Promise<NextResponse>;
export async function DELETE(req: NextRequest, context: { params: Promise<{ orgId: string; unitId: string }> }): Promise<NextResponse>;
```

Existing test patterns from 07-02-SUMMARY.md:
- Mock `@/lib/supabase/server`: `vi.mock('@/lib/supabase/server', () => ({ createClient: vi.fn().mockResolvedValue(mockSupabase) }))`
- Chainable mock: `mockFrom -> select -> eq -> single` pattern
- Auth guard: `mockGetUser.mockResolvedValue({ data: { user: null }, error: null })`
- Next.js route params: pass `{ params: Promise.resolve({ orgId: 'org-1' }) }` as second arg
</interfaces>

<tasks>

<task type="auto" tdd="true">
  <name>Task 1: Write check-access.ts tests (portal access gating + SEC-05)</name>
  <files>frontend/src/lib/check-access.test.ts</files>
  <behavior>
    checkAppAccess:
    - RPC succeeds with has_access=true, user_role="admin" -> { hasAccess: true, role: "admin" }
    - RPC succeeds with has_access=false -> { hasAccess: false, role: null }
    - RPC returns empty data array -> { hasAccess: false, role: null }
    - RPC returns null data -> { hasAccess: false, role: null }
    - RPC error "check_app_access" (function missing) -> { hasAccess: false, role: null } (SEC-05)
    - RPC error "schema cache" -> { hasAccess: false, role: null } (SEC-05)
    - RPC error "Invalid schema: portal" -> { hasAccess: false, role: null } (SEC-05)
    - RPC generic error (not portal infra) -> { hasAccess: false, role: null }
    - console.warn is called when portal infra missing (structured JSON log)

    getUserApps:
    - Returns array of app rows on success
    - Returns empty array on error
    - Returns empty array when data is null
  </behavior>
  <action>
    Create `frontend/src/lib/check-access.test.ts`.

    **Mocking strategy:** checkAppAccess and getUserApps accept a `SupabaseClient` parameter directly (they do NOT call createClient internally). This means we create a mock object inline — no module-level vi.mock needed.

    ```typescript
    import { describe, it, expect, vi } from 'vitest';
    import { checkAppAccess, getUserApps } from './check-access';

    function createMockSupabase(overrides: { rpcResult?: any; schemaResult?: any } = {}) {
      return {
        rpc: vi.fn().mockResolvedValue(overrides.rpcResult ?? { data: [], error: null }),
        schema: vi.fn().mockReturnValue({
          from: vi.fn().mockReturnValue({
            select: vi.fn().mockResolvedValue(overrides.schemaResult ?? { data: [], error: null }),
          }),
        }),
      } as any;
    }
    ```

    **checkAppAccess tests:**
    - Test success: `rpc` returns `{ data: [{ has_access: true, user_role: 'admin' }], error: null }` -> verify hasAccess=true, role="admin"
    - Test no access: `rpc` returns `{ data: [{ has_access: false, user_role: null }], error: null }` -> verify hasAccess=false
    - Test empty data: `rpc` returns `{ data: [], error: null }` -> verify hasAccess=false
    - Test null data: `rpc` returns `{ data: null, error: null }` -> verify hasAccess=false
    - Test SEC-05 portal missing (3 variants): `rpc` returns error with message containing "check_app_access" or "schema cache" or "Invalid schema: portal" -> verify hasAccess=false, role=null
    - Test SEC-05 console.warn: spy on `console.warn`, verify it's called with structured JSON containing "portal_access_check_unavailable"
    - Test generic RPC error: `rpc` returns error `{ message: 'some other error' }` -> verify hasAccess=false (but no console.warn since it's not infra-missing)
    - Verify rpc is called with correct args: `supabase.rpc("check_app_access", { target_app_id: "trap_monitor" })`

    **getUserApps tests:**
    - Test success: schema().from().select() returns `{ data: [{ app_id: 'trap_monitor', role: 'admin', ... }], error: null }` -> returns the data array
    - Test error: returns empty array
    - Test null data: returns empty array
    - Verify schema is called with "portal" and from is called with "app_access"
  </action>
  <verify>
    <automated>cd frontend && npx vitest run src/lib/check-access.test.ts</automated>
  </verify>
  <done>check-access.ts fully tested. SEC-05 fail-closed behavior verified for all 3 portal-missing error patterns. getUserApps tested for success and error paths. console.warn spy confirms structured logging on portal infra failure.</done>
</task>

<task type="auto" tdd="true">
  <name>Task 2: Write org/unit CRUD API route tests</name>
  <files>frontend/src/app/api/orgs/[orgId]/route.test.ts, frontend/src/app/api/orgs/[orgId]/units/route.test.ts, frontend/src/app/api/orgs/[orgId]/units/[unitId]/route.test.ts</files>
  <behavior>
    orgs/[orgId]/route.test.ts — DELETE:
    - Unauthenticated -> 401
    - Authenticated but not owner (role=member) -> 403
    - Authenticated owner -> 200 {success: true}
    - DB error on delete -> 500

    orgs/[orgId]/units/route.test.ts — GET:
    - Returns units filtered by org_id -> 200
    - DB error -> 500

    orgs/[orgId]/units/route.test.ts — POST:
    - Missing id -> 400
    - Missing name -> 400
    - Valid body -> 201 with unit data, org_id set from params
    - DB error -> 500

    orgs/[orgId]/units/[unitId]/route.test.ts — GET:
    - Returns unit by id + org_id -> 200
    - Not found -> 404

    orgs/[orgId]/units/[unitId]/route.test.ts — PUT:
    - Updates unit -> 200
    - DB error -> 500

    orgs/[orgId]/units/[unitId]/route.test.ts — DELETE:
    - Deletes unit -> 200 {success: true}
    - DB error -> 500
  </behavior>
  <action>
    **Mocking pattern** (same as established in orgs/route.test.ts from 07-02):
    ```typescript
    const mockGetUser = vi.fn();
    const mockFrom = vi.fn();
    vi.mock('@/lib/supabase/server', () => ({
      createClient: vi.fn().mockResolvedValue({
        auth: { getUser: mockGetUser },
        from: mockFrom,
      }),
    }));
    ```

    **IMPORTANT about route params:** These routes use Next.js 15 async params pattern. The second argument to the handler is `{ params: Promise<{ orgId: string }> }`. When calling the handler in tests, pass:
    ```typescript
    const context = { params: Promise.resolve({ orgId: 'org-123' }) };
    await DELETE(req, context);
    ```

    **File 1: `frontend/src/app/api/orgs/[orgId]/route.test.ts`**

    DELETE /api/orgs/:orgId tests:
    - Auth guard: mockGetUser returns null user -> 401
    - Not owner: mockFrom('org_members').select().eq().eq().single() returns { data: { role: 'member' } } -> 403
    - Membership not found: .single() returns { data: null } -> 403
    - Success: membership check returns owner, then mockFrom('organisations').delete().eq() returns no error -> 200
    - DB error on delete: .delete().eq() returns error -> 500

    **File 2: `frontend/src/app/api/orgs/[orgId]/units/route.test.ts`**

    GET /api/orgs/:orgId/units:
    - mockFrom('units').select('*').eq('org_id', 'org-123').order('name') returns units -> 200
    - DB error -> 500

    POST /api/orgs/:orgId/units:
    - Body missing id -> 400 "id and name are required"
    - Body missing name -> 400 "id and name are required"
    - Valid body with id, name, phone_id -> mockFrom('units').insert(...).select().single() returns unit -> 201
    - Verify org_id from params is included in insert payload
    - Verify armed defaults to true
    - DB error -> 500

    **File 3: `frontend/src/app/api/orgs/[orgId]/units/[unitId]/route.test.ts`**

    For these routes, params are `{ orgId: string; unitId: string }`:
    ```typescript
    const context = { params: Promise.resolve({ orgId: 'org-123', unitId: 'UNIT_001' }) };
    ```

    GET: mockFrom('units').select('*').eq('id', 'UNIT_001').eq('org_id', 'org-123').single()
    - Success -> 200 with unit
    - Error -> 404

    PUT: mockFrom('units').update({...}).eq('id',...).eq('org_id',...).select().single()
    - Success -> 200 with updated unit
    - Error -> 500

    DELETE: mockFrom('units').delete().eq('id',...).eq('org_id',...)
    - Success -> 200 {success: true}
    - Error -> 500

    **Mock chain for these routes** — all use `.eq()` chaining, so the mock needs to handle 2 consecutive `.eq()` calls. Pattern:
    ```typescript
    mockFrom.mockImplementation(() => ({
      select: vi.fn().mockReturnValue({
        eq: vi.fn().mockReturnValue({
          eq: vi.fn().mockReturnValue({
            single: vi.fn().mockResolvedValue({ data: unitData, error: null }),
          }),
        }),
      }),
    }));
    ```

    Similarly for delete:
    ```typescript
    mockFrom.mockImplementation(() => ({
      delete: vi.fn().mockReturnValue({
        eq: vi.fn().mockReturnValue({
          eq: vi.fn().mockResolvedValue({ error: null }),
        }),
      }),
    }));
    ```

    NOTE: These routes do NOT have auth guards (they rely on RLS policies). So no auth tests needed for units routes. Only the orgs/[orgId] DELETE route has an explicit auth check.
  </action>
  <verify>
    <automated>cd frontend && npx vitest run src/app/api/orgs/\\[orgId\\]/ 2>&1</automated>
  </verify>
  <done>All 3 CRUD route test files pass. Org deletion tested for auth guard, owner-only access, and success/error paths. Unit listing and creation tested for validation and org_id scoping. Single unit GET/PUT/DELETE tested for success and error paths. All routes confirm org_id is used in query filters.</done>
</task>

</tasks>

<verification>
Run full test suite to confirm no regressions and all new tests pass:
```bash
cd frontend && npx vitest run
```

All test files should pass. No existing test should be broken by the new additions.
</verification>

<success_criteria>
- All 4 new test files discovered and pass
- check-access.ts tests verify SEC-05 fail-closed for 3 error patterns
- check-access.ts tests verify structured console.warn logging
- Org deletion route tests verify owner-only access (403 for non-owner)
- Unit CRUD tests verify org_id scoping in all queries
- No existing tests broken
- `npx vitest run` exits 0
</success_criteria>

<output>
After completion, create `.planning/phases/7/07-01-SUMMARY.md`
</output>
