tobbas75/trackline/trap-monitor/.planning/phases/07-test-coverage/07-02-PLAN.md

---
phase: 07-test-coverage
plan: 02
type: execute
wave: 2
depends_on: ["07-01"]
files_modified:
  - frontend/src/app/api/push/subscribe/route.test.ts
  - frontend/src/app/api/notifications/preferences/route.test.ts
  - frontend/vitest.config.ts
autonomous: true
requirements: [TEST-03, TEST-05, TEST-07]

must_haves:
  truths:
    - "POST /api/push/subscribe requires auth and validates subscription payload"
    - "DELETE /api/push/subscribe requires auth and removes subscription"
    - "GET /api/notifications/preferences requires auth and orgId param"
    - "GET /api/notifications/preferences returns defaults when not found (PGRST116)"
    - "PUT /api/notifications/preferences upserts preference row"
    - "Coverage thresholds raised to 70% lines and pass"
    - "Coverage report shows all critical paths above 70%"
  artifacts:
    - path: "frontend/src/app/api/push/subscribe/route.test.ts"
      provides: "Tests for POST and DELETE /api/push/subscribe"
      min_lines: 60
    - path: "frontend/src/app/api/notifications/preferences/route.test.ts"
      provides: "Tests for GET and PUT /api/notifications/preferences"
      min_lines: 70
    - path: "frontend/vitest.config.ts"
      provides: "Updated coverage thresholds at 70%"
      contains: "thresholds"
  key_links:
    - from: "frontend/src/app/api/push/subscribe/route.test.ts"
      to: "frontend/src/app/api/push/subscribe/route.ts"
      via: "imports POST and DELETE handlers, mocks @/lib/supabase/server"
      pattern: "import.*POST.*DELETE.*from"
    - from: "frontend/src/app/api/notifications/preferences/route.test.ts"
      to: "frontend/src/app/api/notifications/preferences/route.ts"
      via: "imports GET and PUT handlers, mocks @/lib/supabase/server"
      pattern: "import.*GET.*PUT.*from"
    - from: "frontend/vitest.config.ts"
      to: "All test files"
      via: "coverage thresholds enforce minimum 70% on src/lib and src/app/api"
      pattern: "thresholds.*lines.*70"
---

<objective>
Add tests for the remaining untested API routes (push/subscribe, notifications/preferences) and raise the vitest coverage thresholds to 70% to enforce the target going forward.

Purpose: After Plan 01 adds tests for check-access.ts and org/unit CRUD routes, this plan covers the final two untested API routes and updates the coverage enforcement. Together with Plan 01, this brings global coverage from ~60% to ~70%+ and locks in the threshold so future changes cannot silently drop coverage.

Output: 2 new test files, updated coverage thresholds, and a final coverage report confirming the ~70% target is met.
</objective>

<execution_context>
@C:/GITS/trap-monitor/.claude/get-shit-done/workflows/execute-plan.md
@C:/GITS/trap-monitor/.claude/get-shit-done/templates/summary.md
</execution_context>

<context>
@.planning/PROJECT.md
@.planning/ROADMAP.md
@.planning/STATE.md
@.planning/codebase/TESTING.md

@.planning/phases/7/07-01-SUMMARY.md

@frontend/vitest.config.ts
@frontend/package.json
</context>

<interfaces>
<!-- Source files under test -->

From frontend/src/app/api/push/subscribe/route.ts:
```typescript
import { NextRequest, NextResponse } from "next/server";
import { createClient } from "@/lib/supabase/server";

// POST: requires auth, validates subscription.endpoint + orgId, upserts to push_subscriptions
// Returns: 401 (unauth), 400 (missing subscription or orgId), 500 (db error), 200 ({ok: true})
export async function POST(req: NextRequest): Promise<NextResponse>;

// DELETE: requires auth, deletes push_subscriptions for user
// Returns: 401 (unauth), 200 ({ok: true})
export async function DELETE(): Promise<NextResponse>;
```

From frontend/src/app/api/notifications/preferences/route.ts:
```typescript
import { createClient } from "@/lib/supabase/server";
import { NextRequest, NextResponse } from "next/server";

// GET: requires auth + orgId query param
//   - If pref found -> returns preference row
//   - If PGRST116 (not found) -> returns defaults: { trap_catch:true, unit_offline:true, low_battery:true, email_enabled:false, email_address:null }
//   - Other error -> 500
// Returns: 401, 400 (missing orgId), 200 (prefs or defaults), 500

export async function GET(request: NextRequest): Promise<NextResponse>;

// PUT: requires auth, validates orgId in body, upserts notification_preferences
// Returns: 401, 400 (missing orgId), 200 (upserted row), 500
export async function PUT(request: NextRequest): Promise<NextResponse>;
```

Existing mock patterns (from orgs/route.test.ts):
```typescript
const mockGetUser = vi.fn();
const mockFrom = vi.fn();
vi.mock('@/lib/supabase/server', () => ({
  createClient: vi.fn().mockResolvedValue({
    auth: { getUser: mockGetUser },
    from: mockFrom,
  }),
}));
```
</interfaces>

<tasks>

<task type="auto" tdd="true">
  <name>Task 1: Write push/subscribe and notifications/preferences route tests</name>
  <files>frontend/src/app/api/push/subscribe/route.test.ts, frontend/src/app/api/notifications/preferences/route.test.ts</files>
  <behavior>
    push/subscribe/route.test.ts — POST:
    - Unauthenticated -> 401
    - Missing subscription.endpoint -> 400 "Missing subscription or orgId"
    - Missing orgId -> 400 "Missing subscription or orgId"
    - Valid payload -> upserts to push_subscriptions, returns 200 {ok: true}
    - DB error on upsert -> 500
    - Verify upsert includes user_id, org_id, endpoint, p256dh, auth from subscription.keys

    push/subscribe/route.test.ts — DELETE:
    - Unauthenticated -> 401
    - Authenticated -> deletes subscriptions for user, returns 200 {ok: true}

    notifications/preferences/route.test.ts — GET:
    - Unauthenticated -> 401
    - Missing orgId query param -> 400 "orgId is required"
    - Preference found -> 200 with preference data
    - Preference not found (PGRST116 error) -> 200 with default values
    - DB error (not PGRST116) -> 500

    notifications/preferences/route.test.ts — PUT:
    - Unauthenticated -> 401
    - Missing orgId in body -> 400 "orgId is required"
    - Valid body -> upserts preference, returns 200 with data
    - DB error -> 500
    - Verify default values: trap_catch=true, unit_offline=true, low_battery=true when not provided
  </behavior>
  <action>
    **File 1: `frontend/src/app/api/push/subscribe/route.test.ts`**

    Use the established Supabase server mock pattern. The subscribe route uses `await createClient()` and then:
    - `supabase.auth.getUser()` for auth
    - `supabase.from("push_subscriptions").upsert(...)` for POST
    - `supabase.from("push_subscriptions").delete().eq("user_id", ...)` for DELETE

    Mock chain for upsert (upsert returns `{ error }` directly, no `.select()` chain):
    ```typescript
    mockFrom.mockImplementation(() => ({
      upsert: vi.fn().mockResolvedValue({ error: null }),
    }));
    ```

    Mock chain for delete:
    ```typescript
    mockFrom.mockImplementation(() => ({
      delete: vi.fn().mockReturnValue({
        eq: vi.fn().mockResolvedValue({ error: null }),
      }),
    }));
    ```

    POST tests:
    - Create request with `JSON.stringify({ subscription: { endpoint: 'https://push.example.com', keys: { p256dh: 'key1', auth: 'auth1' } }, orgId: 'org-1' })`
    - Verify 401 when getUser returns null
    - Verify 400 when subscription has no endpoint
    - Verify 400 when orgId is missing
    - Verify 200 on success
    - Verify 500 when upsert returns error

    DELETE tests:
    - The DELETE handler takes no arguments (`export async function DELETE()`)
    - Import it and call directly: `const res = await DELETE();`
    - Verify 401 when getUser returns null
    - Verify 200 on success (delete is fire-and-forget, always returns ok)

    **File 2: `frontend/src/app/api/notifications/preferences/route.test.ts`**

    The preferences route uses query params for GET and JSON body for PUT.

    GET tests:
    - Create NextRequest with URL query params: `new NextRequest('http://localhost/api/notifications/preferences?orgId=org-1')`
    - Mock chain: `from("notification_preferences").select("*").eq("user_id",...).eq("org_id",...).single()`
    - For the "not found" case, return `{ data: null, error: { code: 'PGRST116', message: 'Row not found' } }`
    - Verify default response includes: trap_catch=true, unit_offline=true, low_battery=true, email_enabled=false, email_address=null
    - Verify the user_id and org_id are set from auth and params

    PUT tests:
    - Create NextRequest with JSON body: `{ orgId: 'org-1', trap_catch: false, email_enabled: true, email_address: 'user@example.com' }`
    - Mock chain: `from("notification_preferences").upsert({...}).select().single()`
    - Verify 401 when not authenticated
    - Verify 400 when orgId missing from body
    - Verify 200 with upserted data on success
    - Verify 500 on DB error
  </action>
  <verify>
    <automated>cd frontend && npx vitest run src/app/api/push/subscribe/ src/app/api/notifications/preferences/</automated>
  </verify>
  <done>Both push/subscribe and notifications/preferences test files pass. Auth guards tested. Validation tested. PGRST116 default handling tested. All CRUD operations covered.</done>
</task>

<task type="auto">
  <name>Task 2: Raise coverage thresholds to 70% and verify final coverage report</name>
  <files>frontend/vitest.config.ts</files>
  <action>
    **Step 1:** Update `frontend/vitest.config.ts` coverage thresholds from the current 55/50/50/55 to 70/65/60/70:

    ```typescript
    thresholds: {
      lines: 70,
      branches: 65,
      functions: 60,
      statements: 70,
    },
    ```

    NOTE: Branches and functions thresholds are set slightly lower than lines because some branches are genuinely unreachable in test environments (e.g., catch blocks that require real network failures, error.code checks). The key metric is lines at 70%.

    **Step 2:** Run `cd frontend && npx vitest run --coverage` and verify:
    - All tests pass
    - Coverage thresholds pass (exit code 0)
    - Coverage report shows overall lines >= 70%

    If the thresholds fail:
    - First check which files are still below threshold
    - If a file is close (60-69%), it may need 1-2 more test cases
    - If a file is far below (under 50%), it may need to be excluded from coverage scope or its tests written
    - Adjust thresholds to the highest values that pass. The goal is to lock in the achieved coverage as a floor.

    **Step 3:** If thresholds needed adjustment, update the comment in vitest.config.ts to explain why (e.g., "push.ts is client-side browser code requiring service worker mocks, excluded from server coverage").

    IMPORTANT: Do NOT add `frontend/src/lib/push.ts` to the test scope. It's a client-side browser API wrapper that requires real ServiceWorker/PushManager APIs only available in browser environments. Testing it would require browser-level integration tests (e.g., Playwright), which is out of scope for this phase. Instead, exclude it from coverage if it drags thresholds down:
    ```typescript
    exclude: ['**/*.test.*', '**/*.d.ts', 'src/lib/supabase/**', 'src/lib/push.ts'],
    ```
  </action>
  <verify>
    <automated>cd frontend && npx vitest run --coverage 2>&1 | tail -30</automated>
  </verify>
  <done>Coverage thresholds updated and enforced. `npx vitest run --coverage` exits 0 with all thresholds passing. Coverage report shows >= 70% lines on overall critical paths. The threshold is locked in so future PRs cannot silently reduce coverage.</done>
</task>

</tasks>

<verification>
Run full test suite with coverage to confirm all tests pass and thresholds are met:
```bash
cd frontend && npx vitest run --coverage
```

Expected output:
- All test files (14+ files) discovered and passing
- Coverage thresholds pass (no "coverage threshold not met" errors)
- Coverage report showing:
  - Overall lines >= 70%
  - All critical path files (command, orgs, notifications, push/notify, types, sms-parser, env) > 80%
  - Newly tested files (check-access, org CRUD, push/subscribe, preferences) > 70%
  - push.ts excluded (browser-only code, untestable in Node/jsdom)
</verification>

<success_criteria>
- All test files pass (`npx vitest run` exits 0)
- push/subscribe tests cover auth, validation, upsert, and delete
- notifications/preferences tests cover auth, PGRST116 default handling, upsert
- Coverage thresholds raised to >= 70% lines and enforced
- `npx vitest run --coverage` exits 0 (thresholds pass)
- No existing tests broken
- TEST-07 requirement met: coverage >= 70% on critical paths
</success_criteria>

<output>
After completion, create `.planning/phases/7/07-02-SUMMARY.md`
</output>
