tobbas75/trackline/trap-monitor/.planning/phases/07-test-coverage/07-CONTEXT.md

# Phase 7: Test Coverage - Context

**Gathered:** 2026-03-24
**Status:** Ready for planning
**Mode:** Auto-generated (infrastructure phase — discuss skipped)

<domain>
## Phase Boundary

Broad automated test coverage (~70% on critical paths). Write remaining tests for uncovered files, raise coverage thresholds.

</domain>

<decisions>
## Implementation Decisions

### Claude's Discretion
All implementation choices are at Claude's discretion — pure infrastructure phase.

</decisions>

<code_context>
## Existing Code Insights

189 tests passing. Vitest configured. 6 uncovered files remain. Coverage at ~60%, target 70%.

</code_context>

<specifics>
## Specific Ideas

No specific requirements — infrastructure phase.

</specifics>

<deferred>
## Deferred Ideas

None — infrastructure phase.

</deferred>
