tobbas75/trackline/trap-monitor/.planning/phases/07-test-coverage/07-VERIFICATION.md

---
phase: 07-test-coverage
verified: 2026-03-29T12:55:00Z
status: passed
score: 7/7 requirements verified
re_verification: false
---

# Phase 7: Test Coverage Verification Report

**Phase Goal:** Broad automated test coverage (~70% on critical paths).
**Verified:** 2026-03-29T12:55:00Z
**Status:** passed
**Re-verification:** No -- initial verification

## Goal Achievement

### Observable Truths

| # | Truth | Status | Evidence |
|---|---|---|---|
| 1 | checkAppAccess returns hasAccess=true when RPC succeeds with access | VERIFIED | check-access.test.ts line 22+, test suite passes |
| 2 | checkAppAccess returns hasAccess=false when portal infra is missing (SEC-05 fail-closed) | VERIFIED | 3 SEC-05 tests covering "check_app_access", "schema cache", "Invalid schema: portal" error patterns |
| 3 | checkAppAccess returns hasAccess=false when RPC returns empty data | VERIFIED | Test present in check-access.test.ts |
| 4 | getUserApps returns array of user app rows from portal schema | VERIFIED | Test present in check-access.test.ts |
| 5 | DELETE /api/orgs/:orgId rejects non-owners with 403 | VERIFIED | orgs/[orgId]/route.test.ts -- 401 unauth, 403 non-owner, 200 owner tests |
| 6 | GET/POST /api/orgs/:orgId/units validates and scopes by org_id | VERIFIED | units/route.test.ts -- 6 tests, 126 lines |
| 7 | GET/PUT/DELETE /api/orgs/:orgId/units/:unitId CRUD operations | VERIFIED | units/[unitId]/route.test.ts -- 6 tests, 158 lines |
| 8 | POST /api/push/subscribe requires auth and validates subscription payload | VERIFIED | push/subscribe/route.test.ts -- 126 lines |
| 9 | DELETE /api/push/subscribe requires auth and removes subscription | VERIFIED | push/subscribe/route.test.ts |
| 10 | GET /api/notifications/preferences returns defaults when not found (PGRST116) | VERIFIED | preferences/route.test.ts -- explicit PGRST116 default test |
| 11 | PUT /api/notifications/preferences upserts preference row | VERIFIED | preferences/route.test.ts -- 180 lines |
| 12 | Coverage thresholds raised to 70% lines and pass | VERIFIED | vitest.config.ts: `lines: 70, branches: 65, functions: 60, statements: 70` -- coverage run exits 0 |
| 13 | Coverage report shows all critical paths above 70% | VERIFIED | Actual: 98.76% lines overall. Lowest file: command/route.ts at 97.14% lines |

**Score:** 13/13 truths verified

### Required Artifacts

| Artifact | Expected | Status | Details |
|---|---|---|---|
| `frontend/src/lib/check-access.test.ts` | Tests for checkAppAccess + getUserApps (min 80 lines) | VERIFIED | 217 lines, imports from check-access.ts, tests SEC-05 fail-closed |
| `frontend/src/app/api/orgs/[orgId]/route.test.ts` | Tests for DELETE org (min 50 lines) | VERIFIED | 121 lines, dynamic import of route handler, tests auth + owner-only |
| `frontend/src/app/api/orgs/[orgId]/units/route.test.ts` | Tests for GET/POST units (min 60 lines) | VERIFIED | 126 lines, tests validation + org_id scoping |
| `frontend/src/app/api/orgs/[orgId]/units/[unitId]/route.test.ts` | Tests for GET/PUT/DELETE single unit (min 70 lines) | VERIFIED | 158 lines, tests all CRUD ops with org_id scoping |
| `frontend/src/app/api/push/subscribe/route.test.ts` | Tests for POST/DELETE subscribe (min 60 lines) | VERIFIED | 126 lines |
| `frontend/src/app/api/notifications/preferences/route.test.ts` | Tests for GET/PUT preferences (min 70 lines) | VERIFIED | 180 lines, PGRST116 default handling tested |
| `frontend/vitest.config.ts` | Coverage thresholds at 70% | VERIFIED | lines: 70, branches: 65, functions: 60, statements: 70 |

### Key Link Verification

| From | To | Via | Status | Details |
|---|----|-----|---|---|
| check-access.test.ts | check-access.ts | `import { checkAppAccess, getUserApps } from './check-access'` | WIRED | Static import, direct function testing |
| orgs/[orgId]/route.test.ts | orgs/[orgId]/route.ts | `await import('./route')` dynamic import | WIRED | Dynamic import for test isolation after vi.mock |
| push/subscribe/route.test.ts | push/subscribe/route.ts | `await import('./route')` dynamic import | WIRED | Same pattern |
| notifications/preferences/route.test.ts | notifications/preferences/route.ts | `await import('./route')` dynamic import | WIRED | Same pattern |
| vitest.config.ts | All test files | `thresholds: { lines: 70 }` enforces minimum | WIRED | Coverage run exits 0, enforced |

Note: Key links in PLANs specified static import patterns (`import.*DELETE.*from`) but actual implementation uses dynamic imports (`await import('./route')`) for proper vi.mock isolation. This is functionally correct and a better pattern for Vitest.

### Behavioral Spot-Checks

| Behavior | Command | Result | Status |
|---|---|---|---|
| All 18 test files pass | `npx vitest run` | 18 passed (18), 235 tests passed | PASS |
| Coverage thresholds met | `npx vitest run --coverage` | Exit 0, 98.76% lines overall | PASS |
| No skipped tests | Grep for `it.skip`/`describe.skip` | No matches | PASS |
| No TODO/stub patterns in tests | Grep for TODO/FIXME/PLACEHOLDER | Only legitimate UI placeholder testing | PASS |

### Requirements Coverage

| Requirement | Source Plan | Description | Status | Evidence |
|---|---|---|---|---|
| TEST-01 | (implicit) | Vitest configured with TypeScript support | SATISFIED | vitest.config.ts has TS support, @vitejs/plugin-react, coverage provider v8, 18 test files running |
| TEST-02 | (implicit) | SMS parsing tests cover all 3 formats + edge cases | SATISFIED | sms-parser.test.ts (276 lines) covers TRAP, HEALTH, ALERT formats with GPS validation, battery, edge cases |
| TEST-03 | 07-01, 07-02 | API route tests cover command, orgs, notifications, push endpoints | SATISFIED | 9 API route test files covering command, orgs, orgs/[orgId], units, units/[unitId], push/notify, push/subscribe, notifications, notifications/preferences |
| TEST-04 | (implicit) | Key component tests cover dashboard sub-components | SATISFIED | OrgSelector.test.tsx, EventList.test.tsx, UnitGrid.test.tsx all present and passing |
| TEST-05 | (implicit) | RLS policy tests verify org isolation | SATISFIED | rls-policies.test.ts (414 lines) verifies org_id scoping on all queries and realtime subscriptions via mock-based approach |
| TEST-06 | (implicit) | Command PIN validation tested (valid, invalid, missing) | SATISFIED | command/route.test.ts has dedicated "PIN validation (TEST-06)" describe block -- tests env sourcing, missing PIN, empty string PIN, PIN format in SMS body |
| TEST-07 | 07-01, 07-02 | Coverage reaches ~70% on critical paths | SATISFIED | 98.76% lines overall (well exceeds 70%). Thresholds enforced in vitest.config.ts at 70% lines |

Note: REQUIREMENTS.md traceability table marks TEST-01, TEST-02, TEST-04, TEST-05, TEST-06 as "Pending" but all have been implemented and pass. The traceability table is stale and should be updated.

### Anti-Patterns Found

| File | Line | Pattern | Severity | Impact |
|---|---|---|---|---|
| (none) | - | - | - | No anti-patterns detected in test files |

No skipped tests, no TODO/FIXME markers, no stub implementations, no empty test bodies found across all 18 test files.

### Human Verification Required

None. All verification was performed programmatically:
- Test suite execution confirms all tests pass (235/235)
- Coverage report confirms thresholds met (98.76% lines)
- File existence and line counts confirm substantive implementations
- Import/wiring checks confirm test files connect to source files

### Gaps Summary

No gaps found. All 7 requirements (TEST-01 through TEST-07) are satisfied by the codebase. The coverage significantly exceeds the 70% target at 98.76% lines on critical paths. All 18 test files pass with 235 total tests.

One housekeeping note: The REQUIREMENTS.md traceability table has TEST-01, TEST-02, TEST-04, TEST-05, TEST-06 marked as "Pending" when they are actually complete. This should be updated to reflect the implemented state.

---

_Verified: 2026-03-29T12:55:00Z_
_Verifier: Claude (gsd-verifier)_
