tobbas75/trackline/trap-monitor/.planning/phases/06-firmware-fixes/06-02-PLAN.md

---
phase: 06-firmware-fixes
plan: 02
type: execute
wave: 2
depends_on: [06-01]
files_modified:
  - firmware/src/main.cpp
autonomous: true
requirements: [FW-03, FW-04]

must_haves:
  truths:
    - "Command received in the final 10 seconds of the listen window extends the window by 10 seconds"
    - "Multiple commands in the grace period each re-extend the deadline"
    - "Grace period has a safety cap at 3x the original window to prevent runaway extension"
    - "Trap interrupt that fires between sleep preparation and esp_deep_sleep_start() is detected and processed"
    - "Deep sleep entry never misses a pending trap trigger on TRAP_TRIGGER_PIN"
  artifacts:
    - path: "firmware/src/main.cpp"
      provides: "Grace period logic in STATE_CMD_LISTEN and atomic trap check in STATE_SLEEP"
      contains: "CMD_LISTEN_GRACE_S"
  key_links:
    - from: "firmware/src/main.cpp (STATE_CMD_LISTEN)"
      to: "firmware/src/config.h"
      via: "CMD_LISTEN_GRACE_S constant controls grace period duration"
      pattern: "CMD_LISTEN_GRACE_S"
    - from: "firmware/src/main.cpp (STATE_CMD_LISTEN)"
      to: "firmware/src/config.h"
      via: "CMD_LISTEN_WINDOW_S controls base listen duration and safety cap (3x)"
      pattern: "CMD_LISTEN_WINDOW_S"
    - from: "firmware/src/main.cpp (STATE_SLEEP)"
      to: "firmware/src/main.cpp (STATE_WAKE_ASSESS)"
      via: "If trap pin is HIGH during sleep prep, state resets to WAKE_ASSESS with WAKE_TRAP reason"
      pattern: "TRAP_TRIGGER_PIN.*HIGH"
---

<objective>
Add command listen window grace period (FW-03) and guard deep sleep entry against concurrent trap interrupt (FW-04).

Purpose: Commands sent to a device near the end of its listen window must not be cut off mid-processing. A trap that fires during the brief window between configuring ext0 wakeup and entering deep sleep must not be missed -- this would mean a trapped animal goes undetected until the next scheduled health check (potentially hours).

Output: Modified main.cpp with deadline-based grace period extension in STATE_CMD_LISTEN and atomic trap pin check in STATE_SLEEP.
</objective>

<execution_context>
@C:/GITS/trap-monitor/.claude/get-shit-done/workflows/execute-plan.md
@C:/GITS/trap-monitor/.claude/get-shit-done/templates/summary.md
</execution_context>

<context>
@.planning/PROJECT.md
@.planning/ROADMAP.md
@.planning/STATE.md
@.planning/phases/6/06-01-SUMMARY.md

@firmware/src/main.cpp
@firmware/src/config.h
@firmware/src/commands.h
@firmware/platformio.ini
</context>

<interfaces>
<!-- Key types and contracts from Plan 01 that this plan depends on -->

From firmware/src/config.h (added by Plan 01):
```cpp
#define CMD_LISTEN_GRACE_S    10    // Extend listen if cmd received in final N seconds
```

From firmware/src/config.h (existing):
```cpp
#define CMD_LISTEN_WINDOW_S   60    // Listen for inbound SMS after TX
#define TRAP_TRIGGER_PIN      4     // Reed switch NC -- interrupt
```

From firmware/src/main.cpp -- enums the executor needs to reference:
```cpp
enum WakeReason { WAKE_TRAP, WAKE_RTC_HEALTH, WAKE_RTC_RETRY, WAKE_BOOT };
enum State {
  STATE_WAKE_ASSESS, STATE_COMPOSE_MSG, STATE_GPS_CHECK,
  STATE_MODEM_INIT, STATE_SEND_MSG, STATE_CMD_LISTEN,
  STATE_MODEM_OFF, STATE_SLEEP
};
```

From firmware/src/main.cpp -- globals the executor needs:
```cpp
WakeReason wakeReason;  // Global -- can be reassigned in STATE_SLEEP
State state;            // Global -- drives the state machine in loop()
```

From firmware/src/main.cpp -- current STATE_CMD_LISTEN (lines 426-461):
```cpp
case STATE_CMD_LISTEN:
{
  Serial.printf("[CMD] Listening for %ds\n", CMD_LISTEN_WINDOW_S);
  unsigned long start = millis();
  while (millis() - start < (CMD_LISTEN_WINDOW_S * 1000UL))
  {
    String inbound = modemCheckIncomingSMS();
    if (inbound.length() > 0)
    {
      Serial.printf("[CMD] Inbound: %s\n", inbound.c_str());
      String response = commandProcess(inbound, cfg, rtc);
      if (response.length() > 0)
      {
        modemSendSMS(cfg.smsNumber, response);
      }
    }
    delay(1000);
  }
  state = STATE_MODEM_OFF;
  break;
}
```

From firmware/src/main.cpp -- current STATE_SLEEP (lines 473-511):
```cpp
case STATE_SLEEP:
{
  storageSaveConfig(cfg);
  uint64_t sleepUs = calculateNextSleep(cfg, rtc);
  Serial.printf("[SLEEP] Going to sleep for %llus\n", sleepUs / 1000000ULL);
  esp_sleep_enable_ext0_wakeup((gpio_num_t)TRAP_TRIGGER_PIN, 1);
  esp_sleep_enable_timer_wakeup(sleepUs);
  gpsPowerOff();
  ledSet(LED_ALL, OFF);
  delay(100);
  esp_deep_sleep_start();
  break;
}
```

From firmware/src/commands.h:
```cpp
String commandProcess(const String &raw, SystemConfig &cfg, RTC_DS3231 &rtc);
// Returns response string (empty if no response needed)
```
</interfaces>

<tasks>

<task type="auto">
  <name>Task 1: Add command listen grace period and atomic deep sleep guard</name>
  <files>firmware/src/main.cpp</files>
  <action>
  **STATE_CMD_LISTEN changes (per FW-03 -- grace period):**

  Replace the current STATE_CMD_LISTEN block with deadline-based logic. The key change: instead of comparing `millis() - start < fixed_window`, track a movable `deadline` variable. When a command is received and fewer than `CMD_LISTEN_GRACE_S` seconds remain, extend the deadline forward.

  New implementation:

  ```cpp
  case STATE_CMD_LISTEN:
  {
    unsigned long startTime = millis();
    unsigned long deadline = startTime + (CMD_LISTEN_WINDOW_S * 1000UL);
    unsigned long maxDuration = CMD_LISTEN_WINDOW_S * 3UL * 1000UL; // Safety cap: 3x base window
    Serial.printf("[CMD] Listening for %ds (grace: %ds, max: %lus)\n",
                  CMD_LISTEN_WINDOW_S, CMD_LISTEN_GRACE_S, maxDuration / 1000UL);

    while (millis() < deadline)
    {
      String inbound = modemCheckIncomingSMS();
      if (inbound.length() > 0)
      {
        Serial.printf("[CMD] Inbound: %s\n", inbound.c_str());
        String response = commandProcess(inbound, cfg, rtc);
        if (response.length() > 0)
        {
          modemSendSMS(cfg.smsNumber, response);
        }

        // Grace period: extend if command arrived near end of window (FW-03)
        unsigned long remaining = deadline - millis();
        unsigned long graceMs = CMD_LISTEN_GRACE_S * 1000UL;
        unsigned long elapsed = millis() - startTime;
        if (remaining < graceMs && elapsed < maxDuration)
        {
          deadline = millis() + graceMs;
          Serial.printf("[CMD] Grace period -- extended listen (%lus elapsed)\n", elapsed / 1000UL);
        }
      }
      delay(1000);
    }
    Serial.println("[CMD] Listen window closed");
    state = STATE_MODEM_OFF;
    break;
  }
  ```

  Key behaviors to ensure:
  - `deadline` starts at `millis() + CMD_LISTEN_WINDOW_S * 1000UL` (60 seconds by default)
  - Grace extension triggers ONLY when: (a) a command was just received, AND (b) `remaining < graceMs`, AND (c) total elapsed time < maxDuration (3x safety cap)
  - Each qualifying command re-extends the deadline to `millis() + graceMs` (10 seconds)
  - The safety cap (`maxDuration = CMD_LISTEN_WINDOW_S * 3UL * 1000UL`) prevents infinite extension if commands keep arriving
  - When no command arrives, the loop exits at the original deadline -- no change in behavior
  - A command received at second 50 (10s remaining, within grace zone) extends deadline to second 60 from that moment
  - A command received at second 30 (30s remaining, outside grace zone) does NOT extend -- remaining > graceMs
  - Serial logging indicates when grace extension occurs and total elapsed time

  **STATE_SLEEP changes (per FW-04 -- atomic trap guard):**

  Replace the current STATE_SLEEP block with an atomic check before entering deep sleep. The race condition: between configuring ext0 wakeup and calling `esp_deep_sleep_start()`, a trap could fire. ext0 wakeup only triggers DURING deep sleep, not before entering it -- the interrupt would be missed until the next scheduled wake (potentially hours).

  Fix: After configuring wake sources and powering down peripherals but immediately before `esp_deep_sleep_start()`, disable CPU interrupts, read the trap trigger pin directly, and if HIGH (trap has fired), abort sleep and re-enter the state machine.

  New implementation:

  ```cpp
  case STATE_SLEEP:
  {
    // Save config (in case commands updated it)
    storageSaveConfig(cfg);

    // Calculate next wake time
    uint64_t sleepUs = calculateNextSleep(cfg, rtc);
    Serial.printf("[SLEEP] Going to sleep for %llus\n", sleepUs / 1000000ULL);

    // Configure wake sources
    esp_sleep_enable_ext0_wakeup((gpio_num_t)TRAP_TRIGGER_PIN, 1); // HIGH = trap fired
    esp_sleep_enable_timer_wakeup(sleepUs);

    // Power down peripherals for deep sleep current savings
    gpsPowerOff();
    ledSet(LED_ALL, OFF);
    delay(100);

    // Atomic trap check before sleep entry (FW-04 fix)
    // Disable interrupts, read pin, decide whether to sleep or re-process.
    // ext0 wakeup only triggers DURING deep sleep -- if the trap fired between
    // configuring ext0 and entering sleep, it would be missed until next
    // scheduled wake (potentially hours).
    portDISABLE_INTERRUPTS();
    bool trapPending = (digitalRead(TRAP_TRIGGER_PIN) == HIGH);
    if (trapPending)
    {
      portENABLE_INTERRUPTS();
      Serial.println("[SLEEP] Trap trigger detected before sleep -- re-processing");
      wakeReason = WAKE_TRAP;
      state = STATE_WAKE_ASSESS;
      break;
    }
    portENABLE_INTERRUPTS();

    esp_deep_sleep_start();
    break; // Never reached
  }
  ```

  Key behaviors to ensure:
  - `portDISABLE_INTERRUPTS()` / `portENABLE_INTERRUPTS()` are FreeRTOS macros available on ESP32. They disable/enable CPU interrupts to create an atomic read section.
  - `digitalRead(TRAP_TRIGGER_PIN)` reads the physical pin state. Reed switch NC (normally closed) -- when trap fires, switch opens, pin goes HIGH.
  - If trap is pending: re-enable interrupts, set `wakeReason = WAKE_TRAP`, set `state = STATE_WAKE_ASSESS`, break. The next `loop()` iteration processes the trap event normally through the full state machine (WAKE_ASSESS -> COMPOSE_MSG -> GPS_CHECK -> MODEM_INIT -> SEND_MSG -> CMD_LISTEN -> MODEM_OFF -> SLEEP).
  - If no trap pending: re-enable interrupts and immediately call `esp_deep_sleep_start()`. The window between re-enable and deep_sleep_start is microseconds, and ext0 is already configured for any trigger during actual sleep.
  - GPS and modem are already powered off before this check. Re-entering WAKE_ASSESS will go through MODEM_INIT again -- this is correct since modem was powered off in STATE_MODEM_OFF.
  - The `break` after `esp_deep_sleep_start()` is never reached (CPU halts) but satisfies the switch statement syntax.
  </action>
  <verify>
    <automated>cd C:/GITS/trap-monitor && pio run --environment esp32s3 2>&1 | tail -30</automated>
  </verify>
  <done>
  - STATE_CMD_LISTEN uses deadline variable instead of fixed window comparison
  - Command received when remaining < CMD_LISTEN_GRACE_S (10s) extends deadline by 10s
  - Multiple commands in grace period each re-extend (deadline keeps moving forward)
  - Safety cap at 3x CMD_LISTEN_WINDOW_S prevents runaway extension
  - STATE_SLEEP atomically checks TRAP_TRIGGER_PIN inside portDISABLE_INTERRUPTS/portENABLE_INTERRUPTS
  - If trap pin HIGH during sleep prep, state transitions to STATE_WAKE_ASSESS with WAKE_TRAP reason
  - Serial output logs grace period extensions and trap detection for field debugging
  - PlatformIO build succeeds with zero errors
  </done>
</task>

</tasks>

<verification>
Run PlatformIO build to confirm all firmware compiles:
```bash
cd C:/GITS/trap-monitor && pio run --environment esp32s3
```

Verify grace period logic exists:
```bash
grep -n "CMD_LISTEN_GRACE_S\|graceMs\|Grace period" firmware/src/main.cpp
```

Verify deadline-based listen window:
```bash
grep -n "deadline\|startTime\|maxDuration" firmware/src/main.cpp
```

Verify atomic sleep guard:
```bash
grep -n "portDISABLE_INTERRUPTS\|trapPending\|portENABLE_INTERRUPTS" firmware/src/main.cpp
```

Verify safety cap:
```bash
grep -n "maxDuration.*3" firmware/src/main.cpp
```

Verify trap re-entry path:
```bash
grep -n "WAKE_TRAP\|STATE_WAKE_ASSESS" firmware/src/main.cpp
```
</verification>

<success_criteria>
- PlatformIO build succeeds with zero errors
- STATE_CMD_LISTEN uses movable deadline instead of fixed start+window comparison
- Grace period extends deadline when: command received AND remaining < CMD_LISTEN_GRACE_S AND elapsed < maxDuration
- Safety cap: maxDuration = CMD_LISTEN_WINDOW_S * 3 * 1000UL (180 seconds with default 60s window)
- STATE_SLEEP reads TRAP_TRIGGER_PIN inside portDISABLE_INTERRUPTS / portENABLE_INTERRUPTS atomic section
- If trap pin HIGH during sleep prep, state transitions to STATE_WAKE_ASSESS with wakeReason = WAKE_TRAP
- Serial logging: "[CMD] Grace period -- extended listen" when extension triggers
- Serial logging: "[SLEEP] Trap trigger detected before sleep -- re-processing" when trap caught
- No changes to STATE_MODEM_OFF, STATE_SEND_MSG, or any other state machine states
</success_criteria>

<output>
After completion, create `.planning/phases/6/06-02-SUMMARY.md`
</output>
