tobbas75/trackline/trap-monitor/.planning/phases/01-security-fixes/01-01-PLAN.md

---
phase: 01-security-fixes
plan: 01
type: execute
wave: 1
depends_on: []
files_modified:
  - frontend/src/app/api/command/route.ts
  - frontend/src/app/api/push/notify/route.ts
  - frontend/src/lib/check-access.ts
  - frontend/src/lib/check-access.test.ts
autonomous: true
requirements: [SEC-01, SEC-02, SEC-03, SEC-04, SEC-05]

must_haves:
  truths:
    - "Command endpoint rejects all requests when DEFAULT_CMD_PIN env var is not set (getServerEnv throws)"
    - "Push notify endpoint rejects all requests when SUPABASE_WEBHOOK_SECRET is not set (getServerEnv throws)"
    - "Command endpoint returns 429 after 10 requests per IP within 60 seconds"
    - "Service role database operations log structured JSON with actor identity and timestamp"
    - "Portal access check returns { hasAccess: false, role: null } when portal.check_app_access() is unavailable"
  artifacts:
    - path: "frontend/src/app/api/command/route.ts"
      provides: "Hardened command endpoint with PIN via getServerEnv, LRU rate limiter, audit logging"
      contains: "getServerEnv"
    - path: "frontend/src/app/api/push/notify/route.ts"
      provides: "Hardened push notify endpoint with mandatory webhook secret via getServerEnv, audit logging"
      contains: "getServerEnv"
    - path: "frontend/src/lib/check-access.ts"
      provides: "Fail-closed portal access check — denies access when portal schema unavailable"
      contains: "hasAccess: false"
    - path: "frontend/src/lib/env.ts"
      provides: "Centralized env validation — getServerEnv() throws if any required var is missing"
      contains: "DEFAULT_CMD_PIN"
    - path: "frontend/src/lib/check-access.test.ts"
      provides: "Unit tests for portal access fail-closed behavior (SEC-05)"
      contains: "accessInfraMissing"
  key_links:
    - from: "frontend/src/app/api/command/route.ts"
      to: "frontend/src/lib/env.ts"
      via: "getServerEnv() call at top of POST handler — throws if DEFAULT_CMD_PIN missing"
      pattern: "getServerEnv\\(\\)"
    - from: "frontend/src/app/api/command/route.ts"
      to: "lru-cache"
      via: "LRUCache import for per-IP rate limiting (500 IPs, 60s TTL, 10 req max)"
      pattern: "import.*LRUCache.*lru-cache"
    - from: "frontend/src/app/api/push/notify/route.ts"
      to: "frontend/src/lib/env.ts"
      via: "getServerEnv() call at top of POST handler — throws if SUPABASE_WEBHOOK_SECRET missing"
      pattern: "getServerEnv\\(\\)"
    - from: "frontend/src/lib/check-access.ts"
      to: "portal.check_app_access RPC"
      via: "fail-closed when RPC unavailable — returns { hasAccess: false, role: null }"
      pattern: "hasAccess: false.*role: null"
---

<objective>
Verify and complete all 5 security fixes (SEC-01 through SEC-05) for the Trap Monitor frontend.

Purpose: The core security hardening code is already implemented in the three target files via a centralized `getServerEnv()` pattern (in `frontend/src/lib/env.ts`) that throws when any required env var is missing, plus LRU-based rate limiting and structured audit logging. What remains is: (1) write missing tests for the portal access fail-closed behavior (SEC-05), (2) run the full test suite to confirm all security behaviors, and (3) perform grep-based anti-pattern verification to ensure no insecure patterns remain.

Output: Complete test coverage for all 5 SEC requirements, verified passing test suite, grep-confirmed absence of insecure patterns.
</objective>

<execution_context>
@C:/GITS/trap-monitor/.claude/get-shit-done/workflows/execute-plan.md
@C:/GITS/trap-monitor/.claude/get-shit-done/templates/summary.md
</execution_context>

<context>
@.planning/PROJECT.md
@.planning/ROADMAP.md
@.planning/STATE.md
@.planning/codebase/CONCERNS.md
@.planning/codebase/CONVENTIONS.md

<interfaces>
<!-- Key types and contracts the executor needs. Extracted from the already-implemented codebase. -->

From frontend/src/lib/env.ts (centralized env validation — the mechanism for SEC-01 and SEC-02):
```typescript
export function validateVars(
  spec: EnvSpec,
  source: Record<string, string | undefined>,
): { validated: Record<string, string>; errors: string[] };

// Server env — throws Error listing all missing vars if any are absent.
// DEFAULT_CMD_PIN, SUPABASE_WEBHOOK_SECRET, TELSTRA_API_TOKEN, etc. are all required.
export function getServerEnv(): ServerEnv;

interface ServerEnv {
  SUPABASE_SERVICE_ROLE_KEY: string;
  TELSTRA_API_TOKEN: string;
  DEFAULT_CMD_PIN: string;
  VAPID_PRIVATE_KEY: string;
  VAPID_EMAIL: string;
  SUPABASE_WEBHOOK_SECRET: string;
}
```

From frontend/src/lib/check-access.ts:
```typescript
export type AppId = "wildtrack" | "fire" | "trap_monitor";
export type AppRole = "viewer" | "member" | "admin";
export interface AppAccess {
  hasAccess: boolean;
  role: AppRole | null;
}
// Returns { hasAccess: false, role: null } when portal infra is missing (SEC-05).
export async function checkAppAccess(supabase: SupabaseClient, appId: AppId): Promise<AppAccess>;
```

From frontend/src/app/api/command/route.ts (already hardened):
```typescript
import { LRUCache } from "lru-cache";
import { getServerEnv, publicEnv } from "@/lib/env";

// Module-scope rate limiter: 500 IPs max, 60s TTL, 10 req/min per IP
const rateLimiter = new LRUCache<string, number[]>({ max: 500, ttl: 60_000 });
function isRateLimited(ip: string): boolean;

// POST handler calls getServerEnv() first (throws if PIN missing = SEC-01),
// then rate limits (SEC-03), then processes command with audit logging (SEC-04).
export async function POST(req: NextRequest): Promise<NextResponse>;
```

From frontend/src/app/api/push/notify/route.ts (already hardened):
```typescript
// POST handler calls getServerEnv() first (throws if webhook secret missing = SEC-02),
// then validates Bearer token, then sends push notifications with audit logging (SEC-04).
export async function POST(req: NextRequest): Promise<NextResponse>;
```
</interfaces>
</context>

<tasks>

<task type="auto" tdd="true">
  <name>Task 1: Write check-access tests for portal fail-closed behavior (SEC-05)</name>
  <files>frontend/src/lib/check-access.test.ts</files>
  <behavior>
    - Test 1: checkAppAccess returns { hasAccess: false, role: null } when RPC error contains "check_app_access" (function not found)
    - Test 2: checkAppAccess returns { hasAccess: false, role: null } when RPC error contains "schema cache" (schema not loaded)
    - Test 3: checkAppAccess returns { hasAccess: false, role: null } when RPC error contains "Invalid schema: portal" (portal schema missing)
    - Test 4: checkAppAccess logs a structured warning (console.warn) with level, msg, app_id, error, and ts when portal infra is missing
    - Test 5: checkAppAccess returns { hasAccess: true } with the correct role when RPC succeeds normally (non-error path)
    - Test 6: checkAppAccess returns { hasAccess: false, role: null } when RPC returns empty data array (no access)
    - Test 7: checkAppAccess returns { hasAccess: false, role: null } when RPC returns a non-infrastructure error (e.g., permission denied)
  </behavior>
  <action>
    Create `frontend/src/lib/check-access.test.ts` with Vitest tests for `checkAppAccess()`.

    **Mock setup:** Create a mock Supabase client with a controllable `.rpc()` method. The mock must match the SupabaseClient interface enough for checkAppAccess to call `supabase.rpc("check_app_access", { target_app_id: appId })`.

    ```typescript
    import { describe, it, expect, vi, beforeEach } from 'vitest';
    import { checkAppAccess } from './check-access';
    import type { SupabaseClient } from '@supabase/supabase-js';

    function createMockSupabase(rpcResult: { data: any; error: any }): SupabaseClient {
      return {
        rpc: vi.fn().mockResolvedValue(rpcResult),
      } as unknown as SupabaseClient;
    }
    ```

    **Infrastructure-missing tests (SEC-05 core):** For each of the three error message patterns (`"check_app_access"`, `"schema cache"`, `"Invalid schema: portal"`), create a test that:
    1. Creates a mock Supabase where `rpc()` returns `{ data: null, error: { message: errorPattern } }`
    2. Calls `checkAppAccess(supabase, "trap_monitor")`
    3. Asserts result is `{ hasAccess: false, role: null }`
    4. Asserts `console.warn` was called with a JSON string containing `portal_access_check_unavailable`

    **Normal success path test:** Mock `rpc()` returning `{ data: [{ has_access: true, user_role: "admin" }], error: null }`. Assert result is `{ hasAccess: true, role: "admin" }`.

    **Empty data test:** Mock `rpc()` returning `{ data: [], error: null }`. Assert result is `{ hasAccess: false, role: null }`.

    **Non-infrastructure error test:** Mock `rpc()` returning `{ data: null, error: { message: "permission denied for table app_access" } }`. Assert result is `{ hasAccess: false, role: null }`. Assert console.warn was NOT called (this is not an infrastructure issue, so no special logging).

    Use `vi.spyOn(console, 'warn')` to verify logging behavior. Reset spies in beforeEach.
  </action>
  <verify>
    <automated>cd C:/GITS/trap-monitor/frontend && npx vitest run src/lib/check-access.test.ts 2>&1 | tail -15</automated>
  </verify>
  <done>
    - check-access.test.ts exists with 7+ tests covering SEC-05 fail-closed behavior
    - All three infrastructure error patterns tested (check_app_access, schema cache, Invalid schema: portal)
    - Console.warn logging verified for infrastructure errors
    - Normal success path, empty data, and non-infrastructure errors all tested
    - All tests pass
  </done>
</task>

<task type="auto">
  <name>Task 2: Run full security test suite and perform anti-pattern verification (SEC-01 through SEC-05)</name>
  <files>frontend/src/app/api/command/route.ts, frontend/src/app/api/push/notify/route.ts, frontend/src/lib/check-access.ts</files>
  <action>
    This is a verification-only task. No code changes are needed — all security fixes are already implemented. The executor must confirm the fixes are correct by running tests and performing grep-based anti-pattern checks.

    **Step 1: Run all security-related tests.**
    ```bash
    cd frontend && npx vitest run src/app/api/command/route.test.ts src/app/api/push/notify/route.test.ts src/lib/check-access.test.ts
    ```
    All tests must pass. Expected test counts:
    - command/route.test.ts: 20 tests (including PIN validation, rate limiting, audit logging)
    - push/notify/route.test.ts: 9 tests (including auth rejection, payload validation)
    - check-access.test.ts: 7+ tests (from Task 1)

    **Step 2: Grep anti-pattern checks.** Run these commands and verify the expected outcomes:

    SEC-01 — No "0000" fallback PIN in command route:
    ```bash
    grep -n "0000" frontend/src/app/api/command/route.ts
    # Expected: zero matches
    ```

    SEC-01 — PIN sourced from getServerEnv, not process.env directly:
    ```bash
    grep -n "getServerEnv" frontend/src/app/api/command/route.ts
    # Expected: at least 1 match (the getServerEnv() call)
    ```

    SEC-02 — No conditional `if (secret)` pattern in push/notify route:
    ```bash
    grep -n "if (secret)" frontend/src/app/api/push/notify/route.ts
    # Expected: zero matches
    ```

    SEC-02 — Webhook secret sourced from getServerEnv:
    ```bash
    grep -n "getServerEnv" frontend/src/app/api/push/notify/route.ts
    # Expected: at least 1 match
    ```

    SEC-03 — LRU rate limiter present:
    ```bash
    grep -n "LRUCache" frontend/src/app/api/command/route.ts
    # Expected: 2 matches (import + instantiation)
    grep -c "lru-cache" frontend/package.json
    # Expected: 1
    ```

    SEC-04 — Audit logging present in both endpoints:
    ```bash
    grep -n "command_dispatched" frontend/src/app/api/command/route.ts
    # Expected: 1 match
    grep -n "push_notifications_sent" frontend/src/app/api/push/notify/route.ts
    # Expected: 1 match
    ```

    SEC-05 — No `hasAccess: true` in the accessInfraMissing branch of check-access:
    ```bash
    grep -n "hasAccess: true" frontend/src/lib/check-access.ts
    # Expected: zero matches (the success path uses data[0].has_access, not a literal)
    ```

    SEC-05 — Fail-closed return in accessInfraMissing branch:
    ```bash
    grep -A1 "accessInfraMissing" frontend/src/lib/check-access.ts
    # Expected: the block should contain "hasAccess: false, role: null"
    ```

    **Step 3: TypeScript compilation check.**
    ```bash
    cd frontend && npx tsc --noEmit 2>&1 | grep -E "(command/route|push/notify|check-access|lib/env)" | head -10
    # Expected: zero errors in the security files
    ```

    If ANY grep check fails or ANY test fails, the executor must investigate and fix the issue before proceeding. The fix should be minimal and targeted — do not rewrite working code.
  </action>
  <verify>
    <automated>cd C:/GITS/trap-monitor/frontend && npx vitest run src/app/api/command/route.test.ts src/app/api/push/notify/route.test.ts src/lib/check-access.test.ts 2>&1 | tail -10</automated>
  </verify>
  <done>
    - All 36+ security tests pass (20 command + 9 push + 7 check-access)
    - No "0000" PIN fallback anywhere in command/route.ts
    - No conditional `if (secret)` in push/notify/route.ts
    - No `hasAccess: true` in the accessInfraMissing branch of check-access.ts
    - LRU rate limiter present in command/route.ts and lru-cache in package.json
    - Structured audit logs present in both command and push endpoints
    - TypeScript compiles cleanly for all security files
  </done>
</task>

</tasks>

<verification>
After both tasks complete, the full security posture is confirmed:

1. **SEC-01 (PIN guard):** `getServerEnv()` in env.ts requires `DEFAULT_CMD_PIN`. If missing, it throws — the POST handler in command/route.ts never reaches command processing. Verified by: route.test.ts PIN validation tests (6 tests) + grep confirming no "0000" fallback.

2. **SEC-02 (Webhook secret):** `getServerEnv()` requires `SUPABASE_WEBHOOK_SECRET`. If missing, it throws — the POST handler in push/notify/route.ts never reaches notification processing. The Bearer token comparison is unconditional (no `if (secret)` pattern). Verified by: route.test.ts auth tests (2 tests) + grep confirming no conditional secret check.

3. **SEC-03 (Rate limiting):** LRUCache at module scope in command/route.ts tracks per-IP request timestamps. 10 req/60s limit, 500 IP capacity, auto-eviction via TTL. Verified by: route.test.ts rate limiting tests (2 tests) + grep confirming LRUCache import and lru-cache dependency.

4. **SEC-04 (Audit logging):** Both command/route.ts and push/notify/route.ts emit structured JSON logs with `actor`, `unit_id`/`org_id`, and `ts` fields. Command log insert failures are also logged (ERR-01 bonus). Verified by: grep confirming "command_dispatched" and "push_notifications_sent" log messages.

5. **SEC-05 (Portal fail-closed):** check-access.ts detects three infrastructure error patterns and returns `{ hasAccess: false, role: null }` with a console.warn. No `hasAccess: true` in the error path. Verified by: check-access.test.ts (7 tests) + grep confirming no `hasAccess: true` literal in the file.
</verification>

<success_criteria>
- All 5 SEC requirements verified (SEC-01 through SEC-05)
- 36+ tests passing across 3 test files
- Zero insecure anti-patterns found by grep checks
- TypeScript compiles cleanly for all security files
- check-access.test.ts created with comprehensive portal fail-closed tests
</success_criteria>

<output>
After completion, create `.planning/phases/1/01-01-SUMMARY.md`
</output>
