tobbas75/trackline/trap-monitor/.planning/phases/01-security-fixes/01-01-SUMMARY.md

---
phase: 01-security-fixes
plan: 01
subsystem: security
tags: [getServerEnv, lru-cache, rate-limiting, fail-closed, portal-access, audit-logging, vitest]

# Dependency graph
requires: []
provides:
  - "SEC-01: Command endpoint PIN guard via getServerEnv() — rejects when DEFAULT_CMD_PIN missing"
  - "SEC-02: Push notify webhook secret via getServerEnv() — rejects when SUPABASE_WEBHOOK_SECRET missing"
  - "SEC-03: Per-IP rate limiting on /api/command (LRU, 10 req/60s)"
  - "SEC-04: Structured audit logging on command and push endpoints"
  - "SEC-05: Portal access fail-closed — denies access when portal schema unavailable"
  - "check-access.test.ts: 7 tests verifying SEC-05 fail-closed behavior"
affects: [07-test-coverage]

# Tech tracking
tech-stack:
  added: []
  patterns: [fail-closed-access-control, centralized-env-validation, lru-rate-limiting, structured-audit-logging]

key-files:
  created:
    - "frontend/src/lib/check-access.test.ts"
  modified: []

key-decisions:
  - "All 5 SEC fixes were already implemented; plan focused on test coverage and verification"
  - "Used vi.spyOn(console, 'warn') with afterEach restore to verify structured logging per test"
  - "Tests cover all 3 infrastructure error patterns plus success, empty data, and non-infra error paths"

patterns-established:
  - "Mock Supabase RPC pattern: createMockSupabase() factory returning controllable rpc() responses"
  - "Console spy pattern: vi.spyOn + afterEach restore for verifying structured logging"

requirements-completed: [SEC-01, SEC-02, SEC-03, SEC-04, SEC-05]

# Metrics
duration: 2min
completed: 2026-03-24
---

# Phase 1 Plan 1: Security Fixes Summary

**All 5 security holes closed: getServerEnv() fail-closed PIN/secret guards, LRU rate limiting, structured audit logging, and portal access fail-closed with 36 tests passing**

## Performance

- **Duration:** 2 min
- **Started:** 2026-03-24T12:36:21Z
- **Completed:** 2026-03-24T12:38:38Z
- **Tasks:** 2
- **Files modified:** 1 (created check-access.test.ts)

## Accomplishments
- Created 7 comprehensive tests for SEC-05 portal access fail-closed behavior
- Verified all 36 security tests pass across 3 test files (20 command + 9 push + 7 check-access)
- Confirmed zero insecure anti-patterns via grep checks (no "0000" fallback, no conditional secret, no hasAccess: true literal in error path)
- TypeScript compiles cleanly for all security files

## Task Commits

Each task was committed atomically:

1. **Task 1: Write check-access tests for portal fail-closed behavior (SEC-05)** - `82f640e` (test)
2. **Task 2: Run full security test suite and anti-pattern verification** - No commit (verification only, no code changes)

## Files Created/Modified
- `frontend/src/lib/check-access.test.ts` - 7 tests verifying SEC-05 fail-closed behavior across all infrastructure error patterns, success path, empty data, and non-infrastructure errors

## Decisions Made
- All 5 SEC fixes were already implemented in the codebase; this plan's value was adding missing test coverage and performing systematic verification
- Used afterEach(vi.restoreAllMocks) to ensure console.warn spy counts are accurate per test (fixed accumulation issue during TDD RED phase)

## Deviations from Plan

None - plan executed exactly as written.

## Issues Encountered
- Initial test run had 4 failures due to console.warn spy accumulating across tests (beforeEach created spy but no afterEach cleanup). Fixed by adding afterEach with vi.restoreAllMocks(). This was caught and resolved during the TDD GREEN phase.

## User Setup Required

None - no external service configuration required.

## Next Phase Readiness
- All 5 SEC requirements are verified and complete
- Security test suite provides regression protection for future changes
- No blockers for subsequent phases

## Self-Check: PASSED

- FOUND: frontend/src/lib/check-access.test.ts
- FOUND: .planning/phases/01-security-fixes/01-01-SUMMARY.md
- FOUND: commit 82f640e

---
*Phase: 01-security-fixes*
*Completed: 2026-03-24*
