tobbas75/trackline/trap-monitor/.planning/phases/01-security-fixes/01-CONTEXT.md

# Phase 1: Security Fixes - Context

**Gathered:** 2026-03-24
**Status:** Ready for planning
**Mode:** Auto-generated (infrastructure phase — discuss skipped)

<domain>
## Phase Boundary

Close all 5 security vulnerabilities identified in CONCERNS.md. Harden command endpoint, push/notify endpoint, and portal access check.

</domain>

<decisions>
## Implementation Decisions

### Claude's Discretion
All implementation choices are at Claude's discretion — pure infrastructure phase. Use ROADMAP phase goal, success criteria, and codebase conventions to guide decisions.

</decisions>

<code_context>
## Existing Code Insights

Codebase context gathered during plan-phase research. All 5 fixes already implemented in WIP commit.

</code_context>

<specifics>
## Specific Ideas

No specific requirements — infrastructure phase.

</specifics>

<deferred>
## Deferred Ideas

None — infrastructure phase.

</deferred>
