tobbas75/trackline/trap-monitor/.planning/phases/06-firmware-fixes/06-01-PLAN.md

---
phase: 06-firmware-fixes
plan: 01
type: execute
wave: 1
depends_on: []
files_modified:
  - firmware/src/config.h
  - firmware/src/messages.h
  - firmware/src/storage.h
  - firmware/src/gps.h
autonomous: true
requirements: [FW-01, FW-02]

must_haves:
  truths:
    - "ALERT messages are always dequeued and sent before TRAP and HEALTH messages"
    - "Queue overflow drops lowest-priority messages first, not oldest"
    - "GPS fix obtained during the acquisition window is accepted even if last NMEA sentence is older than 2 seconds"
    - "GPS acquisition loop does not reject valid fixes due to inter-sentence delay"
  artifacts:
    - path: "firmware/src/config.h"
      provides: "MSG_PRIORITY_ALERT, MSG_PRIORITY_TRAP, MSG_PRIORITY_HEALTH constants and CMD_LISTEN_GRACE_S constant"
      contains: "MSG_PRIORITY_ALERT"
    - path: "firmware/src/messages.h"
      provides: "priority field on EventMessage struct and msgPriorityFromType helper"
      contains: "int priority"
    - path: "firmware/src/storage.h"
      provides: "Priority-sorted dequeue, priority-aware overflow eviction, priority in serialization"
      contains: "bestPri"
    - path: "firmware/src/gps.h"
      provides: "Fixed GPS validation using isValid() plus isUpdated() instead of age() < 2000"
      contains: "isUpdated"
  key_links:
    - from: "firmware/src/messages.h"
      to: "firmware/src/storage.h"
      via: "EventMessage.priority field used in dequeue priority scan and overflow eviction"
      pattern: "msg\\.priority"
    - from: "firmware/src/config.h"
      to: "firmware/src/messages.h"
      via: "Priority constants used in msgPriorityFromType and compose functions"
      pattern: "MSG_PRIORITY_"
    - from: "firmware/src/storage.h"
      to: "firmware/src/config.h"
      via: "MAX_QUEUE_SIZE and priority constants used in overflow eviction logic"
      pattern: "MSG_PRIORITY_"
---

<objective>
Implement priority-based retry queue (FW-01) and fix GPS stale timeout mismatch (FW-02).

Purpose: ALERT messages (critical battery, sensor threshold breaches) must never be dropped in favor of routine HEALTH checks. GPS fixes must not be falsely rejected during the acquisition window due to a 2-second NMEA sentence age check that is incompatible with the 300-second acquisition timeout.

Output: Modified storage.h with priority-aware dequeue and eviction, fixed gps.h validation, updated messages.h with priority field and helper, new constants in config.h.
</objective>

<execution_context>
@C:/GITS/trap-monitor/.claude/get-shit-done/workflows/execute-plan.md
@C:/GITS/trap-monitor/.claude/get-shit-done/templates/summary.md
</execution_context>

<context>
@.planning/PROJECT.md
@.planning/ROADMAP.md
@.planning/STATE.md

@firmware/src/config.h
@firmware/src/messages.h
@firmware/src/storage.h
@firmware/src/gps.h
@firmware/src/main.cpp
@firmware/platformio.ini
</context>

<interfaces>
<!-- Key types and contracts the executor needs. Extracted from codebase. -->

From firmware/src/messages.h (current EventMessage — needs priority field added):
```cpp
struct EventMessage {
  String type;       // "TRAP", "HEALTH", "ALERT"
  String unitId;
  String timestamp;
  int retryAttempts = 0;
  // priority field goes here
  bool trapCaught = false;
  bool hasGPS = false;
  bool gpsStale = false;
  bool forceGPS = false;
  float lat = 0.0;
  float lng = 0.0;
  int battPct = -1;
  bool solarOk = true;
  int rssi = 0;
  String fwVersion = FW_VERSION;
  bool addLowBattWarning = false;
  String sensorSuffix;
};
```

From firmware/src/storage.h — functions that need priority awareness:
```cpp
void storageEnqueue(const EventMessage &msg);        // overflow eviction needs priority
EventMessage storageDequeueNext();                    // must return highest-priority entry
void storageFlushQueue(const SystemConfig &cfg);      // must process in priority order
void storageSerializeMessage(JsonObject, const EventMessage &);   // needs "pri" field
EventMessage storageDeserializeMessage(JsonObjectConst);          // needs "pri" deserialization
```

From firmware/src/gps.h — the problematic validation:
```cpp
// Line 47 currently: if (_gps.location.isValid() && _gps.location.age() < 2000)
// This rejects valid fixes when inter-NMEA-sentence gap > 2s during cold start
```

From firmware/src/config.h — relevant constants:
```cpp
#define MAX_QUEUE_SIZE        50
#define GPS_TIMEOUT_S         300   // 5 min acquisition window
#define CMD_LISTEN_WINDOW_S   60    // Listen for inbound SMS after TX
```
</interfaces>

<tasks>

<task type="auto">
  <name>Task 1: Add priority constants, EventMessage priority field, and helper function</name>
  <files>firmware/src/config.h, firmware/src/messages.h</files>
  <action>
  **config.h changes (per FW-01):**

  1. Add message priority constants after the existing `MAX_QUEUE_SIZE` define (around line 147). Use lower number = higher priority:

  ```cpp
  // -- Message Priority (lower = higher priority) -----
  #define MSG_PRIORITY_ALERT    0              // Critical -- always sent first
  #define MSG_PRIORITY_TRAP     1              // Trap trigger -- high importance
  #define MSG_PRIORITY_HEALTH   2              // Routine health check -- lowest
  ```

  2. Add the grace period constant needed by Plan 02 (per FW-03) after `CMD_LISTEN_WINDOW_S` (line 24). This avoids a second config.h edit later:

  ```cpp
  #define CMD_LISTEN_GRACE_S    10             // Extend listen if cmd received in final N seconds
  ```

  **messages.h changes (per FW-01):**

  1. Add `int priority = MSG_PRIORITY_HEALTH;` field to EventMessage struct, after `int retryAttempts = 0;` (line 27).

  2. Add a helper function that derives priority from type string, placed before the compose functions:

  ```cpp
  inline int msgPriorityFromType(const String &type) {
    if (type == "ALERT") return MSG_PRIORITY_ALERT;
    if (type == "TRAP")  return MSG_PRIORITY_TRAP;
    return MSG_PRIORITY_HEALTH;
  }
  ```

  3. In `composeTrapAlert()`: after setting `msg.type = "TRAP"`, add `msg.priority = msgPriorityFromType(msg.type);`

  4. In `composeHealthCheck()`: after setting `msg.type = "HEALTH"`, add `msg.priority = msgPriorityFromType(msg.type);`

  5. In `composeLastGasp()`: after setting `msg.type = "ALERT"`, add `msg.priority = msgPriorityFromType(msg.type);`

  The `msgPriorityFromType` helper also ensures that any EventMessage created elsewhere (e.g., the sensor alert in main.cpp's STATE_COMPOSE_MSG which sets `alertMsg.type = "ALERT"`) can derive its priority if the caller uses the helper. The storageDeserializeMessage fallback (Task 2) also uses this helper for legacy queue entries that lack the priority field.
  </action>
  <verify>
    <automated>cd C:/GITS/trap-monitor && pio run --environment esp32s3 2>&1 | tail -30</automated>
  </verify>
  <done>EventMessage has `int priority` field defaulting to MSG_PRIORITY_HEALTH. All three compose functions set priority via msgPriorityFromType. Priority constants MSG_PRIORITY_ALERT=0, MSG_PRIORITY_TRAP=1, MSG_PRIORITY_HEALTH=2 defined in config.h. CMD_LISTEN_GRACE_S=10 defined in config.h. PlatformIO compiles without errors.</done>
</task>

<task type="auto">
  <name>Task 2: Implement priority-aware queue operations and fix GPS stale validation</name>
  <files>firmware/src/storage.h, firmware/src/gps.h</files>
  <action>
  **storage.h changes (per FW-01 -- priority queue):**

  The approach: keep append-at-end enqueue but change dequeue and flush to scan for highest priority. This avoids ArduinoJson array insertion complexity on embedded.

  1. **storageSerializeMessage()** -- Add priority to JSON serialization. Add after existing fields:
     ```cpp
     entry["pri"] = msg.priority;
     ```

  2. **storageDeserializeMessage()** -- Add priority deserialization with fallback for legacy entries. Use ArduinoJson's `|` (or) operator:
     ```cpp
     msg.priority = entry["pri"] | msgPriorityFromType(msg.type);
     ```
     This handles queue entries persisted before the priority field existed by deriving priority from the type string.

  3. **storageEnqueue() overflow eviction** -- Replace the current `while (queue.size() >= MAX_QUEUE_SIZE) { queue.remove(0); }` FIFO eviction with priority-aware eviction. When the queue is full, find and remove the lowest-priority entry (highest `pri` value). If multiple entries share the lowest priority, evict the oldest (lowest index):

     ```cpp
     while (queue.size() >= MAX_QUEUE_SIZE)
     {
       int evictIdx = 0;
       int lowestPri = queue[0]["pri"] | MSG_PRIORITY_HEALTH;
       for (int i = 1; i < (int)queue.size(); i++)
       {
         int p = queue[i]["pri"] | MSG_PRIORITY_HEALTH;
         if (p > lowestPri)
         {
           lowestPri = p;
           evictIdx = i;
         }
         // If tied, keep evictIdx as-is (older = lower index = evict first among ties)
       }
       Serial.printf("[QUEUE] Overflow -- evicting idx=%d pri=%d\n", evictIdx, lowestPri);
       queue.remove(evictIdx);
     }
     ```

  4. **storageDequeueNext()** -- Replace taking `queue[0]` with a priority scan. Find the highest-priority entry (lowest `pri` value). If tied, take the oldest (lowest index):

     ```cpp
     int bestIdx = 0;
     int bestPri = queue[0]["pri"] | MSG_PRIORITY_HEALTH;
     for (int i = 1; i < (int)queue.size(); i++)
     {
       int p = queue[i]["pri"] | MSG_PRIORITY_HEALTH;
       if (p < bestPri)
       {
         bestPri = p;
         bestIdx = i;
       }
       // If tied, keep bestIdx (lower index = older = dequeue first)
     }
     JsonObjectConst entry = queue[bestIdx].as<JsonObjectConst>();
     msg = storageDeserializeMessage(entry);
     queue.remove(bestIdx);
     ```

     Add a MARKER log after deserialization:
     ```cpp
     Serial.printf("[MARKER][QUEUE] Dequeued type=%s pri=%d retries=%d\n",
                   msg.type.c_str(), msg.priority, msg.retryAttempts);
     ```

  5. **storageFlushQueue()** -- Change from sequential `queue[0]` processing to priority-order. Replace the `while (queue.size() > 0)` body:
     - Find highest-priority entry using the same scan pattern as dequeueNext
     - Deserialize that entry, format SMS, attempt send
     - On success: remove the entry, increment sentCount, delay(2000) for throttle
     - On failure: increment retryAttempts, check against retryLimit. If exceeded, remove and log drop. If not exceeded, update the entry in-place (clear JsonObject, re-serialize). Log failure and break (stop flush).

     Add MARKER log for flush failures:
     ```cpp
     Serial.printf("[MARKER][QUEUE] Flush fail type=%s pri=%d retries=%d/%d\n",
                   msg.type.c_str(), msg.priority, msg.retryAttempts, retryLimit);
     ```

  **gps.h changes (per FW-02 -- fix stale timeout):**

  Replace the GPS validation condition. The current check `_gps.location.age() < 2000` rejects valid fixes during cold start when inter-NMEA-sentence gaps exceed 2 seconds (common with u-blox M10 during first fix).

  Replace:
  ```cpp
  if (_gps.location.isValid() && _gps.location.age() < 2000) {
  ```

  With:
  ```cpp
  if (_gps.location.isValid() && _gps.location.isUpdated()) {
  ```

  `isUpdated()` returns true if the location was decoded from the most recent NMEA sentence, which precisely captures "we just got a new fix" without an arbitrary time window. Since we are in an active serial read loop, this will be true on the iteration immediately after a GGA/RMC sentence containing coordinates is decoded.

  Add an explanatory comment above the condition:
  ```cpp
  // isUpdated() = location was decoded in the latest NMEA sentence.
  // Previous age() < 2000 check rejected valid fixes during cold-start
  // inter-sentence gaps (FW-02 fix).
  ```
  </action>
  <verify>
    <automated>cd C:/GITS/trap-monitor && pio run --environment esp32s3 2>&1 | tail -30</automated>
  </verify>
  <done>
  - Queue overflow evicts lowest-priority messages (HEALTH before TRAP before ALERT)
  - storageDequeueNext() returns the highest-priority message (ALERT first, then TRAP, then HEALTH); ties broken by age (oldest first)
  - storageFlushQueue() sends messages in priority order
  - GPS validation uses isUpdated() instead of age() < 2000 -- no false stale rejections during acquisition
  - Priority field serialized as "pri" in queue JSON for persistence across reboots
  - Legacy queue entries without "pri" field fall back to msgPriorityFromType()
  - PlatformIO build succeeds with zero errors
  </done>
</task>

</tasks>

<verification>
Run PlatformIO build to confirm all firmware compiles:
```bash
cd C:/GITS/trap-monitor && pio run --environment esp32s3
```

Verify priority constants are defined:
```bash
grep -n "MSG_PRIORITY_" firmware/src/config.h
```

Verify priority field and helper in messages.h:
```bash
grep -n "priority\|msgPriorityFromType" firmware/src/messages.h
```

Verify GPS fix uses isUpdated:
```bash
grep -n "isUpdated" firmware/src/gps.h
```

Verify priority-aware dequeue:
```bash
grep -n "bestPri\|bestIdx" firmware/src/storage.h
```

Verify priority-aware overflow eviction:
```bash
grep -n "evictIdx\|lowestPri" firmware/src/storage.h
```

Verify priority serialization:
```bash
grep -n '"pri"' firmware/src/storage.h
```
</verification>

<success_criteria>
- PlatformIO build succeeds with zero errors
- EventMessage struct has `int priority` field defaulting to MSG_PRIORITY_HEALTH
- All three compose functions (composeTrapAlert, composeHealthCheck, composeLastGasp) set priority via msgPriorityFromType
- msgPriorityFromType helper maps "ALERT"->0, "TRAP"->1, default->2
- storageEnqueue overflow evicts lowest-priority messages (highest pri number)
- storageDequeueNext returns highest-priority message (lowest pri number)
- storageFlushQueue processes in priority order
- GPS gpsGetFix uses isUpdated() instead of age() < 2000
- CMD_LISTEN_GRACE_S constant defined in config.h for Plan 02
- Priority field serialized as "pri" in queue JSON
- Legacy queue entries fall back to type-based priority derivation
</success_criteria>

<output>
After completion, create `.planning/phases/6/06-01-SUMMARY.md`
</output>
