tobbas75/trackline/trap-monitor/.planning/phases/06-firmware-fixes/06-CONTEXT.md

# Phase 6: Firmware Fixes - Context

**Gathered:** 2026-03-24
**Status:** Ready for planning
**Mode:** Auto-generated (infrastructure phase — discuss skipped)

<domain>
## Phase Boundary

Fix all 4 firmware edge cases: priority retry queue, GPS stale check, command listen grace period, deep sleep race guard.

</domain>

<decisions>
## Implementation Decisions

### Claude's Discretion
All implementation choices are at Claude's discretion — pure infrastructure phase.

</decisions>

<code_context>
## Existing Code Insights

Implementations likely exist in WIP commit. Plans verify correctness and document.

</code_context>

<specifics>
## Specific Ideas

No specific requirements — infrastructure phase.

</specifics>

<deferred>
## Deferred Ideas

None — infrastructure phase.

</deferred>
