tobbas75/trackline/(list of files, drawings)

Other design files:
trap-monitor/hardware/Trap Monitor/PCB FILES/ProPrj_IoT Animal Trap_2026-03-28 1.epro
