tobbas75/trackline/trap-monitor/firmware/src/config.h

#pragma once
#define DEFAULT_UNIT_ID       "TRAP_001"
#define DEFAULT_CMD_PIN       "0000"           // CHANGE ON FIRST SETUP
#define DEFAULT_SMS_NUMBER    "+61400000000"   // Primary alert recipient
#define DEFAULT_API_ENDPOINT  ""               // Optional HTTP POST endpoint
#define GPS_MOVE_THRESHOLD_M  50.0f            // Metres before GPS is included
#define HEALTH_HOUR           6                // Daily health check hour (local)
#define HEALTH_MINUTE         0
#define LOW_BATT_THRESHOLD    20               // % battery — triggers alert SMS
#define CRIT_BATT_THRESHOLD   10              // % — last-gasp attempt then shutdown
#define SMS_RETRY_COUNT       5
#define SMS_RETRY_INTERVAL_S  300              // 5 minutes between retries
#define MODEM_POWER_CYCLES    3               // Before MCU reboot
#define CMD_LISTEN_WINDOW_S   60              // Listen for inbound SMS after TX
#define CMD_LISTEN_GRACE_S    10              // Extend listen if cmd received in final N seconds
#define GPS_TIMEOUT_S         300             // 5 min GPS fix timeout
#define MODEM_INIT_TIMEOUT_S  60
#define CMD_POLL_INTERVAL_HR  4              // Poll for commands every N hours
#define TRAP_TRIGGER_PIN      4               // Reed switch NC — interrupt
#define SOLAR_ADC_PIN         1               // ADC — solar charge current sense
#define BATT_ADC_PIN          2               // ADC — battery voltage divider
#define LED_GREEN_PIN         38
#define LED_AMBER_PIN         39
#define LED_RED_PIN           40
#define RTC_SDA_PIN           8
#define RTC_SCL_PIN           9
#define MODEM_TX_PIN          17              // ESP32-S3 → EG800Q-EU RXD
#define MODEM_RX_PIN          18              // EG800Q-EU TXD → ESP32-S3
#define MODEM_PWRKEY_PIN      5               // EG800Q-EU PWRKEY (active HIGH pulse)
#define MODEM_RST_PIN         7               // EG800Q-EU RESET_N (active LOW)
#define MODEM_BAUD            115200
#define GPS_TX_PIN            15              // ESP32-S3 → M10 RXD (for config cmds)
#define GPS_RX_PIN            16              // M10 TXD → ESP32-S3
#define GPS_PWR_PIN           6               // M10 VCC enable (GPIO HIGH = powered)
#define GPS_BAUD              9600
#define BATTERY_PACK_A          // LiFePO4 2S 3.2V × 2 = 6.4V nom + solar
  #define BATT_CAPACITY_MAH     6000
  #define BATT_PACK_FULL_MV     7200          // 2S LiFePO4 full: 2 × 3600mV
  #define BATT_PACK_EMPTY_MV    5600          // 2S LiFePO4 cutoff: 2 × 2800mV
  #define BATT_PRIMARY          0             // Rechargeable
#define ADC_VREF_MV             3300
#define ADC_DIVIDER_RATIO       3.128f        // (1MΩ+470kΩ)/470kΩ exact — max 7.2V → 2.30V at ADC
#define ADC_CAL_FACTOR          1.0f          // Per-board calibration multiplier (measure & adjust)
#define MODEM_MODEL           "EG800Q"
#define APN                   "telstra.m2m"   // Telstra LTE APN
#define NETWORK_BAND          28              // 700MHz — critical for AU remote
#define EXP_I2C_SDA_PIN       41            // EXP_I2C (separate bus from RTC)
#define EXP_I2C_SCL_PIN       42
#define EXP_ONEWIRE_PIN       43            // EXP_1WIRE
#define EXP_ANALOG_PIN        10            // EXP_ANALOG (ADC1 CH9)
#define EXP_DIGITAL_1_PIN     11            // EXP_DIGITAL_1 (NC, pull-up 3.3V)
#define EXP_DIGITAL_2_PIN     12            // EXP_DIGITAL_2 (pulse count or NC)
#define EXP_UART_TX_PIN       13            // EXP_UART
#define EXP_UART_RX_PIN       14
#define TEMP_HIGH_THRESHOLD_C 60.0f         // Enclosure overheat warning
#define TEMP_LOW_THRESHOLD_C  5.0f          // Unexpected cold alert
#define SOIL_DRY_THRESHOLD    20            // % — below this = dry alert
#define WATER_LEVEL_LOW_MM    100           // mm — below this = low level alert
#define CONFIG_FILE           "/config.json"
#define QUEUE_FILE            "/queue.json"
#define LOG_FILE              "/events.log"
#define MAX_QUEUE_SIZE        50              // Max unsent messages to store
#define MSG_PRIORITY_ALERT    0              // Critical — always sent first
#define MSG_PRIORITY_TRAP     1              // Trap trigger — high importance
#define MSG_PRIORITY_HEALTH   2              // Routine health check — lowest
#define FW_VERSION "1.0.0"
#define FACTORY_UNIT_ID       DEFAULT_UNIT_ID       // "TRAP_001"
#define FACTORY_SMS_NUMBER    DEFAULT_SMS_NUMBER     // "+61400000000"
#define FACTORY_CMD_PIN       DEFAULT_CMD_PIN        // "0000"
#include <Arduino.h>
struct SystemConfig {
  String unitId          = DEFAULT_UNIT_ID;
  String smsNumber       = DEFAULT_SMS_NUMBER;
  String apiEndpoint     = DEFAULT_API_ENDPOINT;
  String cmdPin          = DEFAULT_CMD_PIN;
  String apn             = APN;
  float  gpsMoveThresholdM = GPS_MOVE_THRESHOLD_M;
  int    healthHour      = HEALTH_HOUR;
  int    healthMinute    = HEALTH_MINUTE;
  int    lowBattThreshold = LOW_BATT_THRESHOLD;
  int    smsRetryCount   = SMS_RETRY_COUNT;
  bool   armed           = true;
};
