tobbas75/trackline/trap-monitor/hardware/Camera Trap/firmware/config.h

#pragma once
#define DEFAULT_UNIT_ID       "CAM_001"
#define FW_VERSION            "0.1.0"
typedef enum {
    MODE_VALIDATION = 0,
    MODE_PRODUCTION = 1,
    MODE_RESEARCH   = 2
} OperatingMode_t;
#define DEFAULT_OPERATING_MODE  MODE_VALIDATION
#define PHASE1_C3_ENABLED             0       // 0 = ESP32-C3 power-gated OFF (PG7 LOW)
#define PHASE1_ANTITHEFT_ENABLED      0       // 0 = LIS2DW12 ignored, U0 skips accel I2C init
#define PHASE1_LORA_ENABLED           0       // 0 = LoRa auto-detect disabled (no backpack module)
#define PHASE1_STOP2_ENABLED          0       // 0 = deep sleep only (~8 µA vs ~112 µA STOP2)
#define PHASE1_VIDEO_CLIP_ENABLED     0       // 0 = burst capture only, no MJPEG video
#define PHASE1_SMS_CONFIG             1       // 1 = accept CONFIG: SMS commands via modem
#define PHASE1_USB_CONFIG             1       // 1 = accept CONFIG: commands via USB serial (workshop)
#define AI_CONFIDENCE_THRESHOLD   0.70f   // Minimum species confidence to flag
#define AI_MEGADETECTOR_THRESHOLD 0.50f   // Minimum MegaDetector animal score
#define BURST_FRAME_COUNT         10      // Frames per trigger burst
#define AI_INFERENCE_FRAMES       3       // Frames to run AI on (2, 5, 8)
#define AI_FRAME_INDICES          {1, 4, 7}  // 0-indexed: frames 2, 5, 8
#define CAPTURE_DAY_WIDTH         3856    // Full 4K
#define CAPTURE_DAY_HEIGHT        2180
#define CAPTURE_NIGHT_WIDTH       1928    // 2×2 binned
#define CAPTURE_NIGHT_HEIGHT      1090
#define CAPTURE_FPS               10      // Target burst frame rate
#define JPEG_QUALITY_FULL         85      // 4K frames to SD
#define JPEG_QUALITY_THUMBNAIL    60      // AI preview / LTE alert thumbnail
#define THUMBNAIL_WIDTH           640
#define THUMBNAIL_HEIGHT          360
#define NIGHT_MODE_AUTO           1       // 1 = auto-detect, 0 = force via config
#define NIGHT_GAIN_THRESHOLD_DB   24.0f   // AE gain above this → night mode
#define DAY_GAIN_THRESHOLD_DB     18.0f   // AE gain below this → day mode (hysteresis)
#define METER_FRAME_EXPOSURE_MS   30      // AE meter frame max integration time
#define NIGHT_GAIN_940NM_STD_DB   30.0f   // Higher — 940nm has lower sensor QE
#define NIGHT_GAIN_940NM_LONG_DB  33.0f   // Highest — longer range, less photon flux
#define NIGHT_GAIN_940NM_SLONG_DB 33.0f   // Same as long range (narrower beam compensates)
#define NIGHT_GAIN_850NM_DB       24.0f   // Lower — better sensor response at 850nm
#define NIGHT_GAIN_WHITE_DB       0.0f    // AE handles it (broadband light)
#define NIGHT_GAIN_BLANK_DB       0.0f    // No illumination — AE only (daytime deploy)
#define DEFAULT_SMS_NUMBER        "+61400000000"  // Primary alert recipient
#define DEFAULT_MQTT_TOPIC        "wildtrack/events"
#define DEFAULT_MQTT_BROKER       ""              // WildTrack backend URL
#define ALERT_ON_SPECIES          1               // Send LTE alert on confirmed species
#define ALERT_INCLUDE_THUMBNAIL   1               // Attach JPEG thumbnail to alert
#define THUMBNAIL_MAX_BYTES       153600           // 150 KB max for LTE transmission
#define PIR_LOCKOUT_S             5       // Minimum seconds between triggers
#define HEALTH_CHECK_HOUR         6       // Daily health report (local time)
#define HEALTH_CHECK_MINUTE       0
#define GPS_TIMEOUT_S             300     // 5 min GPS fix timeout
#define MODEM_INIT_TIMEOUT_S      60
#define LOW_BATT_THRESHOLD_PCT    20
#define CRIT_BATT_THRESHOLD_PCT   10
#define ALERT_RETRY_COUNT         3
#define ALERT_RETRY_INTERVAL_S    300     // 5 minutes between retries
#define MODEM_POWER_CYCLES        3       // Before MCU reboot
#define PIR_WAKE_FROM_U0_PIN      PG3     // STM32U0 → STM32N6 wake signal (EXTI)
#define SENSOR_RESET_PIN          PC8     // IMX678 XCLR (active LOW reset)
#define SENSOR_PWDN_PIN           PD2     // IMX678 power-down (active HIGH)
#define SENSOR_I2C_INSTANCE       1       // I2C1
#define SENSOR_I2C_ADDR           0x1A    // IMX678 7-bit I2C address
#define SENSOR_I2C_SDA_PIN        PC1     // I2C1 SDA (AF4), BSS138 level-shifted (3.3V ↔ 1.8V)
#define SENSOR_I2C_SCL_PIN        PH9     // I2C1 SCL (AF4), BSS138 level-shifted (3.3V ↔ 1.8V)
#define LED_STROBE_PIN            PA8     // TIM1 CH1 output — strobe signal (AF1)
#define LED_STROBE_TIMER          1       // TIM1 (advanced timer for PWM/strobe)
#define LED_STROBE_CHANNEL        1       // Channel 1
#define LED_MODULE_ID_ADC_PIN     PA0     // ADC input — reads module ID resistor
#define LED_MODULE_ID_ADC_CHAN     0       // ADC1 channel 0
#define LED_5V_EN_PIN             PB6     // 5V VLED buck/boost enable (HIGH = on)
#define STROBE_PULSE_MS           30      // Per-frame LED on-time (= exposure)
#define STROBE_ACTIVE_HIGH        1       // HIGH = LEDs on
#define LED_ID_NONE               0       // No module / open circuit (>3.0V, ADC >950)
#define LED_ID_940NM_STANDARD     1       // 8× SFH 4725AS A01 80° PARALLEL (R_ID=10kΩ, ~1.65V, ADC ~500)
#define LED_ID_940NM_LONGRANGE    2       // 4× SFH 4725AS A01 + TIR optics (R_ID=5.6kΩ, ~1.19V, ADC ~359)
#define LED_ID_850NM_RESEARCH     3       // RESERVED — (R_ID=22kΩ, ~2.27V, ADC ~688). Build if research partners request.
#define LED_ID_WHITE_FLASH        4       // 4× Cree XP-G3 45° (R_ID=47kΩ, ~2.72V, ADC ~824). Day + night colour.
#define LED_ID_940NM_SUPER_LONG   6       // RESERVED — (R_ID=2.7kΩ, ~0.70V, ADC ~213). Build if long-range insufficient.
#define LED_ID_BLANK              7       // Blanking plug (R_ID=1.2kΩ, ~0.35V, ADC ~107)
#define MODEM_UART_INSTANCE       4       // UART4
#define MODEM_TX_PIN              PC10    // STM32N6 → modem RXD (UART4 TX, AF8)
#define MODEM_RX_PIN              PC11    // Modem TXD → STM32N6 (UART4 RX, AF8)
#define MODEM_BAUD                115200
#define MODEM_PWRKEY_PIN          PB0     // Active HIGH pulse
#define MODEM_RST_PIN             PB1     // Active LOW reset
#define MODEM_STATUS_PIN          PB2     // Modem status output (HIGH = modem on)
#define MODEM_RI_PIN              PB3     // Ring indicator (EXTI)
#define MODEM_DTR_PIN             PB4     // Data terminal ready
#define MODEM_3V8_EN_PIN          PB7     // AP63300 EN pin (optional sleep gating)
#define MODEM_POWER_SETTLE_MS     100     // Wait after PB7 HIGH before PWRKEY pulse
#define GPS_UART_INSTANCE         3       // USART3
#define GPS_TX_PIN                PD8     // STM32N6 → M10 RXD (USART3 TX, AF7)
#define GPS_RX_PIN                PD9     // M10 TXD → STM32N6 (USART3 RX, AF7)
#define GPS_BAUD                  9600
#define GPS_PWR_PIN               PB5     // Power gate enable (HIGH = powered)
#define PSRAM_SIZE_MB             32
#define PSRAM_PART                "APS256XXN-OBR-BG"  // 32MB, BGA-24, HexaSPI x16 DDR, 1.8V
#define FLASH_CODE_SIZE_MB        16      // W25Q128JV — firmware + models
#define FLASH_LOG_SIZE_MB         32      // W25Q256JV — metadata, config
#define SD_SDMMC_INSTANCE         2       // SDMMC2
#define SD_DETECT_PIN             PN12    // Card detect (active LOW, EXTI)
#define BATT_6S2P_MAH             4000    // 6S2P: 2 parallel × 2000 mAh
#define BATT_ADC_PIN              PA1     // Battery voltage via divider (ADC1 CH1)
#define BATT_ADC_DIVIDER_RATIO    3.0f    // R1=2MΩ, R2=1MΩ. NOT same as Trap Monitor.
#define VDDCORE_VOS_PIN           PF4     // GPIO switches TPS62088 U10a feedback divider
#define LED_STATUS_GREEN_PIN      PG0     // Species confirmed / OK
#define LED_STATUS_AMBER_PIN      PG1     // Processing / warning
#define LED_STATUS_RED_PIN        PG2     // Error / low battery
#define U0_COMM_INTERFACE         1       // SPI1
#define U0_SPI_NSS_PIN            PA4     // SPI1 NSS (GPIO, software chip select)
#define U0_SPI_SCK_PIN            PA5     // SPI1 SCK (AF5)
#define U0_SPI_MISO_PIN           PA6     // SPI1 MISO (AF5) — U0 → N6
#define U0_SPI_MOSI_PIN           PA7     // SPI1 MOSI (AF5) — N6 → U0
#define U0_WAKE_PIN               PG3     // STM32U0 → STM32N6 wake (EXTI rising)
#define U0_STATUS_PIN             PG4     // STM32N6 → STM32U0 busy/done
#define U0_PWRCTRL_PIN            PG5     // STM32U0 controls N6 power enable
#define C3_SPI_INSTANCE           2       // SPI2 (N6 master, C3 slave)
#define C3_SPI_SCK_PIN            PF2     // SPI2 SCK — CubeMX validated (VFBGA-264)
#define C3_SPI_MOSI_PIN           PD7     // SPI2 MOSI — N6 → C3
#define C3_SPI_MISO_PIN           PD6     // SPI2 MISO — C3 → N6
#define C3_SPI_NSS_PIN            PB12    // SPI2 NSS — hardware chip select
#define C3_PWR_EN_PIN             PG7     // Power enable (HIGH = C3 powered, from 3.3V rail)
#define C3_READY_PIN              PG8     // C3 → N6 ready/interrupt (EXTI, active HIGH)
#define C3_SPI_CLOCK_HZ           10000000 // 10 MHz — ESP32-C3 SPI slave max ~10 MHz (f_APB/8)
#define REED_SWITCH_PIN           PG9     // Magnetic reed switch (EXTI, active LOW)
#define TRIG_OUT_PIN              PG6     // TLP291 opto-coupler drive (active HIGH)
#define TRIG_OUT_ACTIVE_HIGH      1
#define TRIG_PULSE_MS             2000    // Default trigger pulse duration
#define TRIG_CONFIDENCE_THRESHOLD 0.70f   // Min confidence to fire trigger
#define TRIG_DUAL_CAMERA_CONFIRM  0       // 0 = single camera, 1 = require LoRa confirmation
#define TRIG_SENSE_PIN_U0         PA3     // STM32U0 EXTI input, active LOW (external trigger)
#define TRIG_INPUT_ENABLED        0       // 0 = ignore external triggers, 1 = wake on contact closure
#define ACCEL_I2C_ADDR            0x19    // LIS2DW12 7-bit address (SDO/SA0 = HIGH/float)
#define ACCEL_INT_PIN_U0          PA2     // STM32U0 EXTI, active HIGH on motion
#define ANTITHEFT_ENABLED         0       // 0 = off, 1 = enabled via BLE settings
#define ANTITHEFT_HEARTBEAT_HOURS 24      // Daily position report interval
#define ANTITHEFT_SMS_FMT         "ALERT: Camera %s moved. Lat: %.6f Lon: %.6f"
#define STOP2_FAST_TRIGGER        0       // 0 = deep sleep (~200ms wake), 1 = STOP2 (~175ms wake)
#define VIDEO_CLIP_ENABLED        0       // 0 = burst only, 1 = 5-sec MJPEG on trigger
#define VIDEO_CLIP_DURATION_S     5
#define VIDEO_CLIP_FPS            15      // 1080p MJPEG at 15fps
#define VIDEO_CLIP_WIDTH          1920
#define VIDEO_CLIP_HEIGHT         1080
#define LORA_UART_INSTANCE        1       // USART1 (via J_BP to Field Station / Li-ion Solar backpack)
#define LORA_UART_TX_PIN          PE5     // USART1 TX (AF7) — J_BP pin 5
#define LORA_UART_RX_PIN          PE6     // USART1 RX (AF7) — J_BP pin 6
#define LORA_UART_BAUD            115200
#define SD_ROOT_DIR               "/"
#define SD_BURST_DIR_FMT          "/%04d-%02d-%02d/burst_%02d%02d%02d_%03d/"
#define MODEL_MEGADETECTOR_PATH   "/models/megadetector_v5_int8.tflite"
#define MODEL_SPECIES_PATH        "/models/awc_135sp_int8.tflite"
#define MODEL_MEGADETECTOR_SIZE   2621440  // ~2.5 MB
#define MODEL_SPECIES_SIZE        1572864  // ~1.5 MB
#define MODEM_MODEL               "EG800Q"
#define APN                       "telstra.m2m"
#define NETWORK_BAND              28        // 700 MHz AU terrestrial
#define D2C_BAND                  7         // 2600 MHz Starlink D2C (future)
typedef struct {
    char     unitId[16];
    char     smsNumber[20];
    char     mqttBroker[128];
    char     mqttTopic[64];
    char     apn[32];
    uint8_t  operatingMode;           // MODE_VALIDATION / PRODUCTION / RESEARCH
    float    aiConfidenceThreshold;
    float    megadetectorThreshold;
    uint8_t  healthCheckHour;
    uint8_t  healthCheckMinute;
    uint8_t  lowBattThresholdPct;
    uint8_t  burstFrameCount;
    uint8_t  aiInferenceFrames;
    uint8_t  alertOnSpecies;
    uint8_t  alertIncludeThumbnail;
    uint16_t pirLockoutS;
    char     fwVersion[12];
    char     modelVersion[32];        // AI model version string
    uint8_t  ledModuleType;           // Auto-detected from ID pin
} SystemConfig_t;
