tobbas75/trackline/(commit log)

2026-03-30 feat: unify Trackline into monorepo — 4 apps, shared packages, pnpm workspace
    Portal, WildTrack, Fire System, Trap Monitor unified under one repo.
    Shared packages: @trackline/ui, @trackline/supabase-config, @trackline/tsconfig, @trackline/eslint-config.
    Migration governance, schema docs, RLS audit, SEC-01 fix all included.
    [BOM.csv, BOM_Board1_PCB1_2026-03-30 1.xlsx, BOM_PCB.csv, BREADBOARD_BOM.csv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]
2026-03-30 fix: commit pnpm-lock.yaml for Vercel builds
    [pnpm-lock.yaml]
2026-03-31 security: fix search_path on 7 public functions + tighten incendiary_drop INSERT policy
